shodanx/Dosimeter-Ultra-Micron/Платы/Ультра_разработка_остановлена/PCB_5.01/ProjectOutputs/Assembly2.png

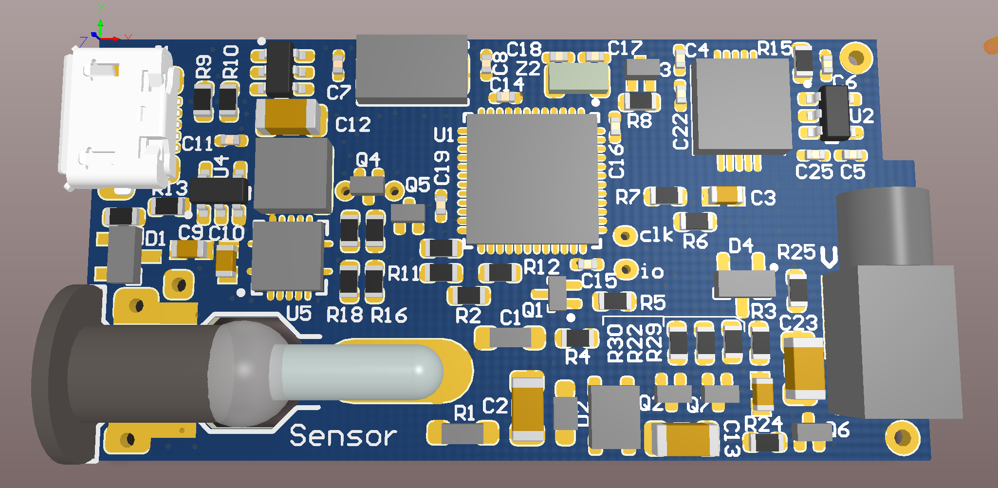
Платы/Ультра_разработка_остановлена/PCB_5.01/ProjectOutputs/Assembly2.png
