shodanx/Dosimeter-Ultra-Micron/readme.txt

ВНИМАНИЕ!!!
Новая прошивка оптимизированна под новую схемотехнику 4.06 и 5.01.
Требуется обязательная замена деталей:
C24 - GRM188R71H103KA01D
C3  - CC0603JRNPO9BN221
R6  - RC0603FR-07150KL
R7  - RC0603FR-074K53L
R29 - RC0603JR-07470RL
R30 - RC0603JR-07470RL
