shodanx/Dosimeter-Ultra-Micron/Ультра_разработка_остановлена/TPS62736)7_Design_Help_V1_2.xlsx

Sheet: 3-resistor
Note: Only valid for VIN_OK > VOUT
User Input | VBIAS | 1.21 | V
Fixed
 | Comparator thresholds for VOUT of buck
 | converter and input power good signal.
 | 1.3V < VOUT < 5.5V 2.0V < VIN_OK < 5.5V
Desired | RSUM1 | 13 | Mohm
Desired | VOUT | 3 | V
Desired | VIN_OK | 3.1 | V | >VOUT
 |  |  | closest 1% resistor1
 |  | Exact | < | >
Computed | R1 | 5.074 | 4.990 | 5.110 | Mohm
Computed | R2 | 0.169 | 0.169 | 0.174 | Mohm
Computed | R3 | 7.757 | 7.680 | 7.870 | Mohm
Computed | VOUT |  | 3.011 | 3.012 | V
Computed | VIN_OK |  | 3.113 | 3.115 | V
Selected | R1 | 5.1 | Mohm
Selected | R2 | 0.062 | Mohm
Selected | R3 | 7.5 | Mohm
Typ voltage | VOUT (typ) | 2.968 | V | -1.08 | % diff
Typ voltage | VIN_OK (typ) | 3.004 | V | -3.19 | % diff
 | 1If the available 1% resistors for the recommend resistor total (RSUM) produce too high of % difference, try using the closest 1% > and < resistor cross combo OR increasing or |  |  |  |  | 1% | 1%
 | decreasing RSUM in order to find a closer 1% resistor match OR adding 1 or more additional resistors and use two resistors in series that sum to the recommended value. |  |  |  |  | 10 | 10
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
