shodanx/Dosimeter-Ultra-Micron/Платы/Ультра_разработка_остановлена/PCB_5.00/share/readme.txt

Заказать платы можно тут: https://oshpark.com/shared_projects/7lkBk5aP
