shodanx/Dosimeter-Ultra-Micron/Платы/Ультра_разработка_остановлена/PCB_5.01/ProjectOutputs/readme.txt

Заказать платы можно тут: https://oshpark.com/shared_projects/ZgO3a8J9
