shodanx/Dosimeter-Ultra-Micron/Ультра_разработка_остановлена/Расчет токовой кривой, в проэкции на общее время работы дозика.pdf

9.2.2014 | Форум РадиоКот • Центр пользователя • Просмотр сообщений

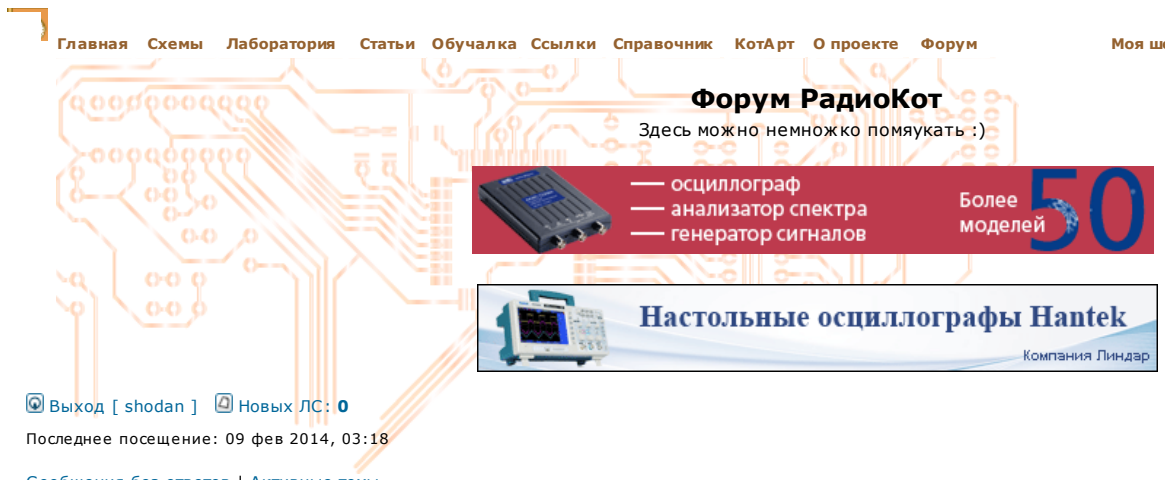
[picture p4: figure]
Форум РадиоКот; Здесь можно немножко помяукать :)
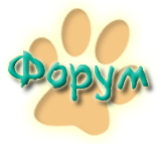
[picture p5: figure]

http://radiokot.ru/forum/ucp.php?i=pm&mode=view&f=-1&p=536878 | 1/4
Список форумов (http://radiokot.ru/forum/index.php) | Часовой пояс: UTC + 3 часа
Сообщения без ответов (http://radiokot.ru/forum/search.php?search_id=unanswered) | Активные темы (http://radiokot.ru/forum/search.php?search_id=active_topics) | Непрочитанные сообщения (http://radiokot.ru/forum/search.php?search_id=unreadposts) | Новые сообщения (http://radiokot.ru/forum/search.php?search_id=newposts) | Ваши сообщения (http://radiokot.ru/forum/search.php?search_id=egosearch)
Выход [ shodan ] (http://radiokot.ru/forum/ucp.php?mode=logout&sid=c923735fc91bc05e12e299eb70344504) | Новых ЛС: 0 (http://radiokot.ru/forum/ucp.php?i=pm&folder=inbox) | Правила (http://radiokot.ru/forum/viewtopic.php?f=19&t=6538) | FAQ (http://radiokot.ru/forum/faq.php) | Поиск (http://radiokot.ru/forum/search.php) | Пользователи (http://radiokot.ru/forum/memberlist.php) | Центр пользователя (http://radiokot.ru/forum/ucp.php)
Последнее посещение: 09 фев 2014, 03:18 | Текущее время: 09 фев 2014, 06:06

Настройки

Обзор (http://radiokot.ru/forum/ucp.php?i=171)
Профиль (http://radiokot.ru/forum/ucp.php?i=172)
Настройки форума (http://radiokot.ru/forum/ucp.php?i=173)
Личные сообщения
» Входящие (http://radiokot.ru/forum/ucp.php?i=pm&folder=inbox)
» Исходящие (1) (http://radiokot.ru/forum/ucp.php?i=pm&folder=outbox)
» Отправленные (http://radiokot.ru/forum/ucp.php?i=pm&folder=sentbox)
» Новое сообщение (http://radiokot.ru/forum/ucp.php?i=pm&mode=compose)
» Управление
черновиками (http://radiokot.ru/forum/ucp.php?i=pm&mode=drafts)
» Правила, папки и
настройки (http://radiokot.ru/forum/ucp.php?i=pm&mode=options)

Группы (http://radiokot.ru/forum/ucp.php?i=175)
Друзья и недоброжелатели (http://radiokot.ru/forum/ucp.php?i=176)

Друзья

В сети
Нет друзей в сети
Предыдущее ЛС в архиве (http://radiokot.ru/forum/ucp.php?i=pm&p=536927) | Следующее ЛС в архиве (http://radiokot.ru/forum/ucp.php?i=pm&p=536595) | Предыдущее ЛС (http://radiokot.ru/forum/ucp.php?i=pm&f=-1&p=536878&view=previous) | Следующее ЛС (http://radiokot.ru/forum/ucp.php?i=pm&f=-1&p=536878&view=next)
Тема сообщения: | Re: нанит
От: | shodan (http://radiokot.ru/forum/memberlist.php?mode=viewprofile&u=73030)
Отправлено: | 09 фев 2014, 00:49
Кому: | MadOrc (http://radiokot.ru/forum/memberlist.php?mode=viewprofile&u=83083)

Сообщение

Поимел накачку в разных позах, решил что коррекция относительно напряжения АКБ бессмысленна при питании 3.3В(нижний порог моего дозика) = 375 вольт
при питании 4.2В = 392 вольта
получается на весь диапазон дифирент всего-то = 17 вольт, фигня короче!

Проверил идею самоподстройки интервала времени, отладил саму накачку вроде все гуд. при обычной работе на одном и том-же напряжении питания, по моему гига-омм-замерялке шум(просадки между накачками) укладывается в 7-8 вольтов. что тоже весьма зачетно!

Главная (http://radiokot.ru/) Схемы (http://radiokot.ru/circuit) | Лаборатория (http://radiokot.ru/lab) | Статьи (http://radiokot.ru/articles) Обучалка (http://radiokot.ru/start) Ссылки (http://radiokot.ru/links) Справочник (http://radiokot.ru/inquiry) | КотАрт (http://radiokot.ru/art) О проекте (http://radiokot.ru/about) | Форум (http://radiokot.ru/forum) | Моя шерсть (http://radiokot.ru/profile/)

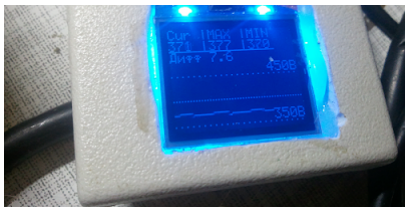
[picture p6: figure]
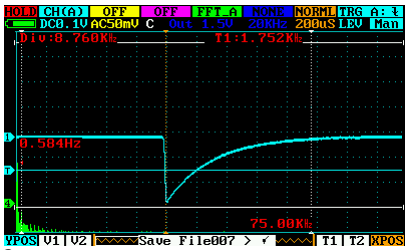
[picture p7: figure]

http://radiokot.ru/forum/ucp.php?i=pm&mode=view&f=-1&p=536878 | 2/4

Нет друзей в сети
Не в сети Wirehead Дмитрий2012 (http://radiokot.ru/forum/memberlist.php?mode=viewprofile&u=73240)

А ГЛАВНОЕ!!! калибровать напряжение очень удобно, при подключении тестера сразу видно реальное фактическое напряжение, при отключении идет небольшой выброс, потом за секунду все нормализуется, и через 10 сек, мы возвращаемся к интервалу 1 импульс накачки в 2-4 секунды.
Я на этот случай сделал исключение, если импульсов накачки очень много, то интервал между накачками резко сокращается.

Это снято с резистора накачки в момент качания, а терь я расскажу методу подсчета энергии на накачку.
Берем клеточку, смотрим где там среднее значение по вольтажу, считаем ток по клеточкам, с учетом того что граффик снят с резистора 33R. 7мА+3мА+2.1мА+1.5мА+1мА+0.5мА=15.6мА за период 1.2 мс
Такая накачка вызывается 1 раз в 2 секунды, значит скваженность равна
2/0.0012 = 1/1667
15.6мА/1667=9.35мкА среднее постоянное потребление накачки

за месяц это сожрет акб на 9.35мкА*24*30=6.73мА/ч, це ж есть эффиктивность мать ее! Правда одной конкретно взятой накачки, без учета проца и прочего обвеса.

С учетом ошибки измерения/вычесления, можно округлить до отедания емкости 7.5мА/ч за месяц работы на ЕРФ.
Значит, чтобы на моем АКБ 60 мАч устройство во сне работало 3 месяца, надо все остальные потери уложить в отедание не более 12.5 мА/ч за месяц. В принципе эта задача представляется мне вполне решаемой.

т.е. мы по сути посчитали токовую площадь кривой, и учли насколько часто этот расход появляется.

http://radiokot.ru/forum/ucp.php?i=pm&mode=view&f=-1&p=536878 | 3/4
Тема сообщения: Re: нанит | Папка: Исходящи (http://radiokot.ru/forum/ucp.php?i=pm&folder=-2)
Тема сообщения: Re: нанит | Папка: Отправленны (http://radiokot.ru/forum/ucp.php?i=pm&folder=-1)
Список форумов (http://radiokot.ru/forum/index.php) | Часовой пояс: UTC + 3 часа

т.е. мы по сути посчитали токовую площадь кривой, и учли насколько часто этот расход появляется.
и не надо никаких там тебе мультиметров, нужен хорошо калиброванный по вольтажу осцыл, пусть даже простой цифровой как у мя.

ТОЧНО ТАКЖЕ считается потребление всего дозика в целом, но с учетом еще постоянного тока сна.

Вложения:
IMAG007.png (http://radiokot.ru/forum/download/file.php?id=174561) [7.42 KiB]

Скачиваний: 16
2014-02-09 00.47.45.png (http://radiokot.ru/forum/download/file.php?id=174550) [244.55 KiB] Скачиваний: 27

_________________
Все наработки по проектам находятся у меня на сайте, и FTP. (см. профиль) С уважением R3PAV, всем 73!

Последний раз редактировалось shodan 09 фев 2014, 05:46, всего редактировалось 9 раз(а).

Для печати (http://radiokot.ru/forum/ucp.php?i=pm&f=-1&p=536878&view=print) | Входящие | Переместить в папку

История сообщений - Re: нанит

Автор | Сообщение
shodan (http://radiokot.ru/forum/memberlist.php?mode=viewprofile&u=73030)
недописал

Ранее на трансе в Альфа-Микроне я даже близко не подходил к таким показателям из за зазора, который требовал большие токи раскачки, хоть и кратковременные. Получалась пачка из 10-15 сверхтоковых всплесков. циферки принципиально иные.
А тут достаточно 1-го импульса который жрет не так уж и много.
про микрон-2 я уже говорил там в основном кушает DC-DC причем очень много! да и умножайка течет тремя кондерами а тут кондер 1 !

короче вот те пища для размышления
Отправлено: 09 фев 2014, 05:5

Посмотреть сообщение (http://radiokot.ru/forum/ucp.php?i=pm&f=-2&p=536927)
shodan (http://radiokot.ru/forum/memberlist.php?mode=viewprofile&u=73030)

Powered by phpBB (http://www.phpbb.com/) © 2000, 2002, 2005, 2007 phpBB Group Русская поддержка phpBB (http://bb3x.ru/)
Extended by Karma MOD (http://m157y.name/) © 2007—2012 m157y Extended by Topic Tags MOD (http://m157y.name/) © 2012 m157y

http://radiokot.ru/forum/ucp.php?i=pm&mode=view&f=-1&p=536878 | 4/4

Работоспособность сайта проверена в браузерах:
IE8.0, Opera 9.0, Netscape Navigator 7.0, Mozilla Firefox 5.0
Адаптирован для работы приразрешениях экрана от 1280х1024 и выше. Применьших разрешениях возможно появление горизонтальной прокрутки. По всем вопросам обращайтесь к Коту: kot@radiokot.ru ©2005-2014
