shodanx/Dosimeter-Ultra-Micron/foto/buiy6tfg2.jpg

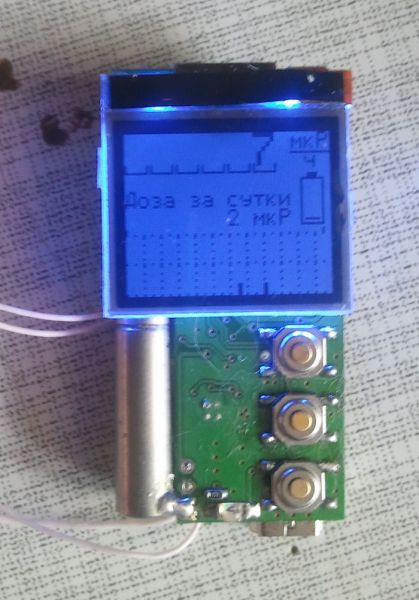
foto/buiy6tfg2.jpg
