shodanx/Dosimeter-Ultra-Micron/foto/c1zz0v28i.jpg

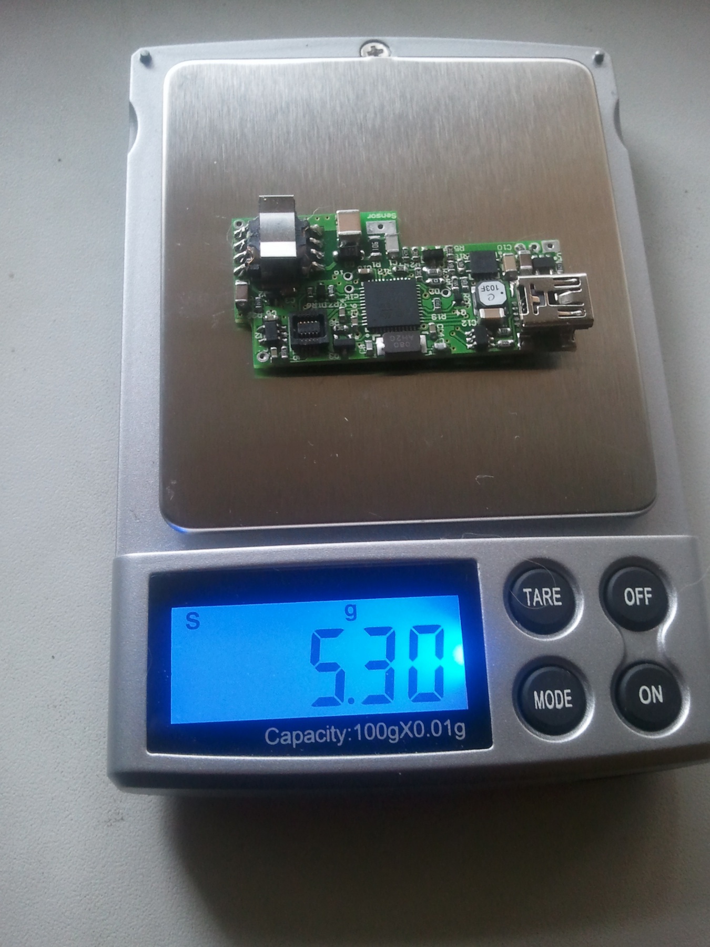
foto/c1zz0v28i.jpg
