shodanx/Dosimeter-Ultra-Micron/foto/c75gukmy7.jpg

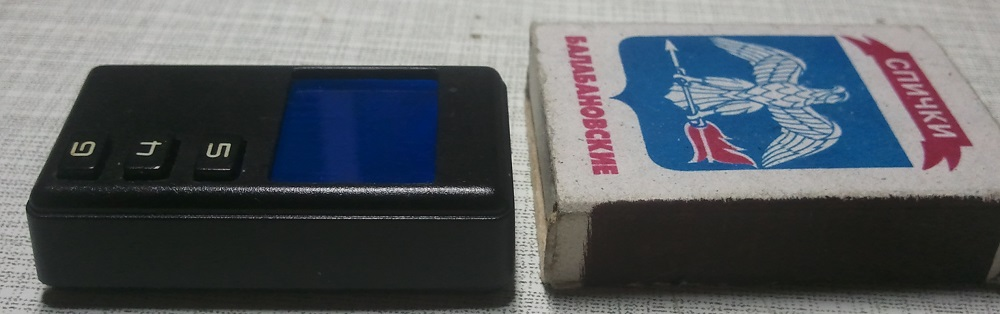
foto/c75gukmy7.jpg
