shodanx/Dosimeter-Ultra-Micron/foto/c75guoe4d.jpg

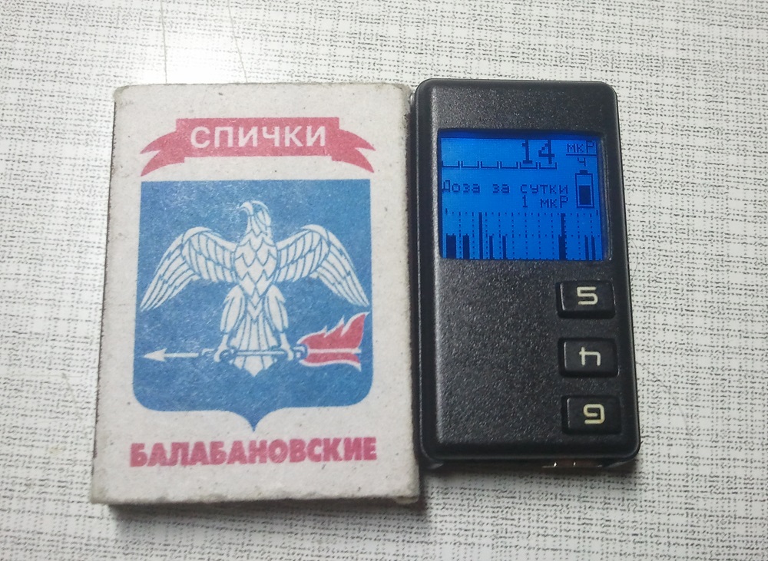
foto/c75guoe4d.jpg
