shodanx/Dosimeter-Ultra-Micron/foto/c75guspa1.jpg

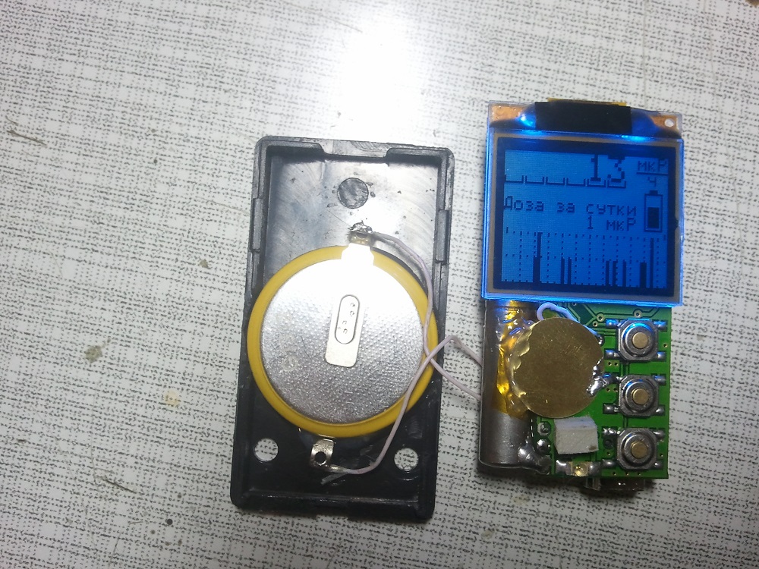
foto/c75guspa1.jpg
