shodanx/Dosimeter-Ultra-Micron/foto/cbergvxuc.JPG

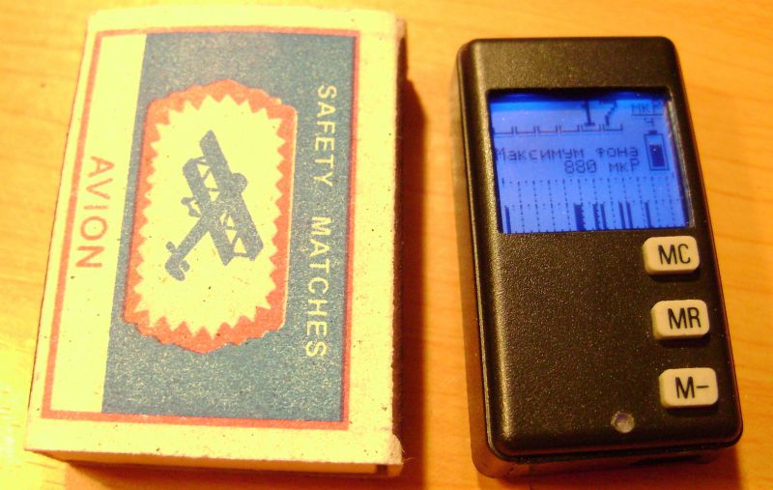
foto/cbergvxuc.JPG
