shodanx/Dosimeter-Ultra-Micron/foto/daniel13/IMG_2258.JPG

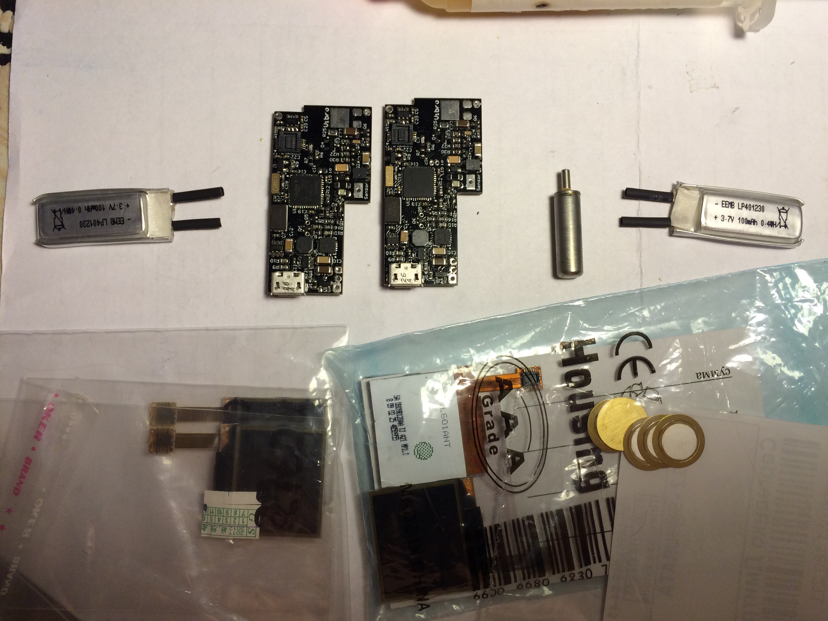
foto/daniel13/IMG_2258.JPG
