shodanx/Dosimeter-Ultra-Micron/foto/daniel13/IMG_2261.JPG

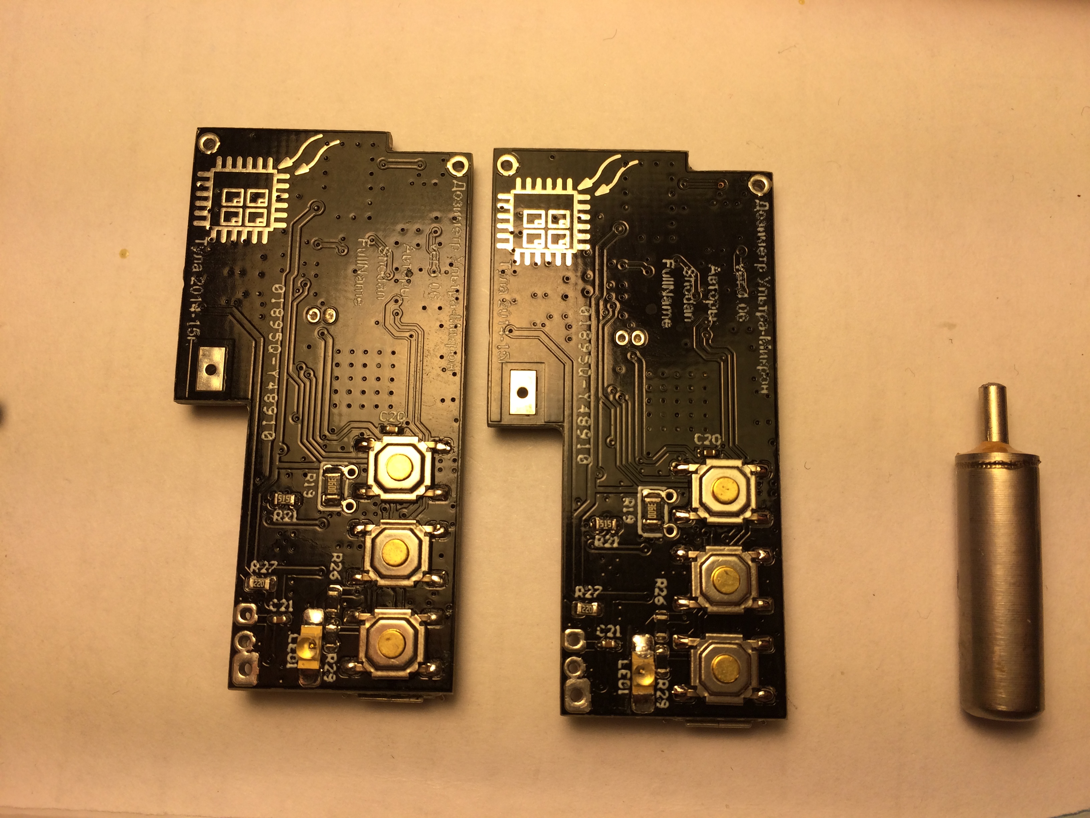
foto/daniel13/IMG_2261.JPG
