shodanx/Dosimeter-Ultra-Micron/foto/FullName/0_c64a0_bf9c8d35_XL.jpg

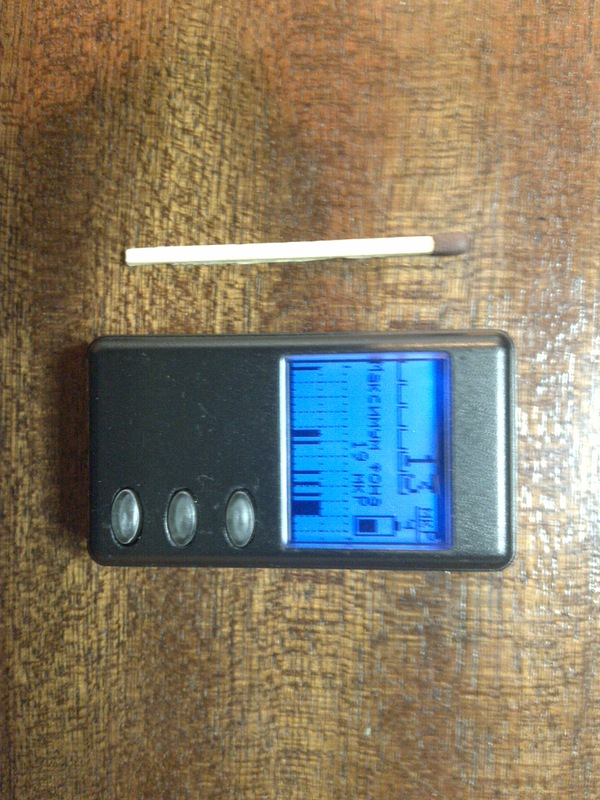
foto/FullName/0_c64a0_bf9c8d35_XL.jpg
