shodanx/Dosimeter-Ultra-Micron/foto/FullName/0_c553f_7884af77_XL.jpg

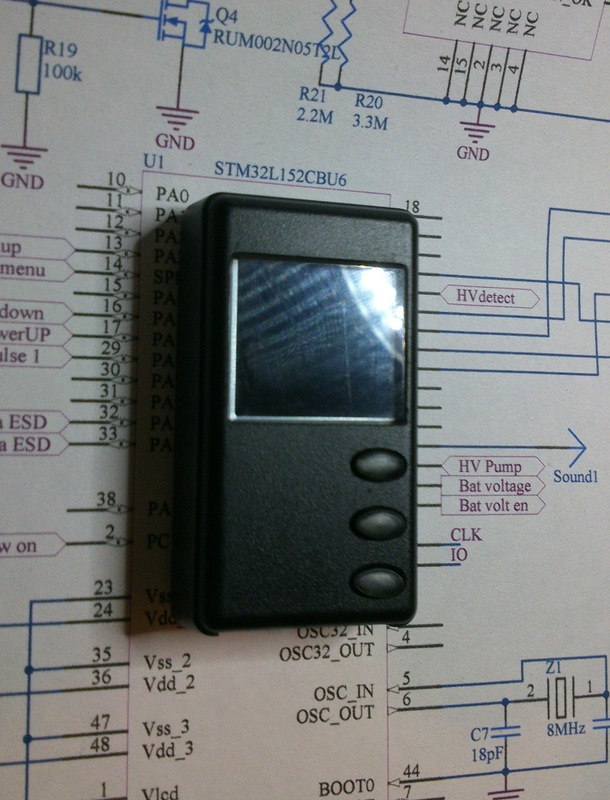
foto/FullName/0_c553f_7884af77_XL.jpg
