shodanx/Dosimeter-Ultra-Micron/foto/FullName/0_c649a_e8f3dfc0_XL.jpg

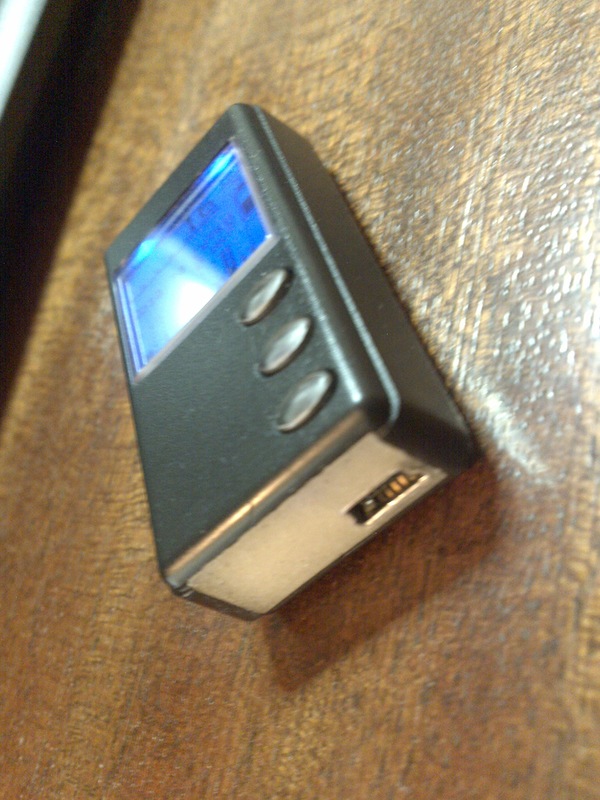
foto/FullName/0_c649a_e8f3dfc0_XL.jpg
