shodanx/Dosimeter-Ultra-Micron/foto/FullName/0_c649b_704d4964_XL.jpg

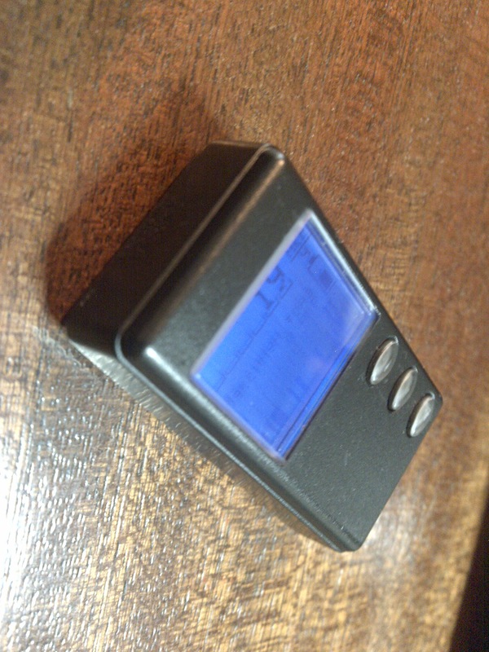
foto/FullName/0_c649b_704d4964_XL.jpg
