shodanx/Dosimeter-Ultra-Micron/foto/FullName/0_c649c_5c795b95_XL.jpg

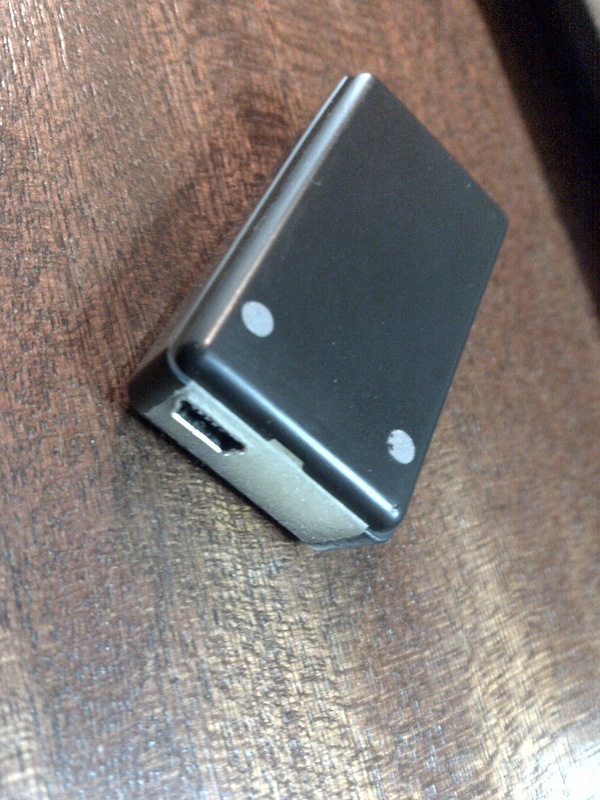
foto/FullName/0_c649c_5c795b95_XL.jpg
