shodanx/Dosimeter-Ultra-Micron/foto/FullName/0_c649e_258df4d4_XL.jpg

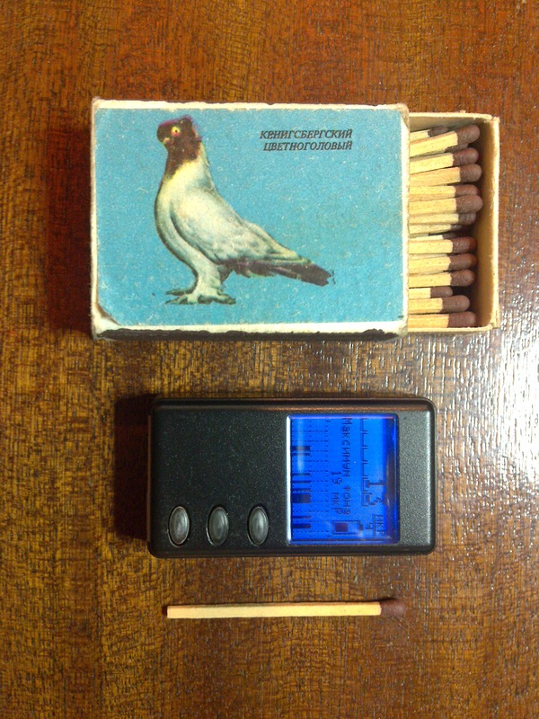
foto/FullName/0_c649e_258df4d4_XL.jpg
