shodanx/Dosimeter-Ultra-Micron/foto/FullName/0_c6496_6fbf92ec_XL.jpg

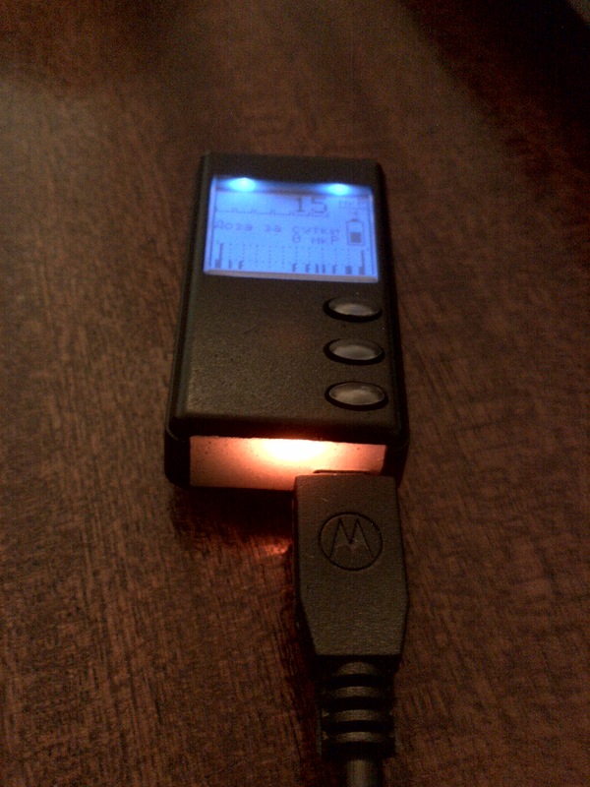
foto/FullName/0_c6496_6fbf92ec_XL.jpg
