shodanx/Dosimeter-Ultra-Micron/foto/FullName/0_c6497_fcf5d7cc_XL.jpg

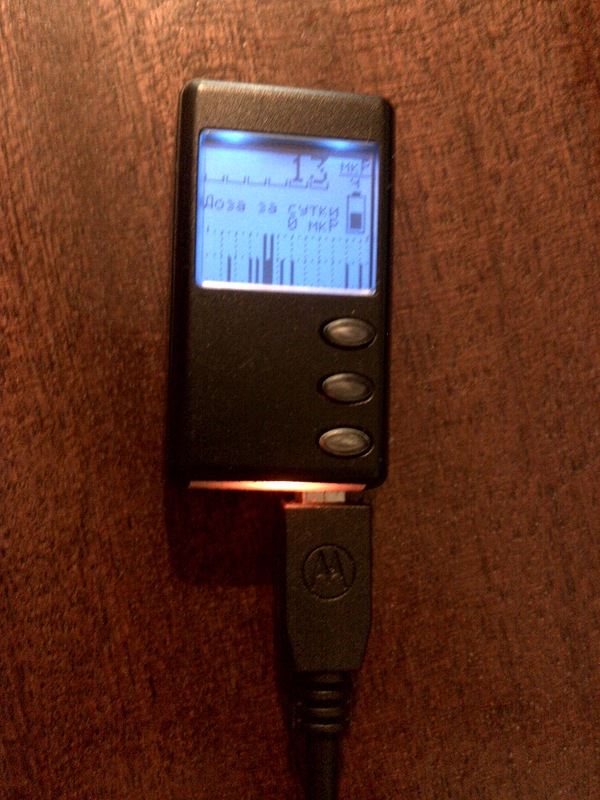
foto/FullName/0_c6497_fcf5d7cc_XL.jpg
