shodanx/Dosimeter-Ultra-Micron/foto/Hausser/2014/DSC07499.JPG

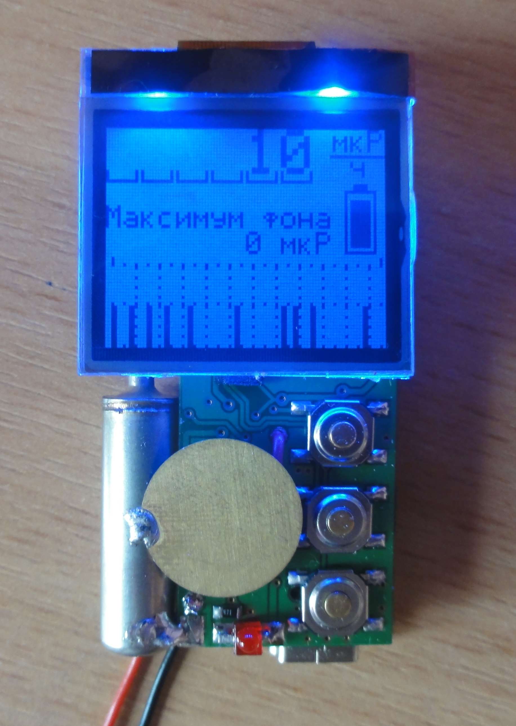
foto/Hausser/2014/DSC07499.JPG
