shodanx/Dosimeter-Ultra-Micron/foto/Hausser/2014/DSC07503.JPG

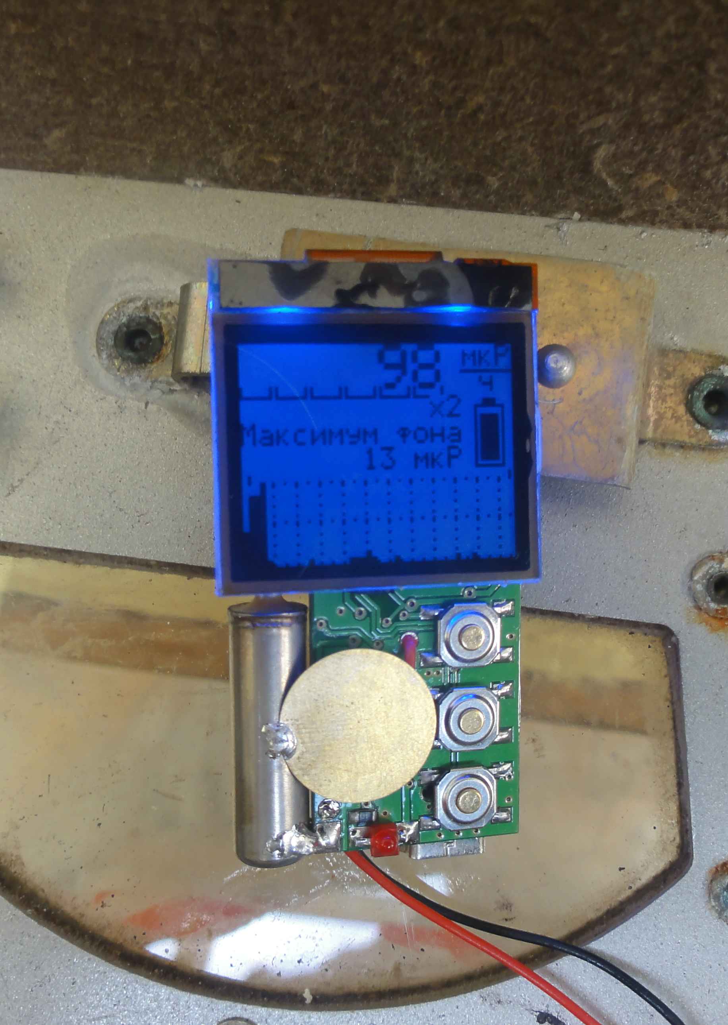
foto/Hausser/2014/DSC07503.JPG
