shodanx/Dosimeter-Ultra-Micron/foto/Hausser/2014/DSC07506.JPG

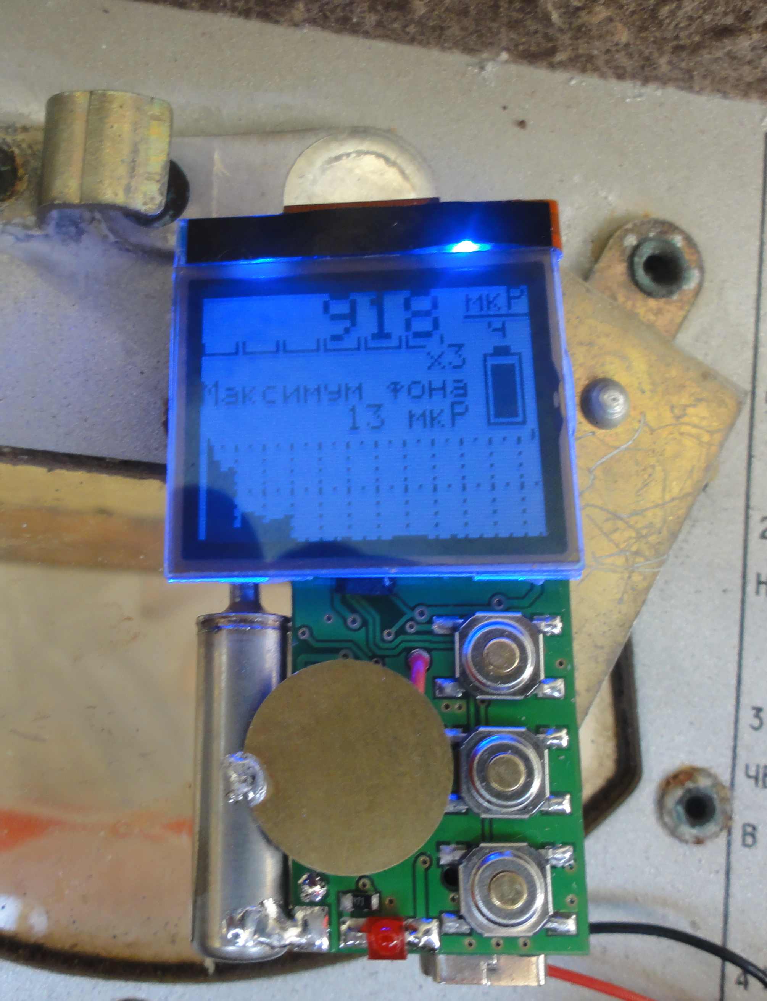
foto/Hausser/2014/DSC07506.JPG
