shodanx/Dosimeter-Ultra-Micron/foto/Hausser/2014/DSC07509.JPG

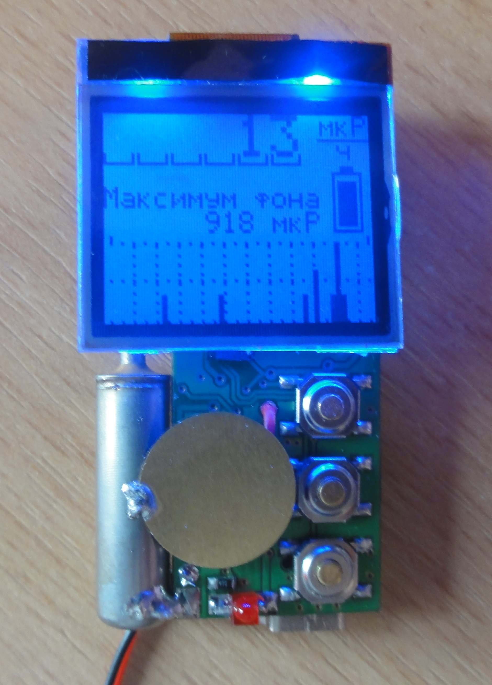
foto/Hausser/2014/DSC07509.JPG
