shodanx/Dosimeter-Ultra-Micron/foto/Hausser/2014/DSC07518.JPG

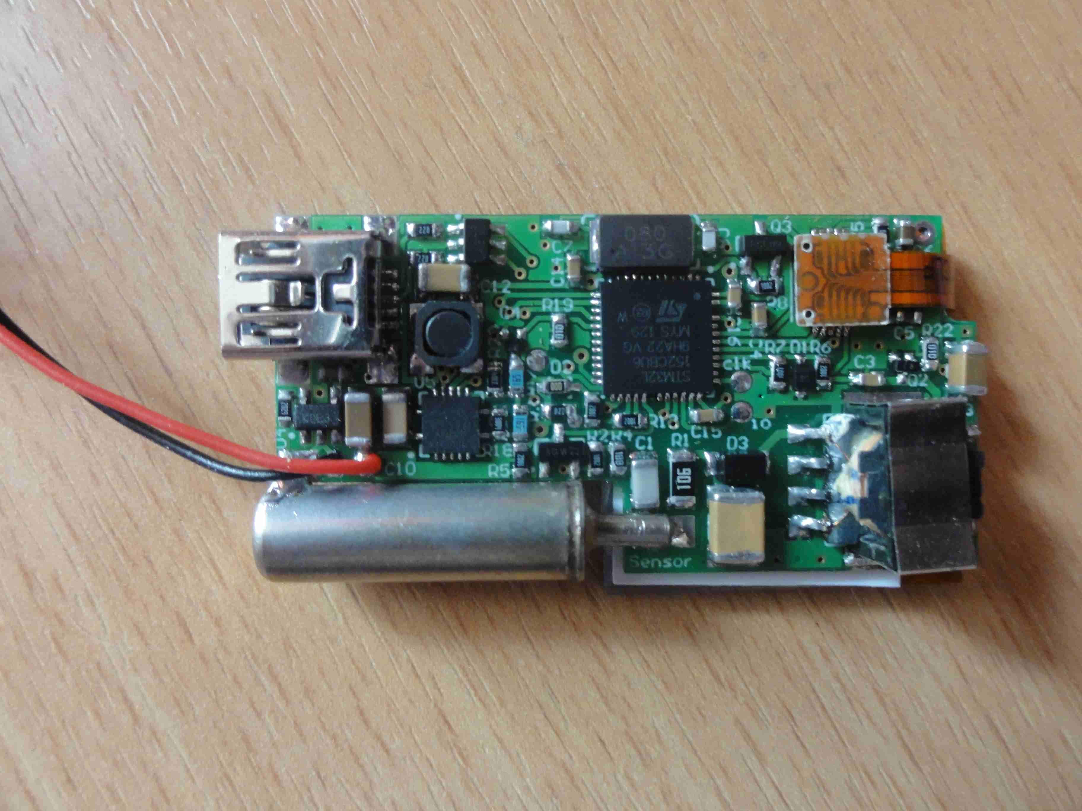
foto/Hausser/2014/DSC07518.JPG
