shodanx/Dosimeter-Ultra-Micron/foto/Hausser/2014/DSC07527.JPG

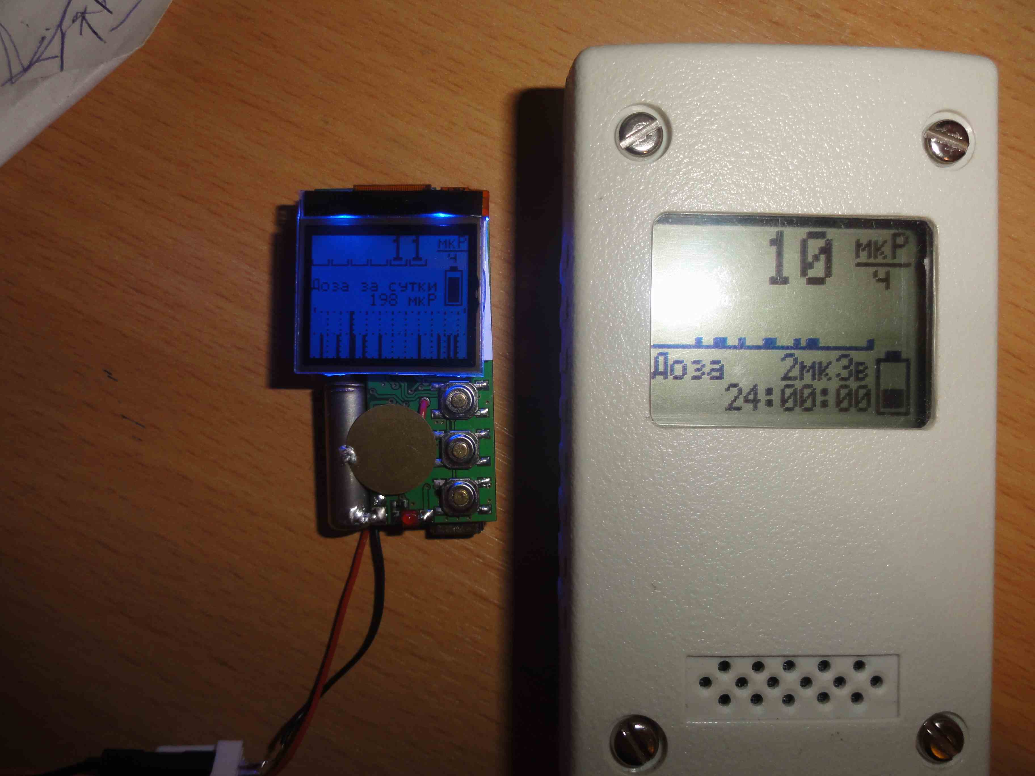
foto/Hausser/2014/DSC07527.JPG
