shodanx/Dosimeter-Ultra-Micron/foto/Hausser/2016/DSC08218.JPG

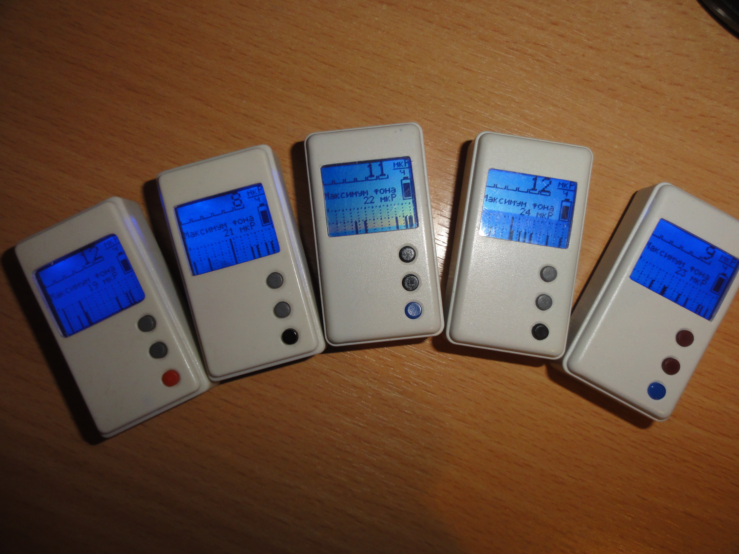
foto/Hausser/2016/DSC08218.JPG
