shodanx/Dosimeter-Ultra-Micron/foto/Hausser/2016/DSC08233.JPG

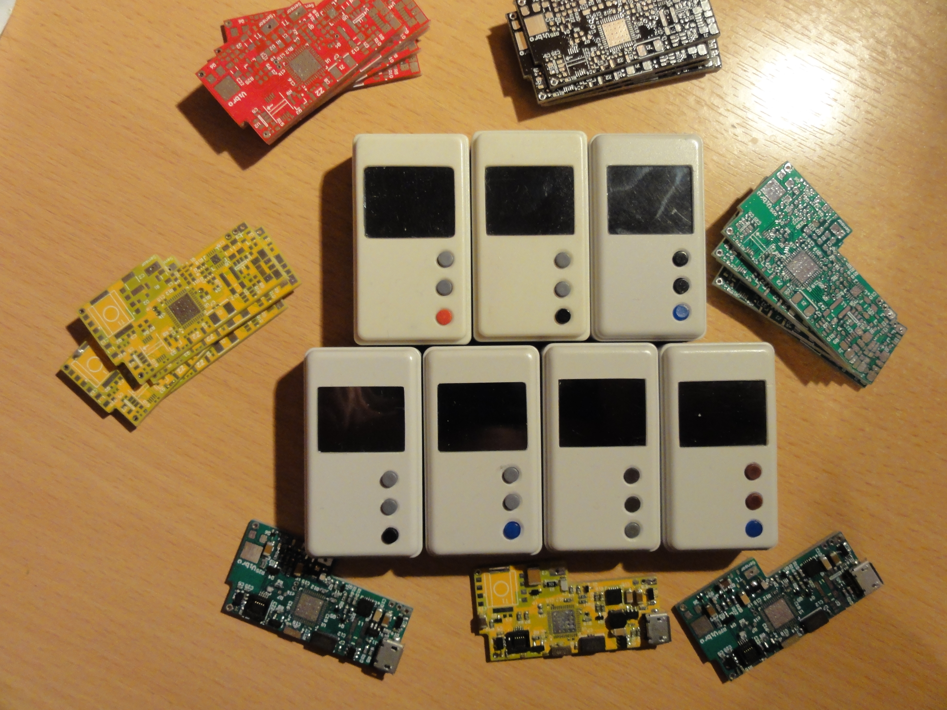
foto/Hausser/2016/DSC08233.JPG
