shodanx/Dosimeter-Ultra-Micron/foto/Hausser/2016/DSC08236.JPG

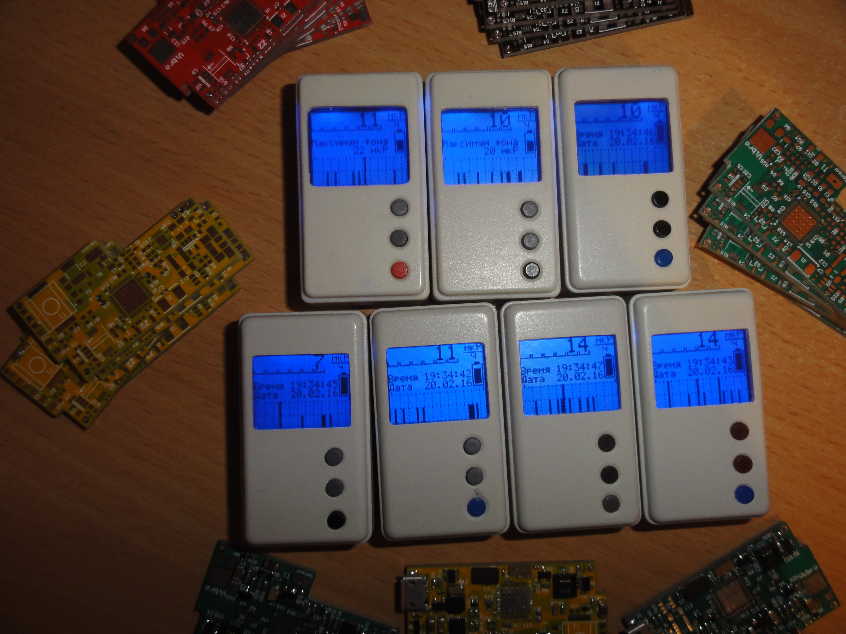
foto/Hausser/2016/DSC08236.JPG
