shodanx/Dosimeter-Ultra-Micron/foto/Hausser/2016/DSC08241.JPG

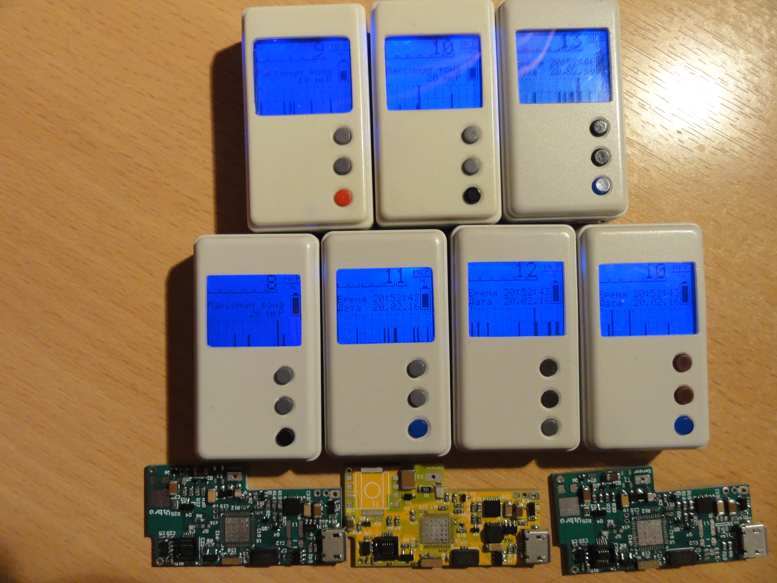
foto/Hausser/2016/DSC08241.JPG
