shodanx/Dosimeter-Ultra-Micron/foto/Hausser/2016/DSC08242.JPG

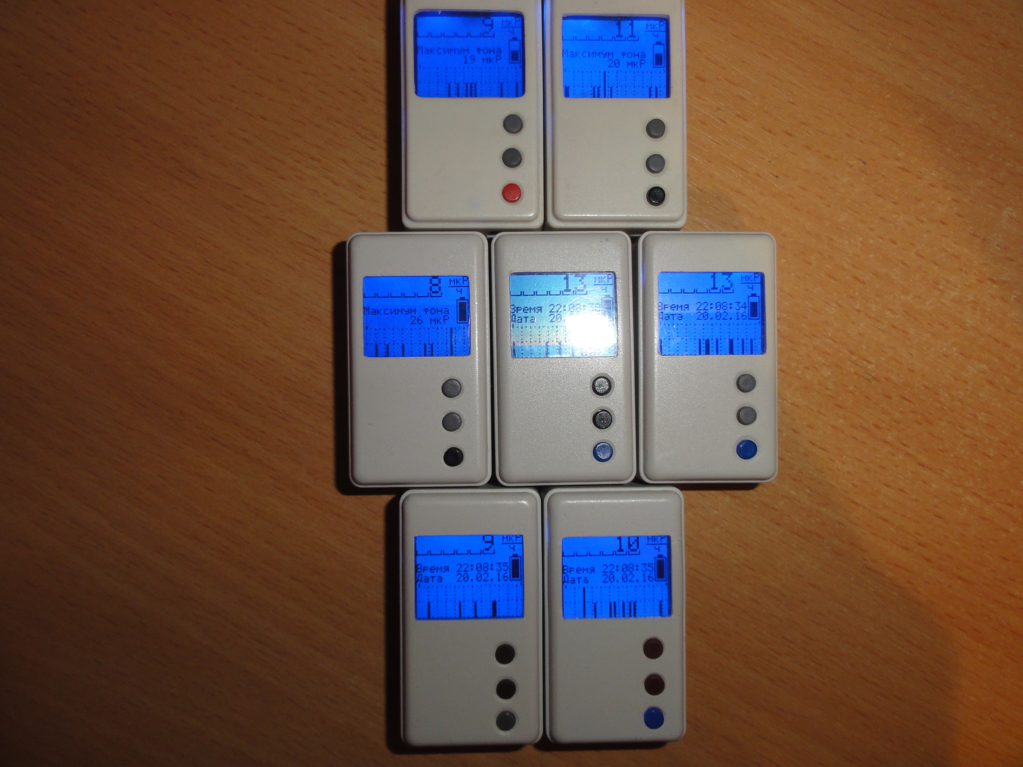
foto/Hausser/2016/DSC08242.JPG
