shodanx/Dosimeter-Ultra-Micron/foto/Nusik1975/2014-07-01 10.42.14.jpg

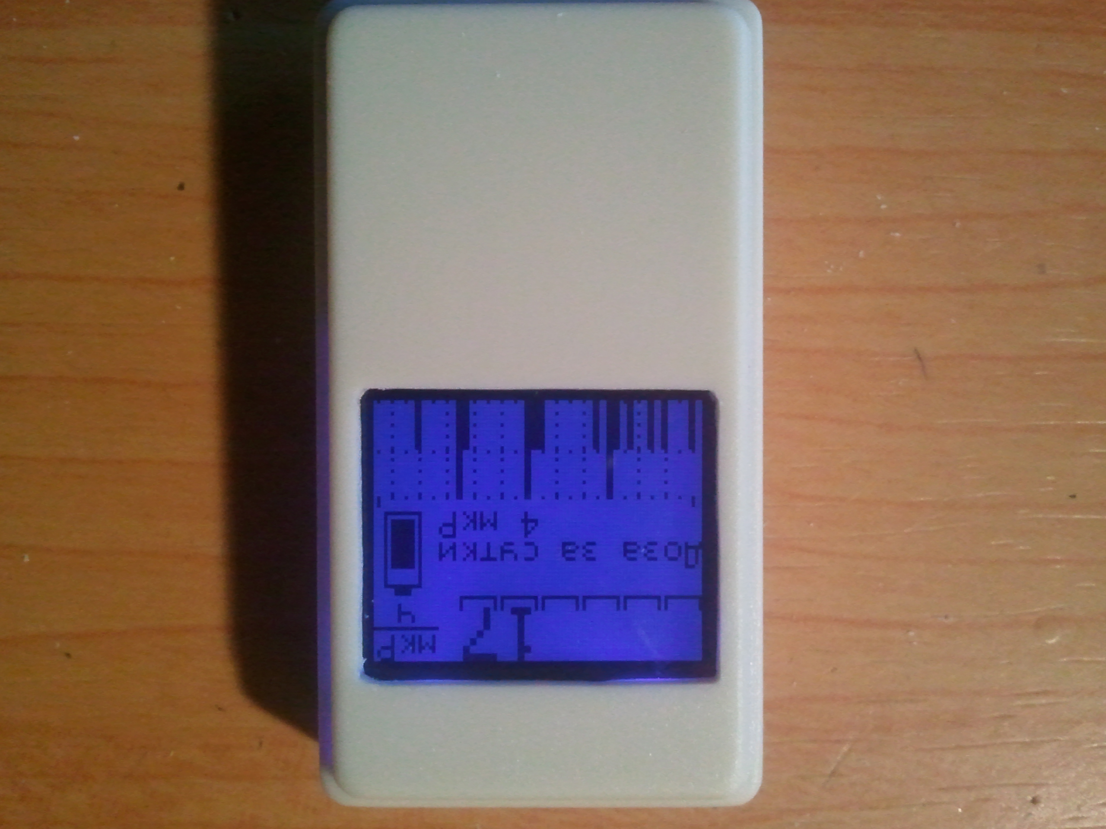
foto/Nusik1975/2014-07-01 10.42.14.jpg
