shodanx/Dosimeter-Ultra-Micron/foto/Nusik1975/2014-07-01 22.47.53.jpg

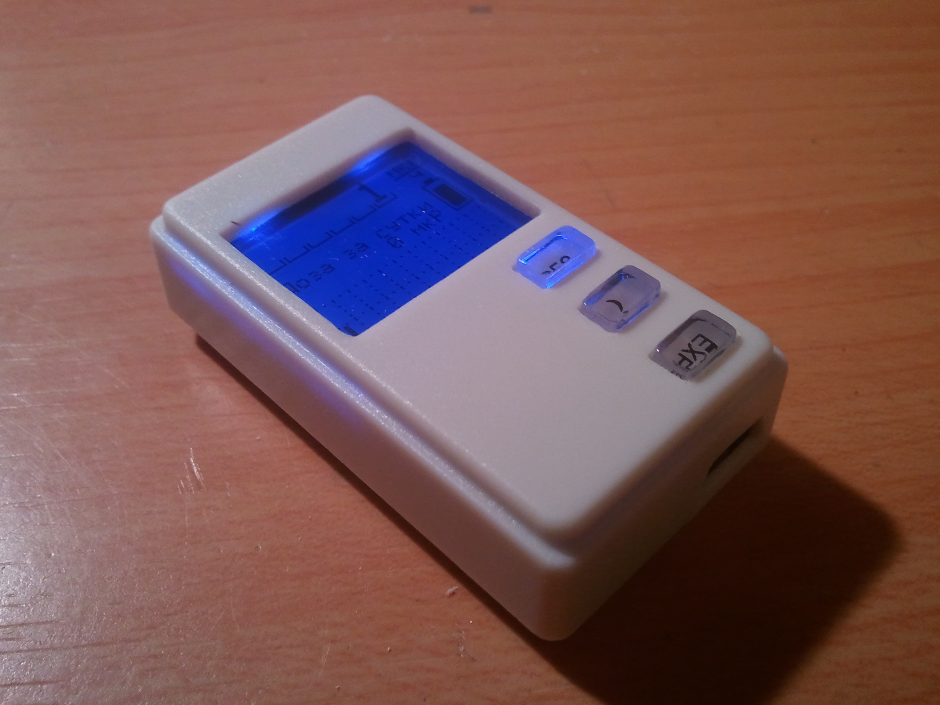
foto/Nusik1975/2014-07-01 22.47.53.jpg
