shodanx/Dosimeter-Ultra-Micron/foto/Nusik1975/DSC00402.JPG

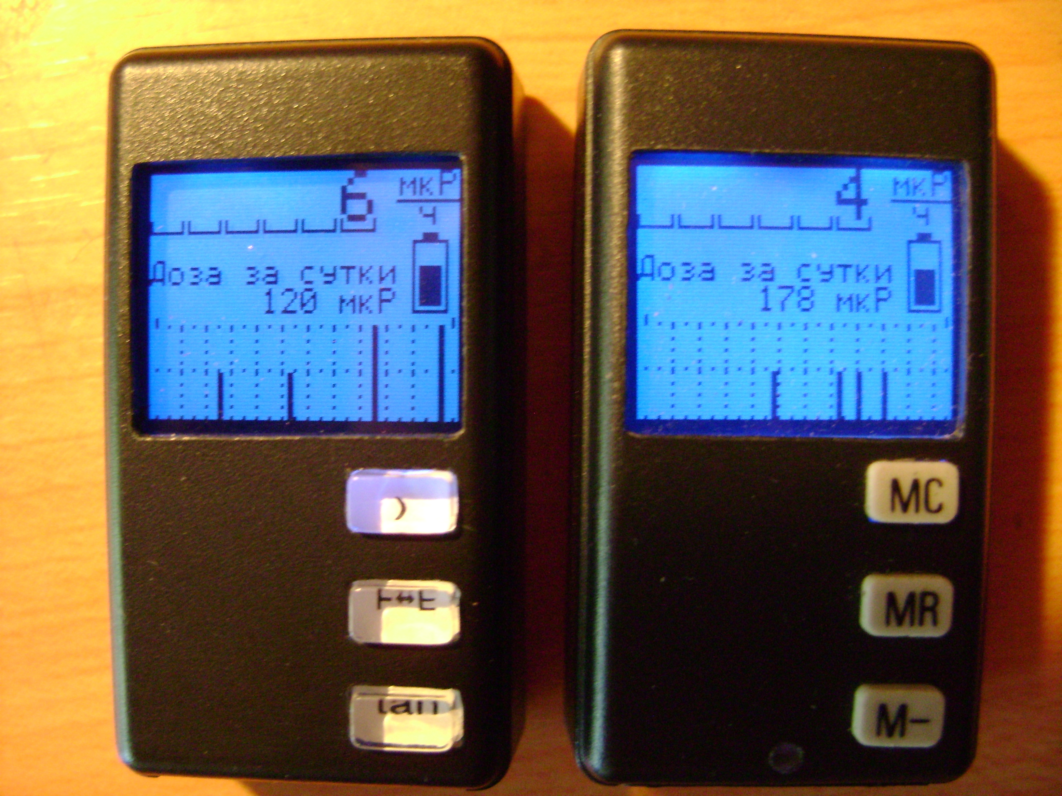
foto/Nusik1975/DSC00402.JPG
