shodanx/Dosimeter-Ultra-Micron/foto/Nusik1975/DSC00403.JPG

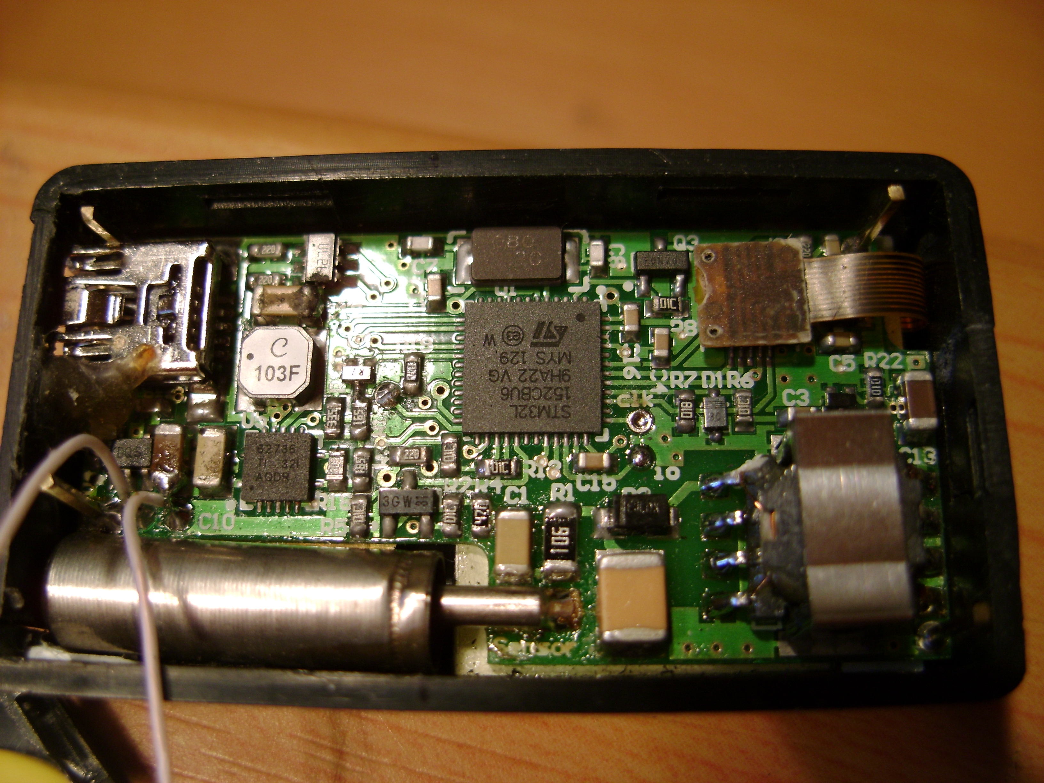
foto/Nusik1975/DSC00403.JPG
