shodanx/Dosimeter-Ultra-Micron/foto/X-RAY 5.01/Gamma-__+_.jpg

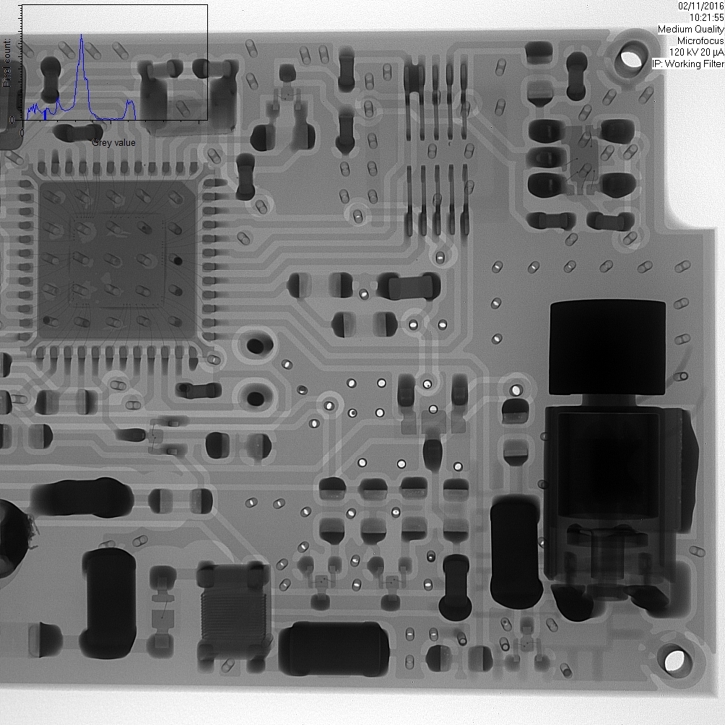
foto/X-RAY 5.01/Gamma-__+_.jpg
