shodanx/Dosimeter-Ultra-Micron/foto/X-RAY 5.01/Gamma-__.jpg

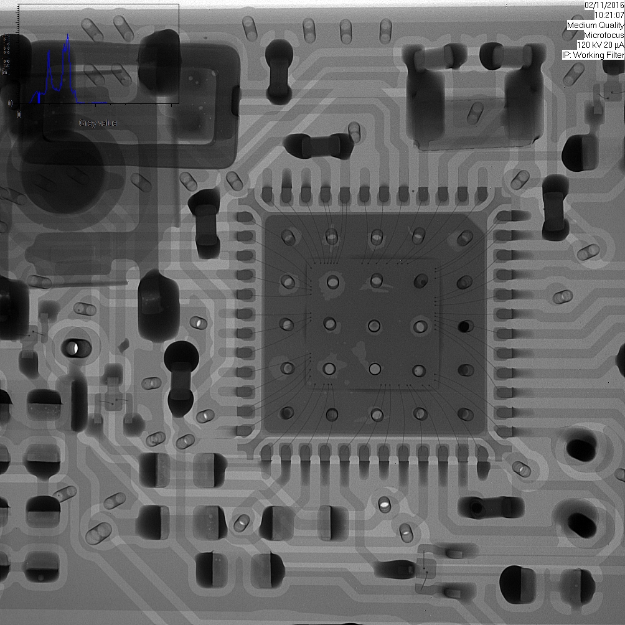
foto/X-RAY 5.01/Gamma-__.jpg
