shodanx/Dosimeter-Ultra-Micron/foto/X-RAY 5.01/Gamma-___+_.jpg

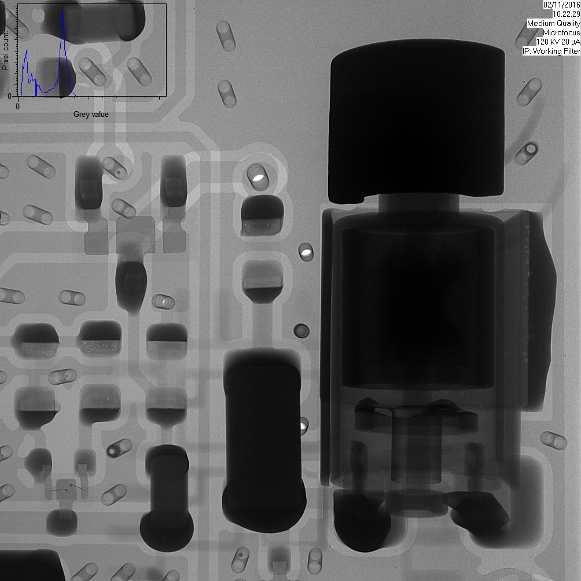
foto/X-RAY 5.01/Gamma-___+_.jpg
