shodanx/Dosimeter-Ultra-Micron/foto/X-RAY 5.01/Gamma.jpg

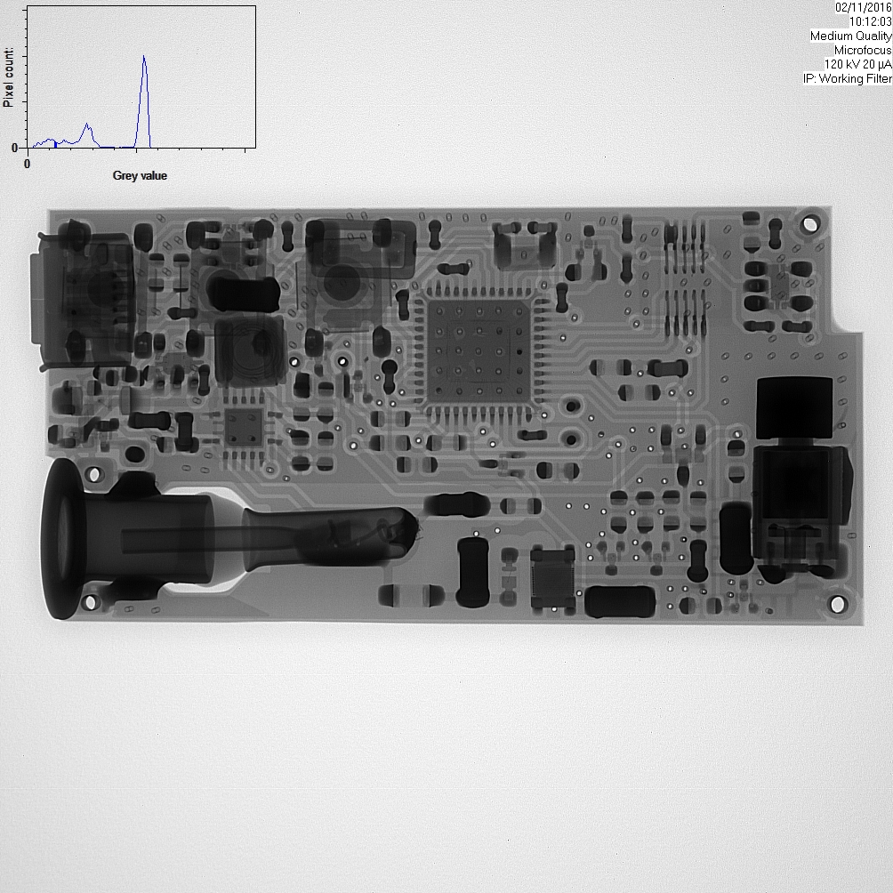
foto/X-RAY 5.01/Gamma.jpg
