shodanx/Dosimeter-Ultra-Micron/foto/X-RAY 5.01/Gamma__.jpg

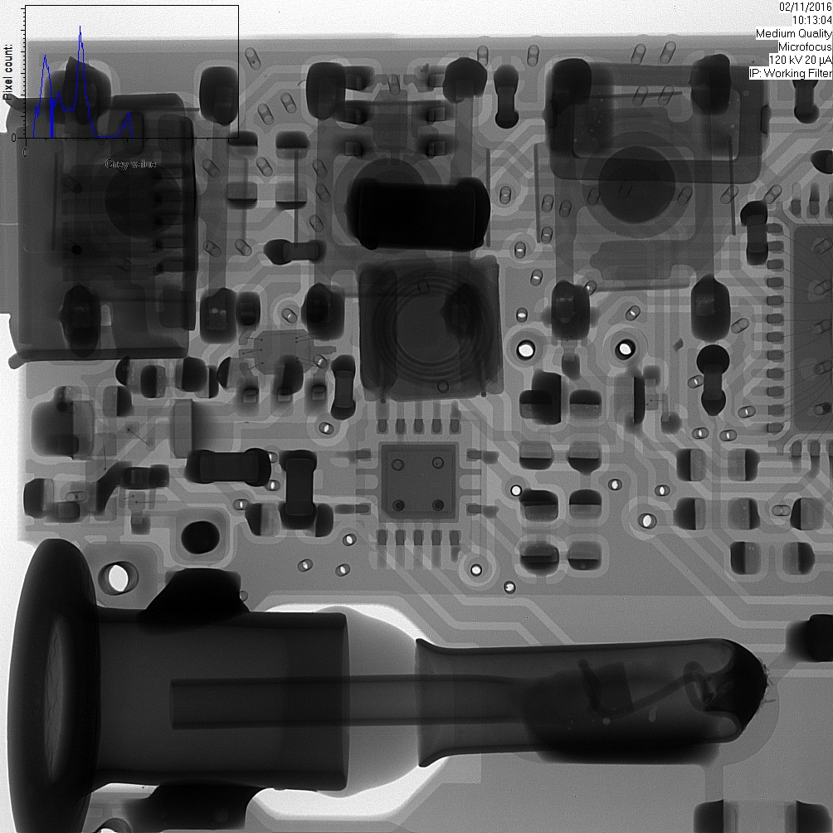
foto/X-RAY 5.01/Gamma__.jpg
