shodanx/Dosimeter-Ultra-Micron/Платы/PCB/scope_0.png

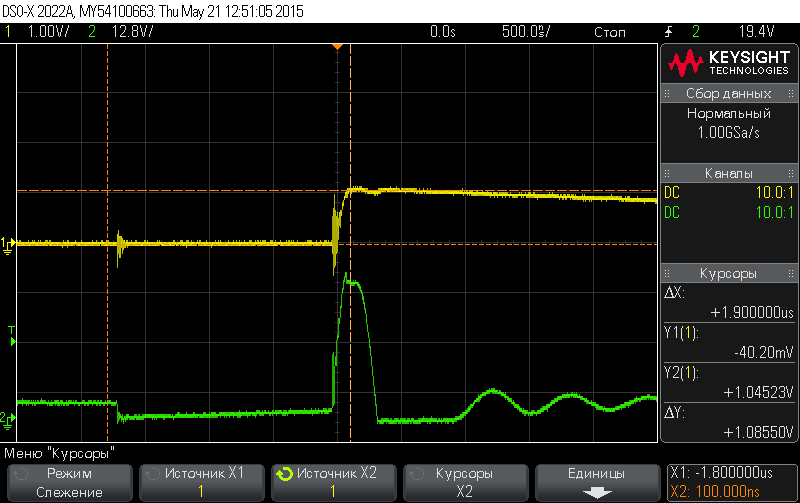
Платы/PCB/scope_0.png
