shodanx/Dosimeter-Ultra-Micron/Платы/PCB/scope_1.png

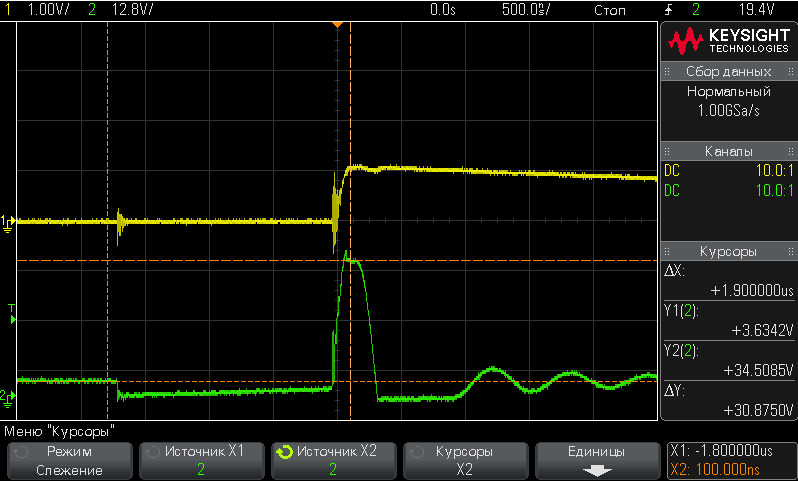
Платы/PCB/scope_1.png
