shodanx/Dosimeter-Ultra-Micron/Ультра_разработка_остановлена/2.png

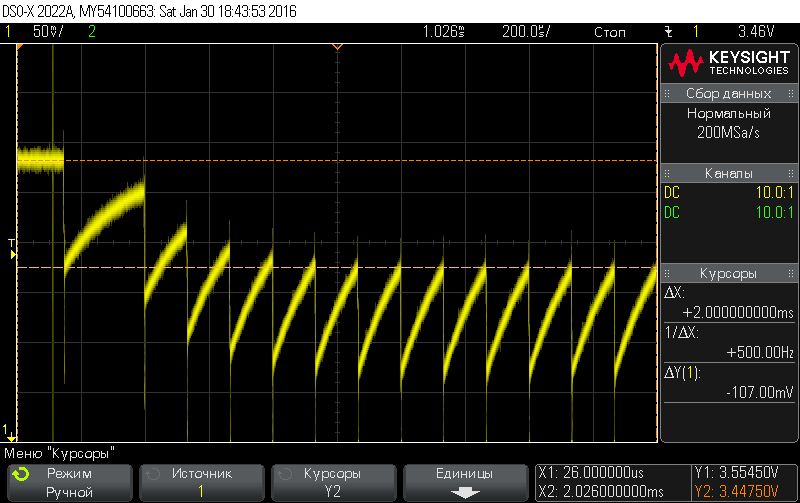
Ультра_разработка_остановлена/2.png
