shodanx/Dosimeter-Ultra-Micron/Ультра_разработка_остановлена/scope_1.png

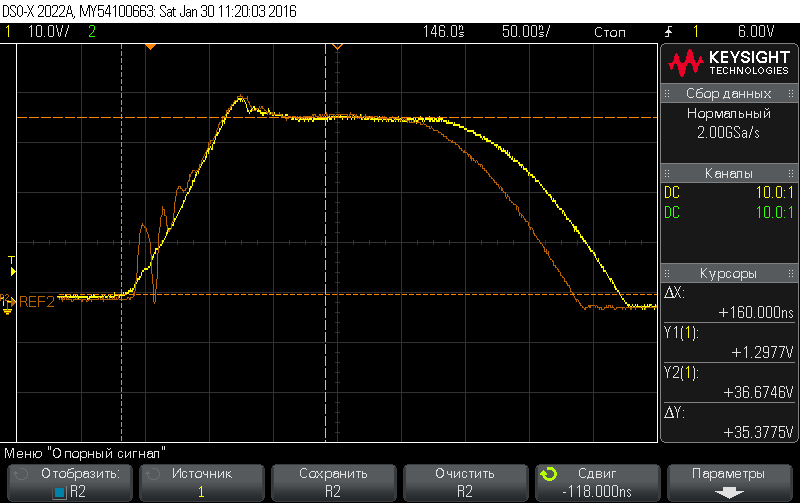
Ультра_разработка_остановлена/scope_1.png
