shodanx/Dosimeter-Ultra-Micron/Ультра_разработка_остановлена/scope_2.png

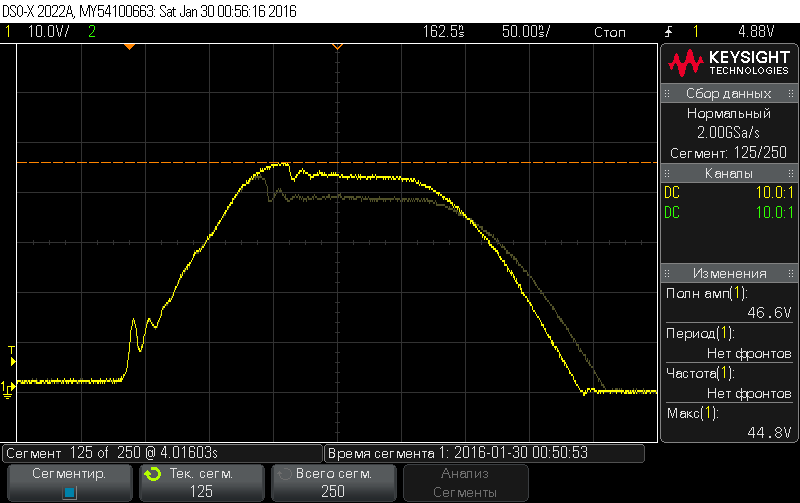
Ультра_разработка_остановлена/scope_2.png
