shodanx/Dosimeter-Ultra-Micron/Ультра_разработка_остановлена/scope_4.png

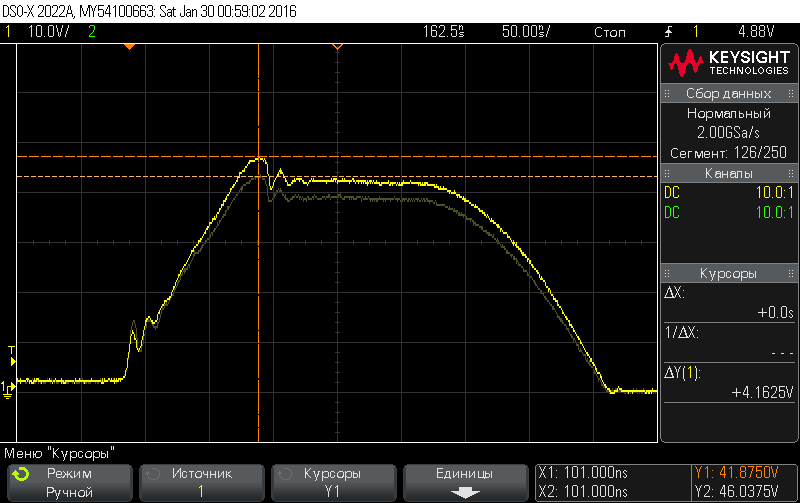
Ультра_разработка_остановлена/scope_4.png
