shodanx/Dosimeter-Ultra-Micron/Ультра_разработка_остановлена/scope_5.png

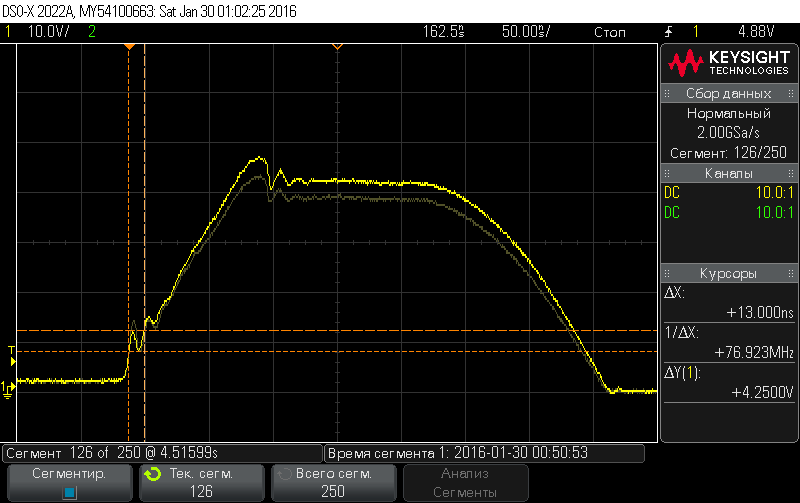
Ультра_разработка_остановлена/scope_5.png
