shodanx/Dosimeter-Ultra-Micron/Ультра_разработка_остановлена/scope_6.png

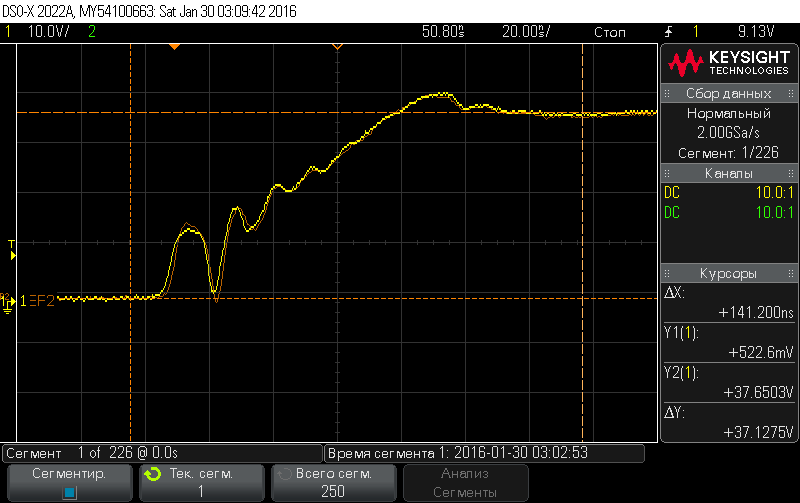
Ультра_разработка_остановлена/scope_6.png
