shodanx/Dosimeter-Ultra-Micron/Ультра_разработка_остановлена/TR.png

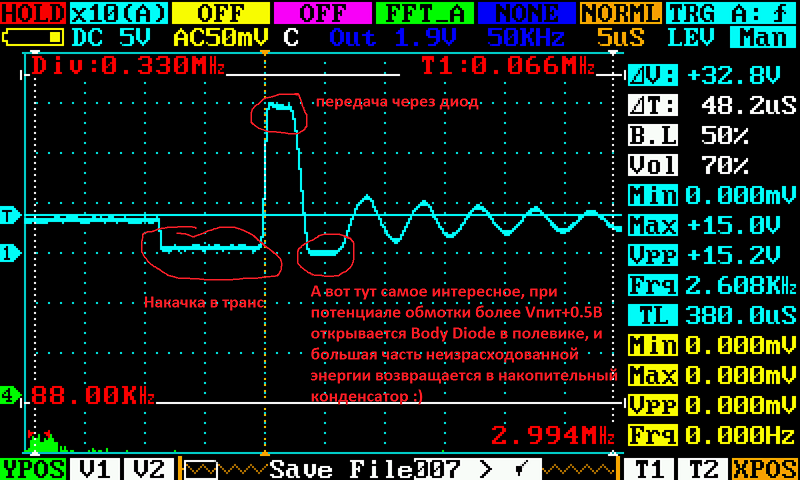
Ультра_разработка_остановлена/TR.png
