shodanx/Dosimeter-Ultra-Micron/Ультра_разработка_остановлена/Время на переключение диода.BMP

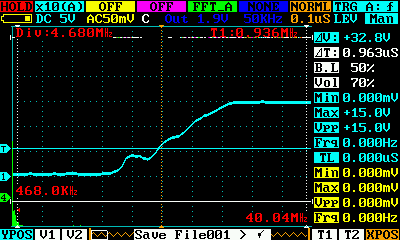
Ультра_разработка_остановлена/Время на переключение диода.BMP
