shodanx/Dosimeter-Ultra-Micron/Ультра_разработка_остановлена/СИ-19БГМ.png

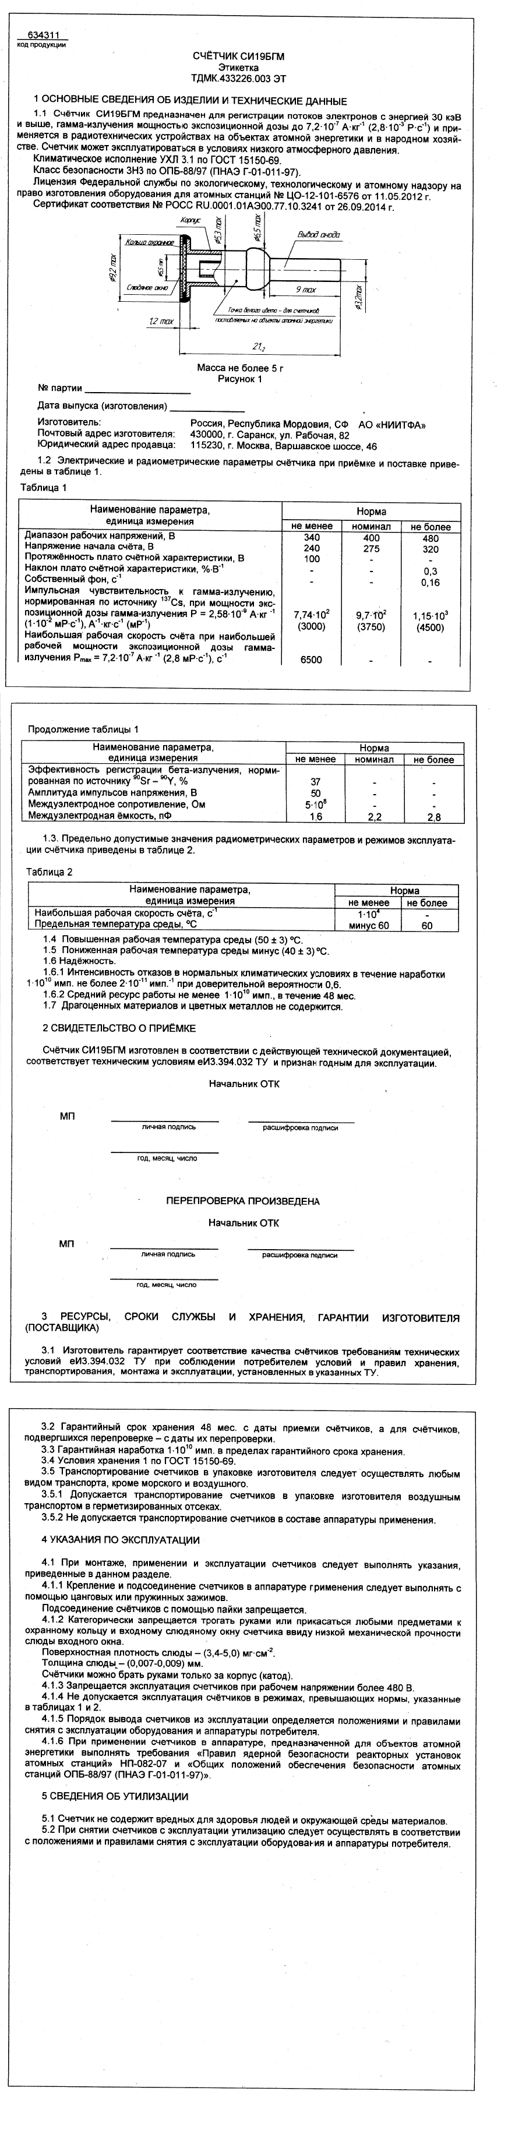
Ультра_разработка_остановлена/СИ-19БГМ.png
