shodanx/Dosimeter-Ultra-Micron/Ультра_разработка_остановлена/Ток потребления накачки.png

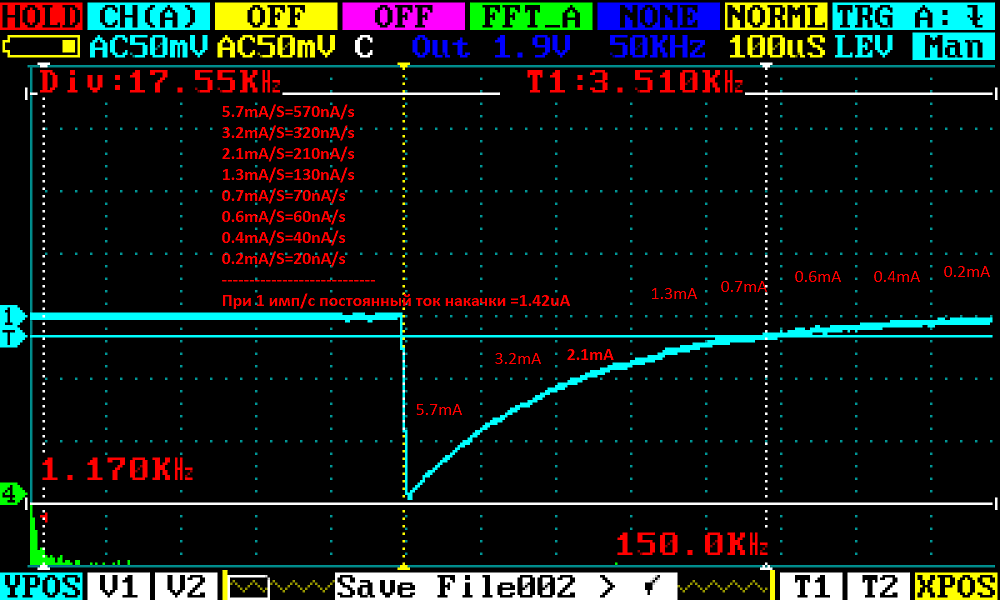
Ультра_разработка_остановлена/Ток потребления накачки.png
