shodanx/Dosimeter-Ultra-Micron/Расчет напряжения на компараторе.xlsx

Деталь | Номинал | еденица
С24 | 10000 | пФ
C3 | 220 | пФ
R6 | 195 | Ком
R7 | 5 | Ком
Падение на С13 | 0.23 | В |  |  |  |  | Vref | 1.224
D4 | 0.6 | В |  |  |  |  | Vref3/4 | 0.918
D2 | 2.5 | В |  |  |  |  | Vref1/2 | 0.612
 |  |  | Напряжение датчика | 405 | В |  | Vref1/4 | 0.306
 |  |  | Напряжение на трансе | 36.614 | В
Коэфицент | Значение |  | Напряжение на р.дел | 35.226 | В
Ктр | 11.2 |  | Напряжение на копм. | 0.881 | В | 0.037
Кконд.дел | 0.9784735812
Крез.дел | 0.025
