shodanx/Dosimeter-Ultra-Micron/Ультра_разработка_остановлена/потребление.xlsx

No | Time | DC/AC | Value | Unit | AUTO
1 | 15:27:35 |  | 0.01 | mA | AUTO
2 | 15:27:36 |  | 0.004 | mA | AUTO
3 | 15:27:37 |  | 0.004 | mA | AUTO
4 | 15:27:37 |  | 0.004 | mA | AUTO
5 | 15:27:38 |  | 0.004 | mA | AUTO
6 | 15:27:39 |  | 0.014 | mA | AUTO
7 | 15:27:39 |  | 0.024 | mA | AUTO
8 | 15:27:40 |  | 0.004 | mA | AUTO
9 | 15:27:41 |  | 0.004 | mA | AUTO
10 | 15:27:41 |  | 0.005 | mA | AUTO
11 | 15:27:42 |  | 0.006 | mA | AUTO
12 | 15:27:43 |  | 0.004 | mA | AUTO
13 | 15:27:43 |  | 0.004 | mA | AUTO
14 | 15:27:44 |  | 0.004 | mA | AUTO
15 | 15:27:45 |  | 0.012 | mA | AUTO
16 | 15:27:45 |  | 0.01 | mA | AUTO
17 | 15:27:46 |  | 0.004 | mA | AUTO
18 | 15:27:47 |  | 0.005 | mA | AUTO
19 | 15:27:47 |  | 0.002 | mA | AUTO
20 | 15:27:48 |  | 0.002 | mA | AUTO
21 | 15:27:49 |  | 0.004 | mA | AUTO
22 | 15:27:49 |  | 0.004 | mA | AUTO
23 | 15:27:50 |  | 0.005 | mA | AUTO
24 | 15:27:51 |  | 0.003 | mA | AUTO
25 | 15:27:51 |  | 0.002 | mA | AUTO
26 | 15:27:52 |  | 0.002 | mA | AUTO
27 | 15:27:53 |  | 0.002 | mA | AUTO
28 | 15:27:53 |  | 0.01 | mA | AUTO
29 | 15:27:54 |  | 0.004 | mA | AUTO
30 | 15:27:55 |  | 0.004 | mA | AUTO
31 | 15:27:55 |  | 0.003 | mA | AUTO
32 | 15:27:56 |  | 0.002 | mA | AUTO
33 | 15:27:57 |  | 0.006 | mA | AUTO
34 | 15:27:57 |  | 0.004 | mA | AUTO
35 | 15:27:58 |  | 0.004 | mA | AUTO
36 | 15:27:59 |  | 0.004 | mA | AUTO
37 | 15:27:59 |  | 0.004 | mA | AUTO
38 | 15:28:00 |  | 0 | mA | AUTO
39 | 15:28:01 |  | 0.014 | mA | AUTO
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
455 | 15:32:35 |  | 0.004 | mA | AUTO
456 | 15:32:36 |  | 0.006 | mA | AUTO
457 | 15:32:36 |  | 0.004 | mA | AUTO
458 | 15:32:37 |  | 0.004 | mA | AUTO
459 | 15:32:38 |  | 0.006 | mA | AUTO
460 | 15:32:38 |  | 0.004 | mA | AUTO
461 | 15:32:39 |  | 0.006 | mA | AUTO
 |  |  | 0.014202
