shodanx/Dosimeter-Ultra-Micron/Ультра_разработка_остановлена/Расчет цены дозика 03.11.2014.xlsx

Designator | Order | Quantity | Цена шт. | Перефасовка | Цена на дозик
Batt+1 | EEMB LP401230 | 1 | 70.00 | 250.00 ₽ | 70.00 ₽ | (с учетом доставки)
Доставка Элитана |  | 1 |  | 295.00 ₽ | 0.00 ₽
C1 | CC1206JRNPOBBN100 | 1 | 3.13 | 10.00 ₽ | 3.13 ₽
C2 | 1812AC103KAT1A | 1 | 10.00 | 10.00 ₽ | 10.00 ₽
C3 | GRM188R71E104KA01D | 1 | 1.55 | 10.00 ₽ | 1.55 ₽
C4, C14, C15, C16, C19, C22 | 0402ZD104KAT2A | 6 | 2.74 | 10.00 ₽ | 16.44 ₽
C5, C6, C11, C20, C21 | CC0402KRX5R5BB105 | 5 | 2.12 | 10.00 ₽ | 10.60 ₽
C7, C8 | GRM1555C1H180JZ01D | 2 | 2.19 | 10.00 ₽ | 4.38 ₽
C9 | CC1206KKX7R8BB475 | 1 | 3.49 | 10.00 ₽ | 3.49 ₽
C10 | CC1206KKX7R0BB104 | 1 | 1.75 | 10.00 ₽ | 1.75 ₽
C12 | GRM31CR61E226KE15L | 1 | 7.72 | 10.00 ₽ | 7.72 ₽
C13 | GRM31CR61A106KA01L | 1 | 3.73 | 10.00 ₽ | 3.73 ₽
C17, C18 | GRM1555C1H100JA01D | 2 | 2.02 | 10.00 ₽ | 4.04 ₽
D1 | PMEG4005CT | 1 | 29.00 | 100.00 ₽ | 29.00 ₽
D2 | DA2JF8100L | 1 | 24.30 | 100.00 ₽ | 24.30 ₽
Display1 | Nokia 2760 ext + Socket Hirose DF23C-10DS-0.5V | 1 | 43.00 |  | 43.00 ₽
J1 | Molex 47346-0001 | 1 | 30.60 | 10.00 ₽ | 30.60 ₽
KEY1, KEY2, KEY3 | IT-1187-160GM-G | 3 | 19.20 | 10.00 ₽ | 57.60 ₽
L1 | IFSC1515AHER100M01 | 1 | 22.20 | 10.00 ₽ | 22.20 ₽
L2 | LB2518T681K | 1 | 19.80 | 100.00 ₽ | 19.80 ₽
LED1 | KPTD-3216SECK | 1 | 15.70 | 100.00 ₽ | 15.70 ₽
Q1 | BC857CT | 1 | 1.13 | 10.00 ₽ | 1.13 ₽
Q2, Q4 | PMR400UN | 2 |  |  | 0.00 ₽
Q3 | IRLML6401 | 1 | 5.25 | 10.00 ₽ | 5.25 ₽
Q5 | BC847CT | 1 | 2.45 | 10.00 ₽ | 2.45 ₽
R1 | RV1206JR-0710ML | 1 | 33.20 | 100.00 ₽ | 33.20 ₽
R2, R5, R6, R8, R11, R12 | RC0603FR-1010KL | 6 |  |  | 0.00 ₽
R3, R9, R10, R15 | CR0603-JW-220GLF | 4 | 6.09 | 100.00 ₽ | 24.36 ₽
R4 | RC0603FR-071K5L | 1 | 1.46 | 10.00 ₽ | 1.46 ₽
R7, R23 | RC0603FR-101KL | 2 |  |  | 0.00 ₽
R13 | RC0603JR-0762KL | 1 | 1.48 | 10.00 ₽ | 1.48 ₽
R14 | RC0603JR-07470RL | 1 | 1.46 | 10.00 ₽ | 1.46 ₽
R16, R17 | RC0603FR-071M6L | 2 | 1.47 | 10.00 ₽ | 2.94 ₽
R18 | RC0603FR-073ML | 1 | 1.48 | 10.00 ₽ | 1.48 ₽
R20 | RC0603FR-073M3L | 1 | 1.46 | 10.00 ₽ | 1.46 ₽
R21 | RC0603FR-072M2L | 1 | 1.46 | 10.00 ₽ | 1.46 ₽
R22 | RC0603FR-10100KL | 1 |  |  | 0.00 ₽
Sensor | SBM-10 | 1 | 500.00 | 250.00 ₽ | 500.00 ₽ | (с учетом доставки)
Sound1, Sound2 | 7BB-12-9 | 1 | 7.86 | 10.00 ₽ | 7.86 ₽
T1 | B65523J0000R087 + B65527B1008T001 + B65527A2000X000 | 1 | 180.00 | 50.00 ₽ | 180.00 ₽ | (только партиями 100шт)
U1 | STM32L152CBU6 | 1 | 160.00 | 10.00 ₽ | 160.00 ₽
U2 | TPS60400DBV | 1 | 18.60 | 10.00 ₽ | 18.60 ₽
U3 | USBLC6-2 | 1 | 5.22 | 10.00 ₽ | 5.22 ₽
U4 | MCP73831T-2ACI/OT | 1 | 33.00 | 10.00 ₽ | 33.00 ₽
U5 | TPS62736RGYT | 1 | 154.00 | 100.00 ₽ | 154.00 ₽
Z1 | ABM7-8.000MHZ-D2Y-T | 1 | 59.50 | 10.00 ₽ | 59.50 ₽
Z2 | ABS10-32.768KHZ-7-T | 1 | 79.90 | 100.00 ₽ | 79.90 ₽
 | Корпус | 1 | 50.00 | 50.00 ₽ | 50.00 ₽ | (с учетом доставки)
 |  |  |  | 1995.00 ₽ | 1705.24 ₽ |  | 3700.24
Затрачено часов | 320.00 ₽ | Материалы (припой, флюс, отмывочные жидкости, электроэнергия, плата)
5 | 1300.00 ₽ | Стоимость пайки
1 | 260.00 ₽ | Стоимость отмывки
4 | 1040.00 ₽ | Стоимость распила корпуса
1.5 | 390.00 ₽ | Стоимость прошивки и тестирования
 | 150.00 ₽ | Доставка
 |  |  |  | Курс доллара |  |  | 45
Итого, с учетом расфасовки*1 и работы |  | 7160.24 ₽ |  | Установленная цена за устройство |  |  | 6500.00 ₽ | $144.44
С учетом расфасовки/10, работы и доставки |  | 5364.74 ₽ |  | Часовая ставка | 260.00 ₽
Цена 10-ти дозиков |  | 53647.40 ₽
