shodanx/Dosimeter-Ultra-Micron/Ультра_разработка_остановлена/Расчет цены дозика 08.04.2016.xlsx

Компанент | кол-во | цена за шт | итого
LP401230 | 1 | 162.00 ₽ | 162.00 ₽ | Стоимость корпусов
VJ0805A100JXGAT5Z | 1 | 162.00 ₽ | 162.00 ₽ | Работа | цена | штук | итог
1206CC103KAT1A | 1 | 97.50 ₽ | 97.50 ₽ | Фрезировка | 200 ₽ | 42 | 8400 ₽
CC0603JRNPO9BN221 | 1 | 3.47 ₽ | 3.47 ₽ | Подготовка к фрезировке партии | 1000 ₽ | 1 | 1000 ₽
0402ZD104KAT2A | 7 | 51.10 ₽ | 357.70 ₽ | Доставка корпусов тула-питер | 1200 ₽ | 3 | 3600 ₽
CC0402KRX5R5BB105 | 5 | 3.90 ₽ | 19.50 ₽ | Цена корпуса | 82.5 ₽ | 42 | 3465 ₽
GRM1555C1H180JZ01D | 2 | 4.10 ₽ | 8.20 ₽ | Резка акрила | 30 ₽ | 100 | 3000 ₽
GRM188R60J106ME47D | 1 | 4.47 ₽ | 4.47 ₽ | Доставка акрила | 260 ₽ | 2 | 520 ₽
GRM188R71E104KA01D | 1 | 3.42 ₽ | 3.42 ₽ | Калькуляторы | 100 ₽ | 7 | 700 ₽
GRM31CR61E226KE15L | 1 | 10.10 ₽ | 10.10 ₽ | Лист акрила | 400 ₽ | 1 | 400 ₽
GRM31CR61A106KA01L | 1 | 14.50 ₽ | 14.50 ₽ | Промежуточный итог |  |  | 21085.0 ₽
GRM1555C1H100JA01D | 2 | 3.88 ₽ | 7.76 ₽ | Хороших корпусов |  |  | 29
CC1206KKX7R8BB475 | 1 | 6.95 ₽ | 6.95 ₽ | Себестоимость 1 корпуса |  |  | 727.1 ₽
GRM188R71H103KA01D | 1 | 3.40 ₽ | 3.40 ₽ | Бракованных корпусов |  |  | 13
BAR43C | 1 | 5.08 ₽ | 5.08 ₽ | Цена за брак |  |  | 290.8 ₽
DA2JF8100L | 1 | 9.37 ₽ | 9.37 ₽
BAV99 | 1 | 13.80 ₽ | 13.80 ₽
DF23C-10DS-0.5V | 1 | 92.00 ₽ | 92.00 ₽
47346-0001 | 1 | 54.40 ₽ | 54.40 ₽
IT-1187-160GM-G | 3 | 21.80 ₽ | 65.40 ₽
IFSC1515AHER100M01 | 1 | 32.20 ₽ | 32.20 ₽
KPTD-3216SECK | 1 | 10.10 ₽ | 10.10 ₽
BC857CT | 1 | 5.15 ₽ | 5.15 ₽
RUM002N05T2L | 5 | 8.31 ₽ | 41.55 ₽
RZM002P02T2L | 2 | 123.00 ₽ | 246.00 ₽
RCV080510M0FKEA | 1 | 12.40 ₽ | 12.40 ₽
RC0603FR-071K5L | 2 | 3.24 ₽ | 6.48 ₽
RC0603FR-1010KL | 8 | 10.20 ₽ | 81.60 ₽
RC0603FR-07150KL | 1 | 3.24 ₽ | 3.24 ₽
RC0603FR-074K53L | 1 | 3.24 ₽ | 3.24 ₽
CR0603-JW-220GLF | 3 | 3.26 ₽ | 9.78 ₽
RC0603JR-0762KL | 1 | 3.30 ₽ | 3.30 ₽
RC0603JR-07470RL | 3 | 3.24 ₽ | 9.72 ₽
RC0603FR-071RL | 1 | 3.30 ₽ | 3.30 ₽
RC0603FR-073M3L | 2 | 3.24 ₽ | 6.48 ₽
RC0603FR-077M5L | 1 | 3.33 ₽ | 3.33 ₽
RC0805FR-07360RL | 1 | 10.10 ₽ | 10.10 ₽
CRCW06036M04FKEA | 1 | 54.40 ₽ | 54.40 ₽
RC0603FR-075M1L | 1 | 3.33 ₽ | 3.33 ₽
RC0603FR-101KL | 3 | 10.40 ₽ | 31.20 ₽
RC0805FR-0715RL | 1 | 3.28 ₽ | 3.28 ₽
7BB-12-9 | 1 | 11.60 ₽ | 11.60 ₽
ATB322515-0110 | 1 | 265.00 ₽ | 265.00 ₽
STM32L152CBU6 | 1 | 450.00 ₽ | 450.00 ₽
TPS60400DBV | 1 | 29.70 ₽ | 29.70 ₽
USBLC6-2SC6 | 1 | 8.34 ₽ | 8.34 ₽
MCP73831T-2ACI/OT | 1 | 31.50 ₽ | 31.50 ₽
TPS62736RGYT | 1 | 234.00 ₽ | 234.00 ₽
ABM7-8.000MHZ-D2Y-T | 1 | 95.00 ₽ | 95.00 ₽
ABS07-120-32.768kHz-T | 1 | 53.70 ₽ | 53.70 ₽
ПЛАТА | 1 | 250.00 ₽ | 250.00 ₽
ВИБРИК | 1 | 39.00 ₽ | 39.00 ₽
ОППРАВКА И СТРАХОВКА | 1 | 550.00 ₽ | 550.00 ₽
УПАКОВКА | 1 | 60.00 ₽ | 60.00 ₽
 |  | Себестоимость | 3759.04 ₽
 |  | Налог УСН | 225.54 ₽
Затрачено часов на сборку |  | 4 | 2000.00 ₽
Затрачено часов на тестирование |  | 1 | 500.00 ₽
доставка из Элитана | 187.95 ₽ | 395.00 ₽ | 582.95 ₽
Итого затрат |  |  | 7067.53 ₽
Установленный ценник |  |  | 7983.00 ₽
Чистая прибыль |  |  | 915.47 ₽
