shodanx/Dosimeter-Ultra-Micron/Платы/Ультра_разработка_остановлена/PCB_5.00/share/assembly3.png

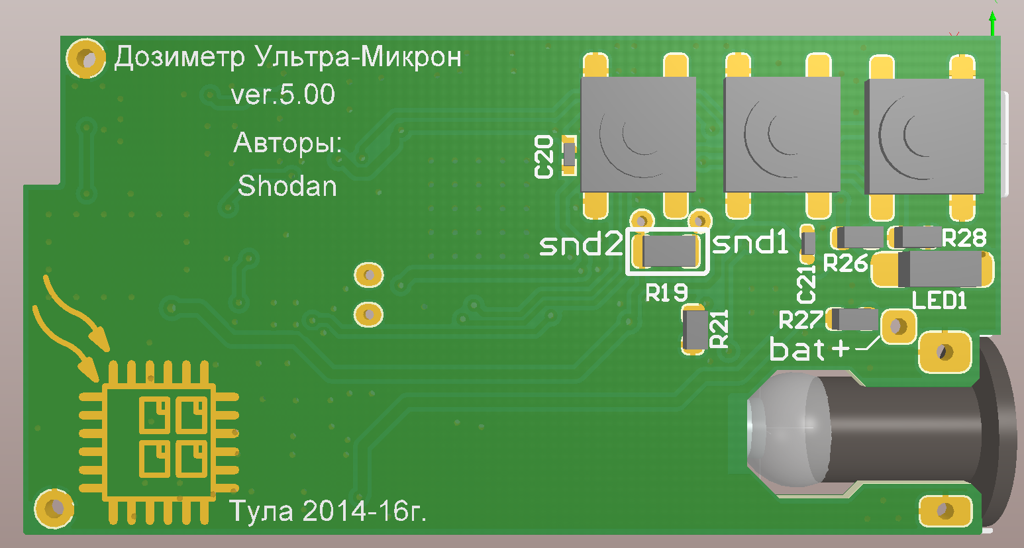
Платы/Ультра_разработка_остановлена/PCB_5.00/share/assembly3.png
