shodanx/Dosimeter-Ultra-Micron/Платы/Ультра_разработка_остановлена/PCB_5.00/share/assembly.png

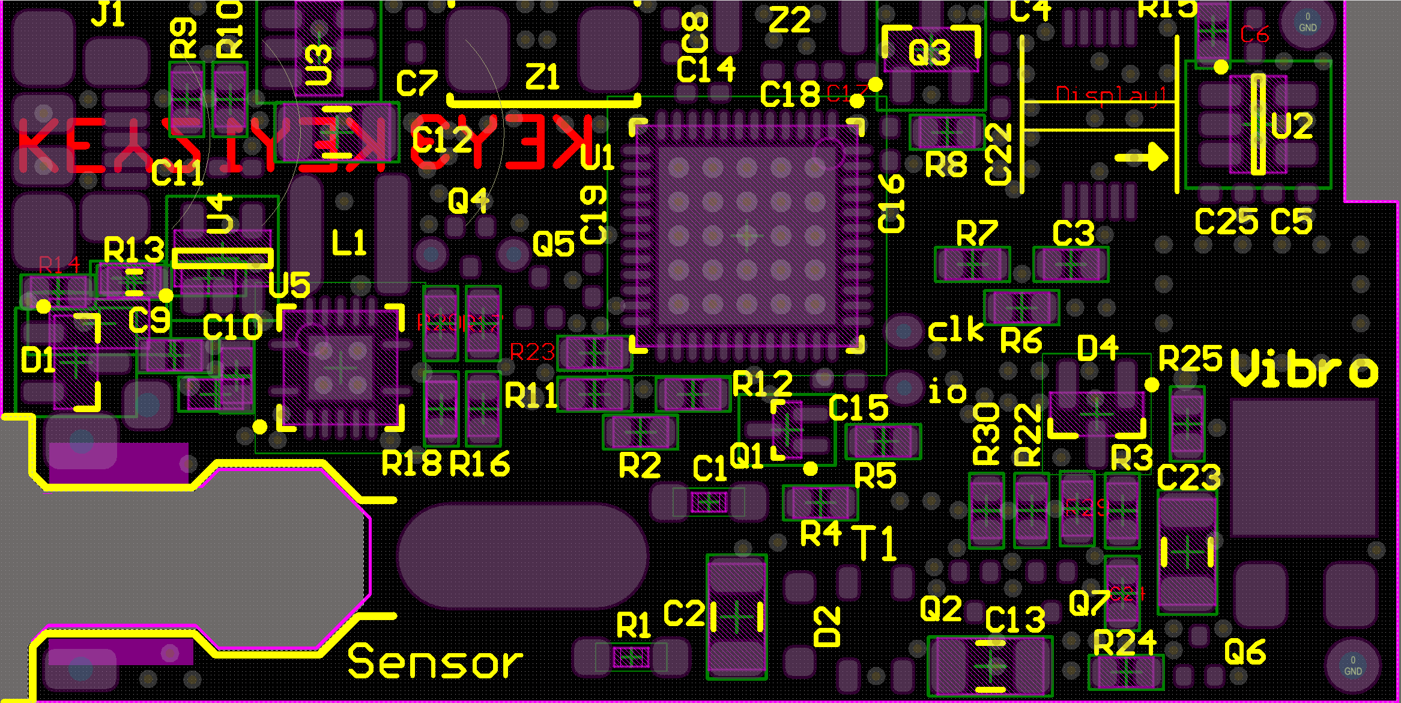
Платы/Ультра_разработка_остановлена/PCB_5.00/share/assembly.png
