shodanx/Dosimeter-Ultra-Micron/Платы/Ультра_разработка_остановлена/PCB_5.01/ProjectOutputs/Assembly1.png

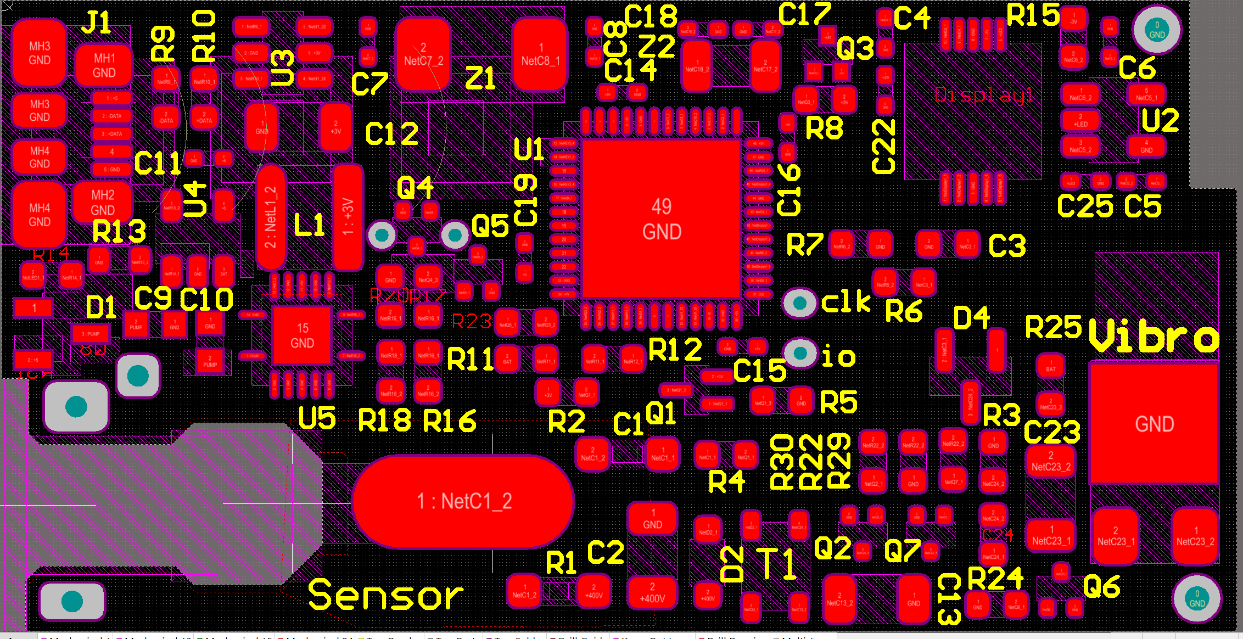
Платы/Ультра_разработка_остановлена/PCB_5.01/ProjectOutputs/Assembly1.png
