shodanx/Dosimeter-Ultra-Micron/changelog.txt

15.06.2014 - Испровлена ошибка с уходом в сон, если после возникновения тревоги, ее выключить в меню.
16.06.2014 - Испровлена ошибка с сбросом дозы.
17.06.2014 - !!! Просыпание сделано по зажатию верхней и нижней кнопки !!!
07.07.2014 - Добавлено ускорение счета >10 000мкРч = *9
				        >5 000мкРч = *5
				        >1 000мкРч = *3
				          >500мкРч = *2
	     Добавлена грубая настройка часового RC генератора(Частота LSI:  37000Гц). Как показывает практика, от одного МК к 
	     другому она сильно варируется. Настраивать можно так:
	     Наблюдаем за граффиком, и на секундомере засекаем за сколько он сделает 10 шагов вправо.
             Изменяя настройку добеваемся того чтобы время 10-ти шагов примерно соответствовало 40 сек.
             Не забывая после каждого изменения настройки делать перезагрузку.

07.07.2014 - Исправлен небольшой глюк при понижении скорости счета.
17.07.2014 - Убран пункт меню "Выключение".
07.08.2014 - Добавлен расчет дозы за час и за 10 минут.
	     Оптимизировано потребление ресурсов при выводе звука.
             При активации режима перезагрузки теперь выводится соответствующее сообщение.
14.08.2014 - Добавлен модуль передачи данных в ПО совместимое с дозиметром Гамма 3 (см. FTP)
             Драйвер USB virtual COM port лежит в папке ультра-микрона
             В активном USB режиме, дозиметр не уходит в сон, это архитектурное ограничение.
15.08.2014 - При изменении настроек, перезагрузка теперь не требуется.
16.08.2014 - Добавлена поддержка модифицированной версии ПО USB Gaiger от одноименного проекта MadOrc'а
18.08.2014 - Счет дозы расширен до 7-ми дней.
             Добавлена функция выгрузки массивов данных в программу USB Gaiger
19.08.2014 - Улучшен алгоритм передачи данных
             Исправлен косяк расчета времени в устройстве. 
             После прошивки ОБЯЗАТЕЛЬНО надо скорректировать LSI и поставить время счета 250 сек !!!
21.08.2014 - Добавлено авто-определение наличия кварца, если он есть(плата начиная с версии 3.10), то МК автоматически с
             LSI переключается на него.
             Частота МК в режиме с включенным дисплеем увеличина в 2 раза до 4 МГц
24.08.2014 - Улучшен алгоритм накачки, что позволило понизить требуемую индукцию до 250мТл.
	     Добавлен выбор режимов работы USB (MarOrc и Гамма3)
             В режиме MadOrc при неактивности более 4-х минут, USB режим автоматически отключается
28.08.2014 - Улучшено потребление
29.08.2014 - Улучшено потребление (среднее потребление на версии "без часового кварца" 3.83 мкА)
30.08.2014 - Исправлна ошибка накачки которая вылезла в последних версиях прошивки
31.08.2014 - Улучшено потребление (среднее потребление на версии "без часового кварца" 3.7 мкА)
02.09.2014 - Для версии платы 3.** с кварцем 32768 установлено ограничение максимальной продолжительности импульса накачки
             чтобы при подключении к USB не вызывать пренасыщение сердечника. Ограничение работает вне зависимости от 
             установленной в меню индукции, фактически делая бесполезным привышение значения индукции более 330мТл при 3.7 вольта.
             Частично убрана задержка прорисовки дисплея после пробуждения, которая появилась на последних версиях прошивки.             
04.09.2014 - Испрвлена ошибка расчета импульсов накачки, это значение занижалось.
             Период между импульсами накачки сокращен с 250 мкс до 140 мкс, что в теории может прибавить 100-200 нА экономии 
             среднего тока в долгосрочной переспективе
05.09.2014 - Кординально переработан алгоритм расчета времени накачки.
             Исправлена проблема перекачки ВВ части при высоком уровне фона.
06.09.2014 - Убрана задержка включения дисплея, при выходе из режима сна.
11.09.2014 - Добавленны пороверки в алгоритм накачки, чтобы минимизировать возможные ошибки в алгоритме.
14.09.2014 - Потребление уменьшено примерно до 2.59 мкА (тестировалось на плате 3.00)
             Возможны глюки, использовать с особым вниманием !
             Исправленна проблема "рассыпающейся картинки" в режиме USB на некоторых дисплеях.
22.11.2014 - Исправлена ошибка потребления, возникающая в момент когда время отключение подсветки больше времени ухода в сон.
             Исправлена ошибка вывода напряжения ЦАП.
             Напряжение датчика и индукция, теперь задана в прошивке жестко и не настраивается (нет необходимости в этих настройках)
             Чистка старого мусора.
             USB режим Gamma3 убран в связи с крайней глючностью.
             Настройка резонанса пьезика убрана в связи с ненадобностью.
             Исправленна ошибка с нерабочим USB.
             !!!Стабильной версией все еще считается 53.dfu!!!
29.11.2014 - Прошивки разделены на стандартную(для повседневного использования) и сервисную(для первоначальной настройки)
03.12.2014 - Переписан весь блок генерации звука, что позволило серьезно снизать нагрузку на МК.
             Исправлена ошибка выхода из сна по тревоге.
             Исправлен расчет фона в режиме ускорения.
             Прошивки разделены по версиям плат.
05.03.2015 - Исправлена ошибка записи в EEPROM настроек по умолчанию
15.04.2015 - Добавлен счетчик наработки дней
             В прошивке возвращена настройка напряжения (если дозиметр обновляется со старой прошивки, напряжение в сервисной, надо настроить обязательно)
08.06.2015 - Добавлена поддержка аппаратного обеспечения для дозиметра Ультра-Микрон версии 4.02 и выше.
             Оптимизированна накачка.
             Добавлено авто определение подключеня USB. (4.02+)
             Добавлена поддержка вибромотора. (4.02+)
             Добавленна английская версия прошивки.
10.06.2015 - Добавлена функция выключения (выключается кнопкой вниз, через меню перезагрузка. А включается удержанием кнопки 
             вверх и кратковременным нажатием меню)
             Кусочек кода накачки переписан
13.06.2015 - Изменен алгоритм ускорения и замедления накачки, что сделало ее немного оптимальнее
             Накачка для версии 4 теперь настраивается в меню. (ВНИМАНИЕ надо проверить в сервисном меню значение параметра 
             "накачка", оно должно быть равно 11тик)
             Сервисная прошивка теперь слита с стандартной. Для открытия сервисных пунктов меню, надо при перезагрузке удерживать 
             кнопку "+" до момента появления изображения на дисплее.
17.06.2015 - Усовершенствование накачки для версии 4+ (для плат 4.05 накачка 9 тактов МК)
30.06.2015 - Переработан алогритм передачи данных по USB. Его работа значительно ускорена. (вместе с загрузкой логов на сайт, процесс занимает 10 секунд)
09.08.2015 - Интервал логирования увеличен до 55 дней засчет ресурсов флешки. (требуется заменить программу USB_Gaiger.exe)
             Добавлено отображение дозы за 1 месяц
11.08.2015 - Интервал логирования увеличен до 60 дней. (требуется заменить программу USB_Gaiger.exe)
29.08.2015 - Интервал накачки по умолчанию изменен. Для уже прошитых дозиков, его надо установить равным 8тик. (Платы с 2-мя полевиками)
11.09.2015 - Ускорена загрузка данных по USB.
             Исправлена потенциальная проблема с загрузкой некорректных архивных данных
14.09.2015 - Изменен расчет максимального фона до 1 недели.
             Оптимизирован алгоритм передачи данных
15.09.2015 - Загрузка данных более 1 недели запрещена.
-----------------------------------------------------------------
С 15.09.2015 Все доработки и исправления распространяются только для лицензионных устройств !
-----------------------------------------------------------------
15.09.2015 - Разрешена загрузка данных старше 1 недели. (до 60 дней)
             Добавлен расчет дозы за 2 месяца.
             Повышена точность расчета времени при выгрузке на ПК, с +-10 минут до +-4 секунды.
18.09.2015 - Добавлено переключение едениц измерения мкР - мкЗв.
20.09.2015 - Упрощение установки лицензий
20.09.2015 - Добавлены часы с синхронизацией с ПК
23.09.2015 - Алгоритм обмена полностью переписан, теперь поддерживается только новой программой USB_Geiger2.exe
24.09.2015 - Алгоритм обмена данными оптимизирован
             Добавлена передача в программу данных о версии прошивки.
25.09.2015 - Исправлен баг (повисание дозиметра при выключении с подключенным USB)
             Добавлен доп. режим звука
             Улучшен алгоритм синхронизации времени
             Исправлена ошибка обмена данными по USB
26.09.2015 - Поддержка версий 2.04 и 3.** приостановлена.
16.01.2016 - Правка приоритета прерываний, обработка исключительных ситуаций стала лучше.
             Использован более стабильный компилятор
25.01.2016 - Приоритет прерываний себя не оправдал, код выкинул.
             Исходный код приведен улучшен по требованием PC-Lint
             Предотвращение выхода за границы массивов.
             Исправлена ошибка загрузки напряжения в DAC
             Исправленна проблема с не включающимся USB в 4.**
             Увеличение потолка счета до 1450 секунд.
             Попытка исправления повисания ALARM_A
             Диапазон бодорствования прибора увеличен до 170 минут
             Начато добавление функционала по расчету потока частиц.
13.02.2016 - Увеличино ускорение счета
14.02.2016 - Добавлен счет частиц
13.02.2016 - Добавлен расчет больших значений в мкЗв
23.02.2016 - Устранена проблема повисания при выключении с подключенным USB
29.02.2016 - Повышена точность измерения напряжения АКБ
             Добавлена настройка напряжения ИОН. (установка производится по напряжению МК)
-----------------------------------------------------------------
Лицензирование отключено
-----------------------------------------------------------------
03.03.2016 - Лицензирование отключено
             При счете более 600 секунд, за среднее значение фона берется среднее по двум ячейкам 10 минут. 
             (Иначе среднее считается с ошибками)
04.03.2016 - Исправление ошибок лицензирования.
             Увеличение максимального интервала между подкачками до 8 секунд и установка подкачки каждые 10 пробоев датчика 
             (для предотвращения перекачки)
05.03.2016 - Код "отгламурен по полной!" через GNU Ident
             Добавлено сохранение времени при перезагрузке устройства
08.03.2016 - Добавлена поддержка реверса для дисплеев с маркировкой MP1.0 (Спасибо: ___L___)
09.03.2016 - Добавлена настройка агресивности накачки. (в агресивном режиме возможна небольшая перекачка напряжения сверх устрановленного в меню,
             но при этом импульсов накачки требуется меньше. В обычном режиме стабилизация напряжения лучше, но чуть менее экономично)
10.03.2016 - В загрузчик dfu.bin добавлена индикация при входе режим бутлоадера.
12.03.2016 - Исправлено повисание меню в английской версии
14.03.2016 - Прошивка оптимизированна для работы на высоких фонах до 7 Р/ч
