shodanx/Dosimeter-Ultra-Micron/Платы/Модуль-AБ/changelog.txt

Ver: 1.2.1
-------------------------------------------------------
* Исправлена подпись контактов "M" и "FK" (заменены местами надписи, т.к. не соответствовали фактическому расмоложению контактов)
* Исправлена ошибка трассировки TPS78330DDCR (контакт EN должен быть скомутирован к контакту IN)
