shodanx/Dosimeter-Ultra-Micron/Платы/Модуль-А3/Монтажка Вычислительная.pdf

## C13 C⁹

# View from Top side (Scale 4) J1

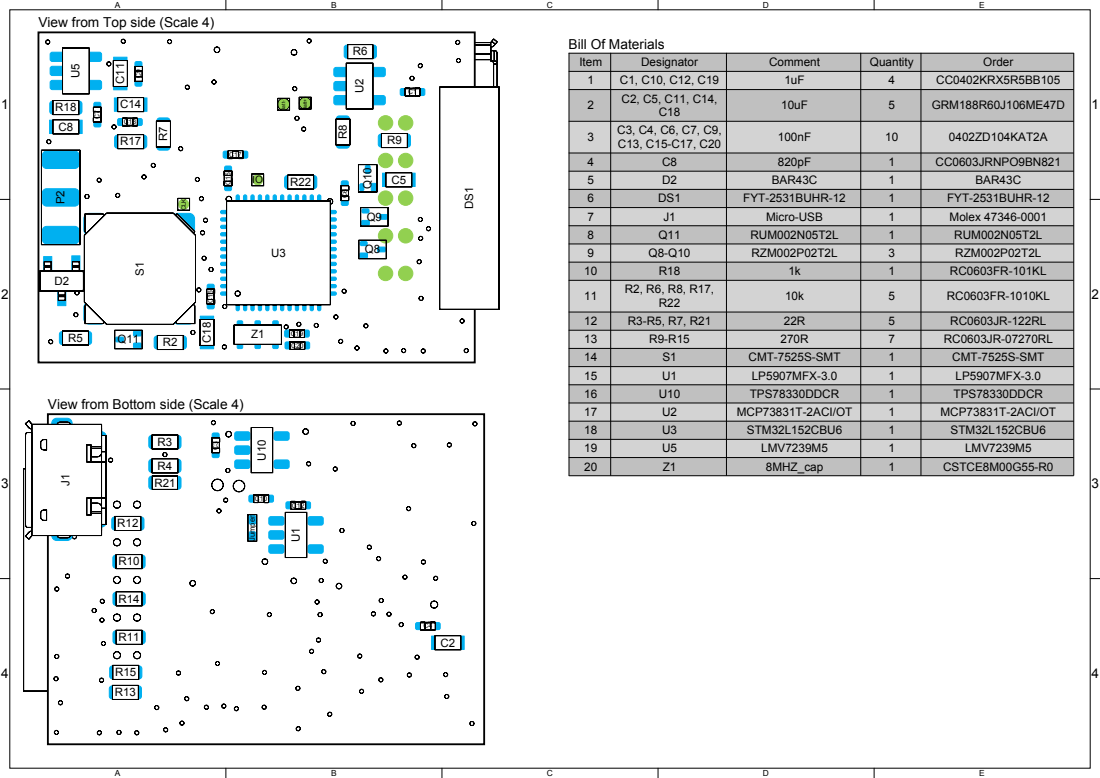
[picture p63: page 1]

Item | Designator | Comment | Quantity | Order
1 | C1, C10, C12, C19 | 1uF | 4 | CC0402KRX5R5BB105

8 | Q11 | RUM002N05T2L | 1 | RUM002N05T2L
9 | Q8-Q10 | RZM002P02T2L | 3 | RZM002P02T2L
10 | R18 | 1k | 1 | RC0603FR-101KL
11 | R2, R6, R8, R17, R22 | 10k | 5 | RC0603FR-1010KL

14 | S1 | CMT-7525S-SMT | 1 | CMT-7525S-SMT
15 | U1 | LP5907MFX-3.0 | 1 | LP5907MFX-3.0
16 | U10 | TPS78330DDCR | 1 | TPS78330DDCR
17 | U2 | MCP73831T-2ACI/OT | 1 | MCP73831T-2ACI/OT
18 | U3 | STM32L152CBU6 | 1 | STM32L152CBU6
19 | U5 | LMV7239M5 | 1 | LMV7239M5
20 | Z1 | 8MHZ_cap | 1 | CSTCE8M00G55-R0

View from Bottom side (Scale 4)
