shodanx/Dosimeter-Ultra-Micron/Платы/Модуль-А/PUB_Output/Документация.PDF

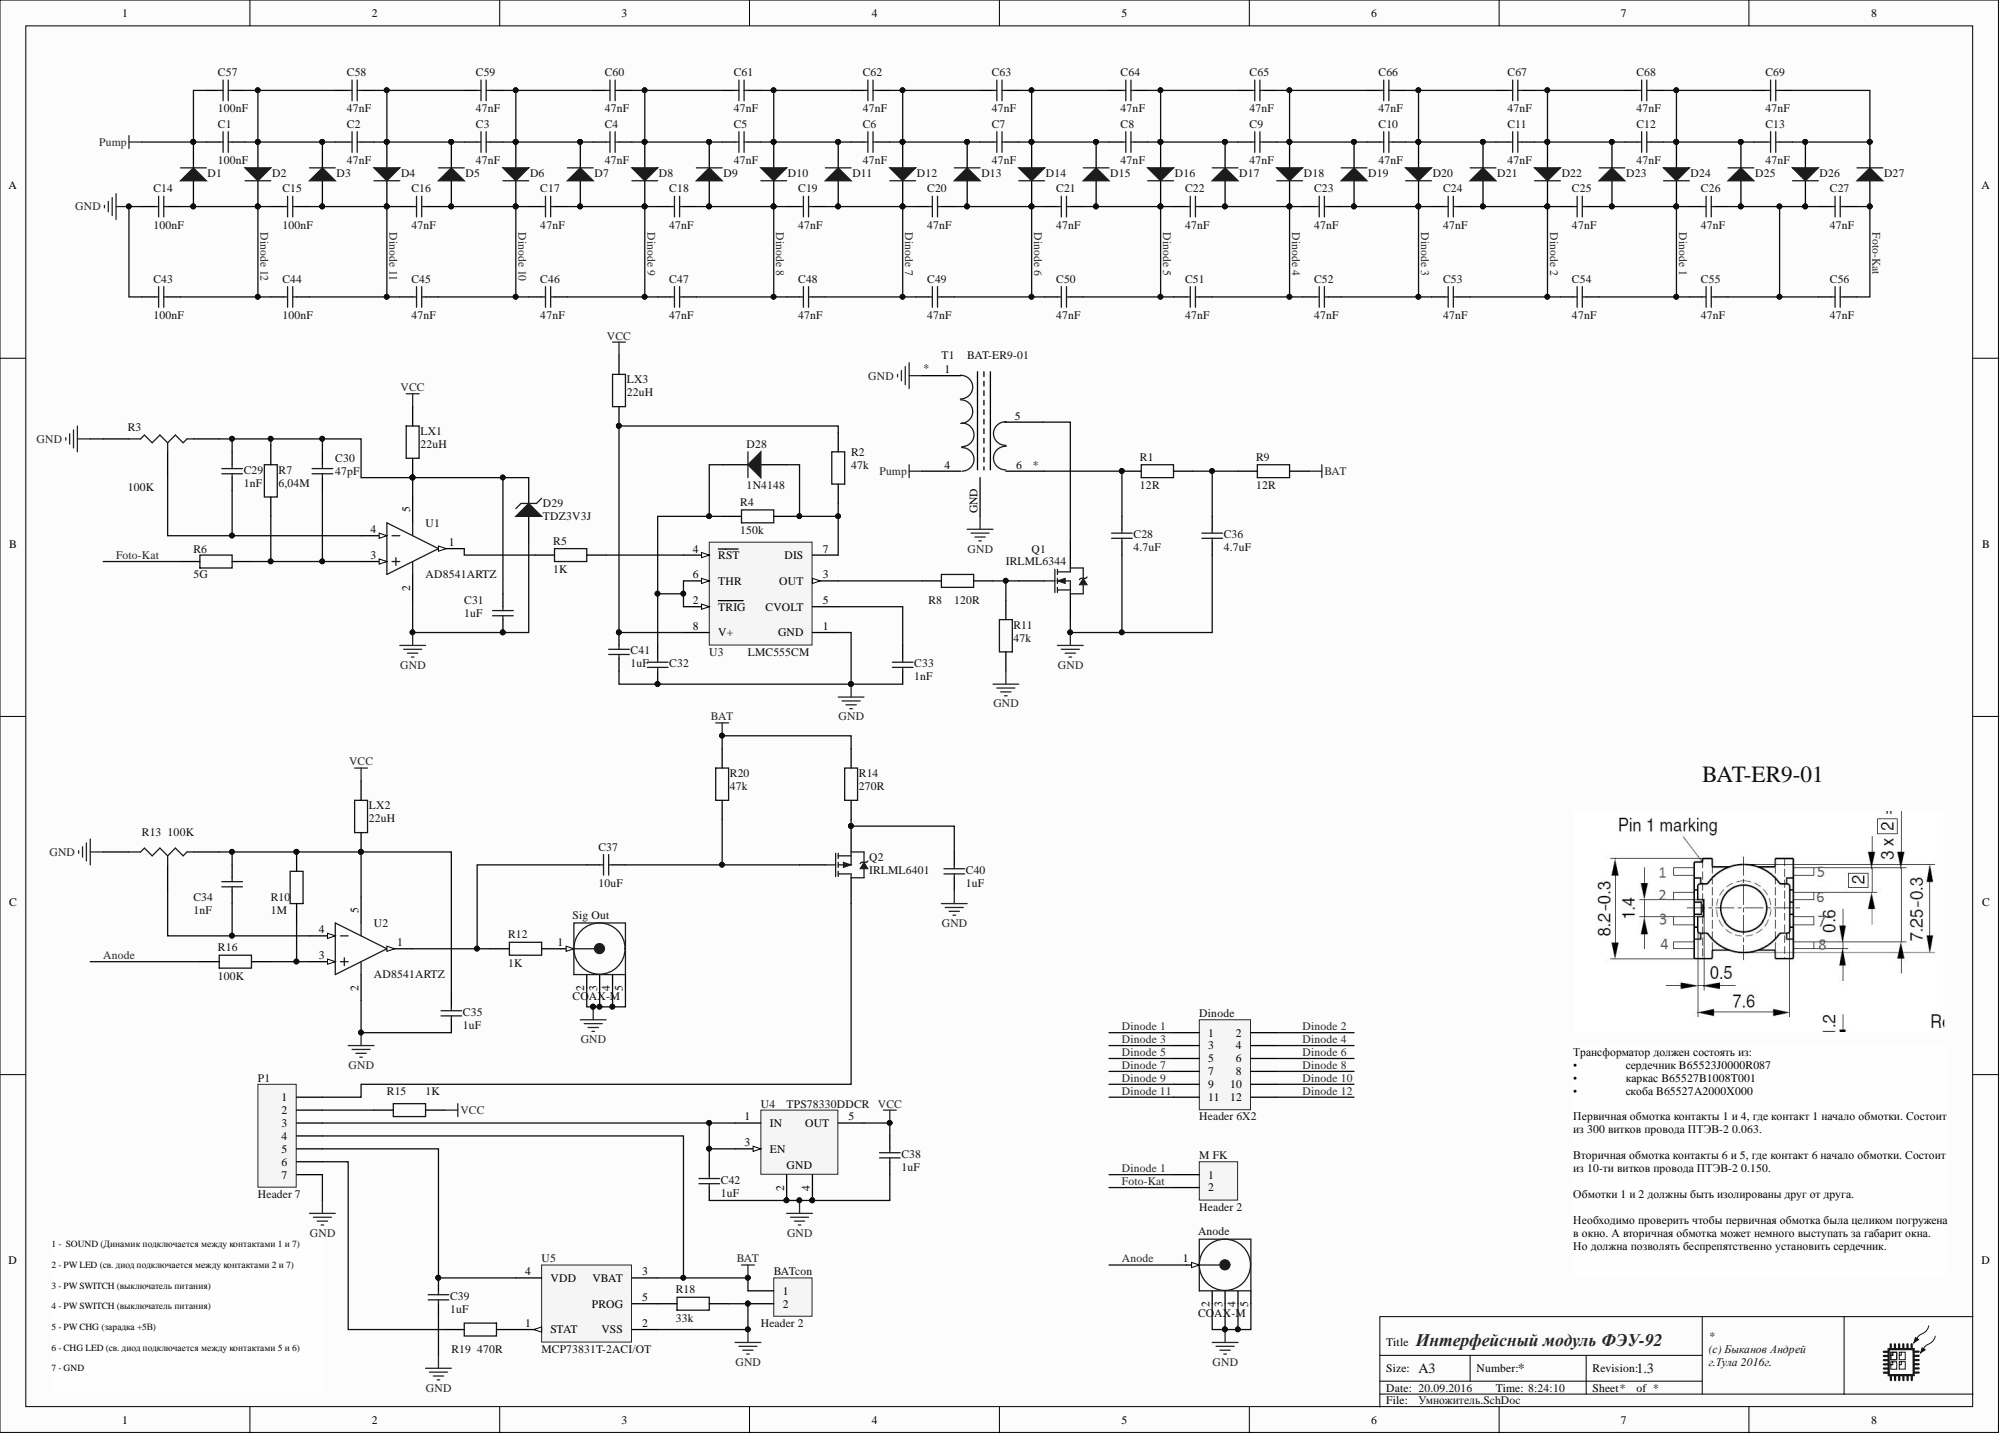
[picture p64: page 1]

Первичная обмотка контакты 1 и 4, где контакт 1 начало обмотки. Состоит
из 300 витков провода ПТЭВ-2 0.063.

Вторичная обмотка контакты 6 и 5, где контакт 6 начало обмотки. Состоит
из 10-ти витков провода ПТЭВ-2 0.150.

Обмотки 1 и 2 должны быть изолированы друг от друга.

Необходимо проверить чтобы первичная обмотка была целиком погружена
в окно. А вторичная обмотка может немного выступать за габарит окна.
Но должна позволять беспрепятственно установить сердечник.

GND 1 - SOUND (Динамик подключается между контактами 1 и 7)

2 - PW LED (св. диод подключается между контактами 2 и 7)

3 - PW SWITCH (выключатель питания)

C39 1uF | STAT 1 | 1 2

4 - PW SWITCH (выключатель питания)

Интерфейсный модуль ФЭУ-92 Title | * (с) Быканов Андрей г.Тула 2016г.

6 - CHG LED (св. диод подключается между контактами 5 и 6)

Size: A3 | Number: * | Revision: 1.3
Date: 20.09.2016 Time: 8:24:10 | | Sheet * of *

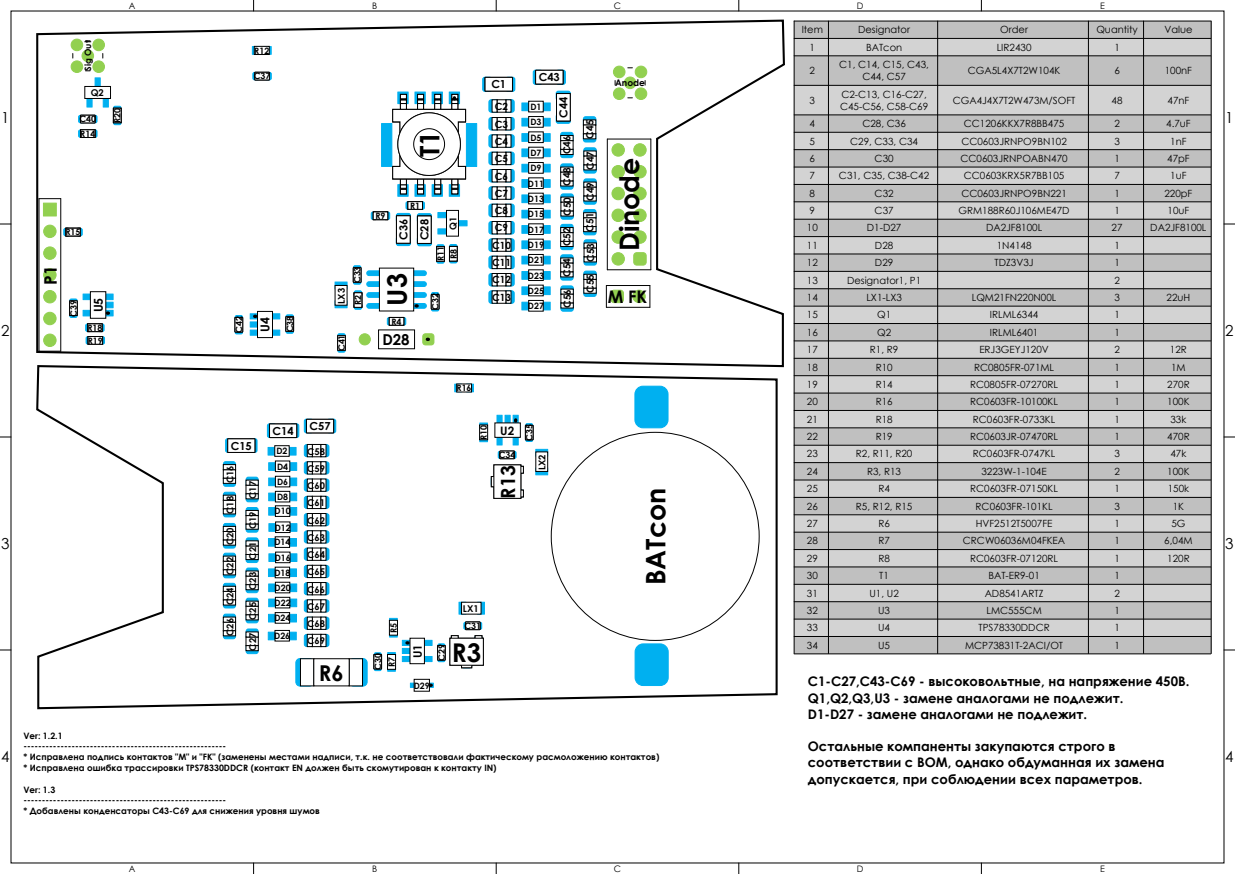
[picture p65: page 2]

Item | Designator | Order | Quantity | Value
1 | BATcon | LIR2430 | 1
2 | C1, C14, C15, C43, C44, C57 | CGA5L4X7T2W104K | 6 | 100nF

17 | R1, R9 | ERJ3GEYJ120V | 2 | 12R
18 | R10 | RC0805FR-071ML | 1 | 1M
19 | R14 | RC0805FR-07270RL | 1 | 270R
20 | R16 | RC0603FR-10100KL | 1 | 100K
21 | R18 | RC0603FR-0733KL | 1 | 33k

C1-C27,C43-C69 - высоковольтные, на напряжение 450В.
Q1,Q2,Q3,U3 - замене аналогами не подлежит.
D1-D27 - замене аналогами не подлежит.

Ver: 1.2.1
* Исправлена подпись контактов "M" и "FK" (заменены местами надписи, т.к. не соответствовали фактическому расмоложению контактов)
* Исправлена ошибка трассировки TPS78330DDCR (контакт EN должен быть скомутирован к контакту IN)

Остальные компаненты закупаются строго в
соответствии с BOM, однако обдуманная их замена
допускается, при соблюдении всех параметров.

Ver: 1.3
* Добавлены конденсаторы C43-C69 для снижения уровня шумов
