shodanx/Dosimeter-Ultra-Micron/Платы/Ультра_разработка_остановлена/PCB_4.06 lite/SCH.PDF

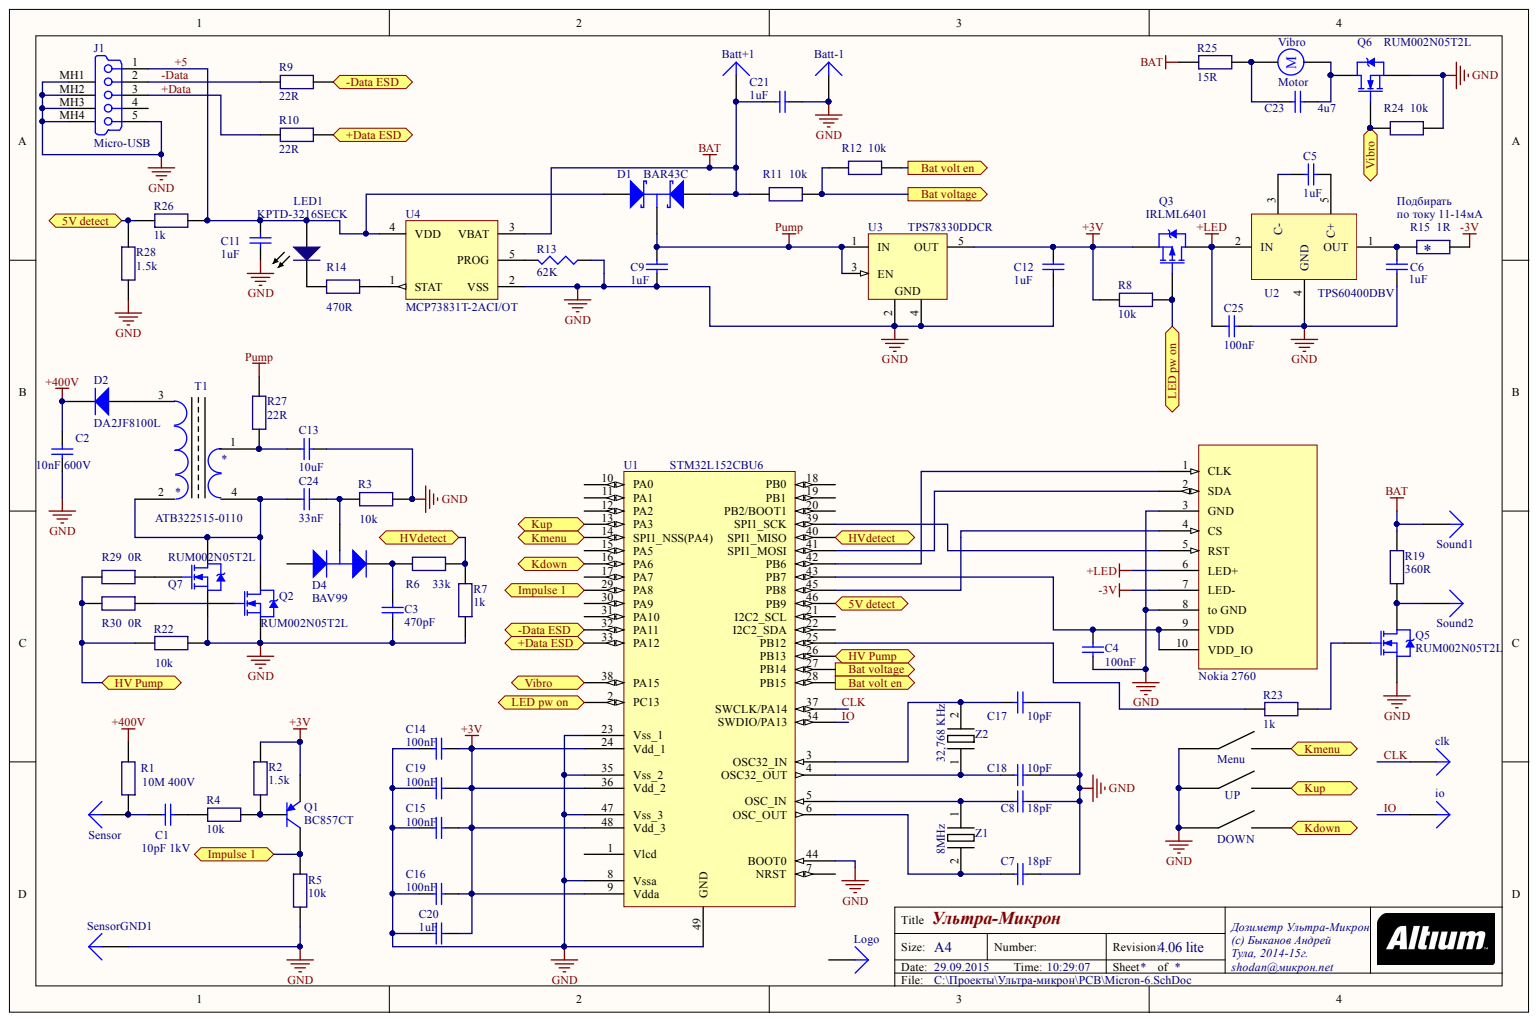
[picture p66: page 1]

MH2
MH3
MH4

GND

GND 3

RST 5

PA6 16 | LED+ 6
PA7 17 | +LED

LED- 7

Vdd_2 36

Vdd_3 48 | Z1

C16 | Vlcd 1

Vdda 9

Ультра-Микрон Title | Дозиметр Ультра-Микрон (с) Быканов Андрей Тула, 2014-15г. shodan@микрон.net

A4 Size: | Number: | 4.06 lite Revision:
Date: 29.09.2015 Time: 10:29:07 | | Sheet * of *

C:\Проекты\Ультра-микрон\PCB\Micron-6.SchDoc
