shodanx/Dosimeter-Ultra-Micron/Платы/Ультра_разработка_остановлена/PCB_5.00/SCH.pdf

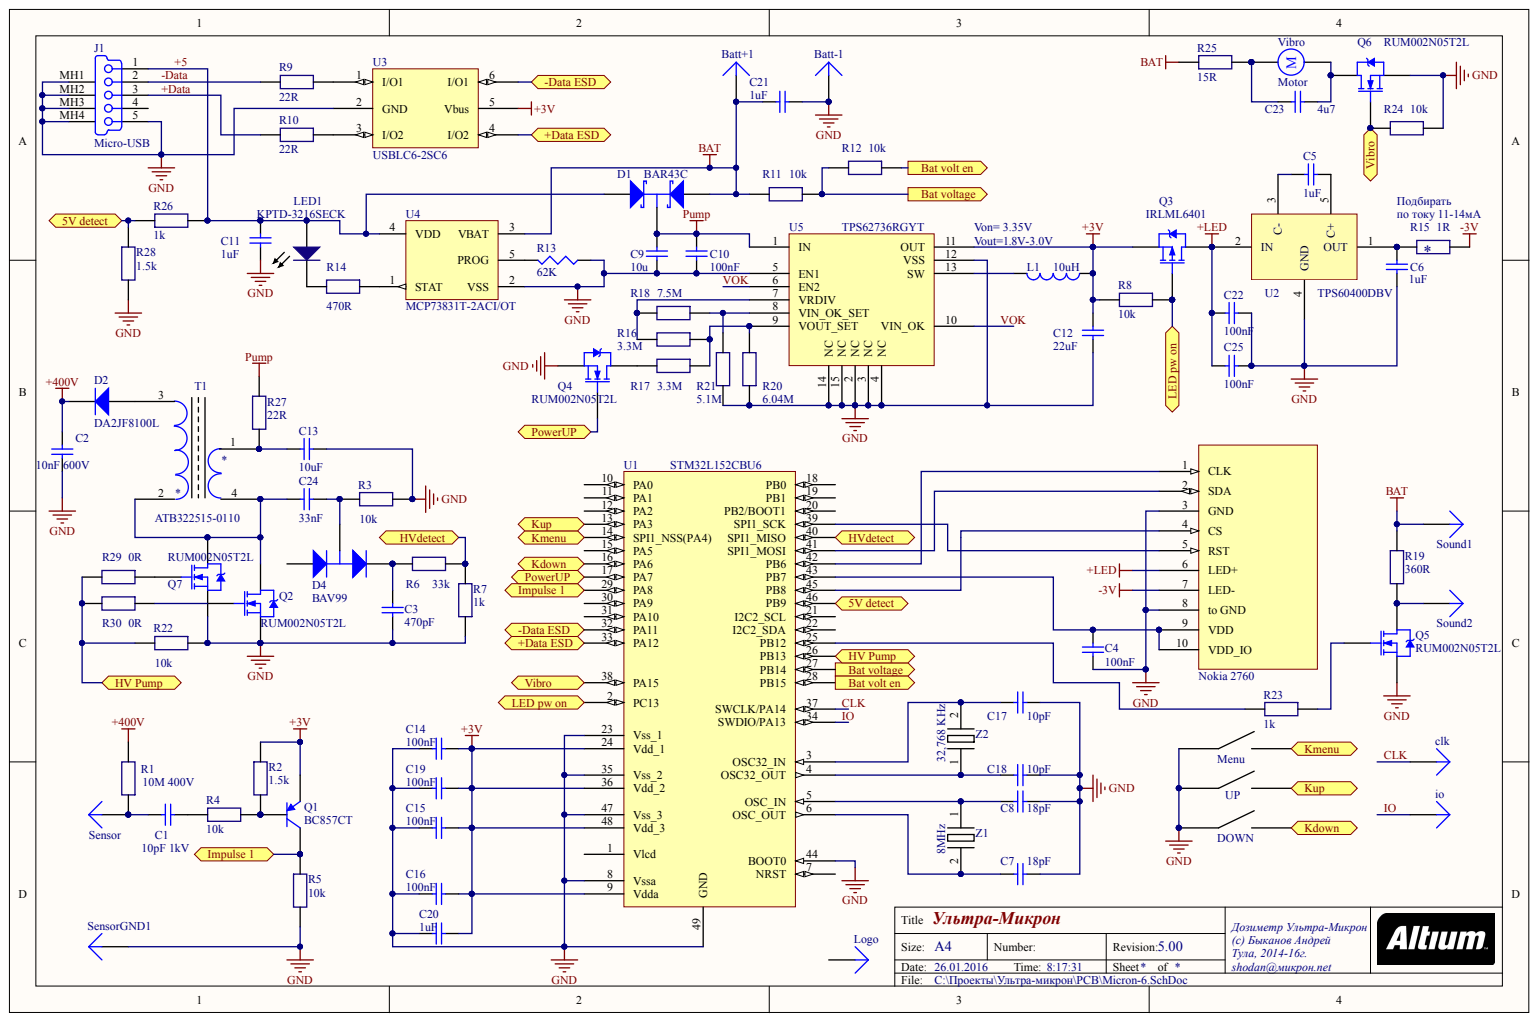
[picture p67: page 1]

PROG STAT 1 | R13 5 C9 | IN 1 VSS SW

VOK | EN2 6 | | | VOK

VIN_OK_SET 8

GND ED pw on

GND 3

RST 5

PA6 16 | LED+ 6
PA7 17 | +LED

LED- 7

Vdd_2 36

Vdd_3 48 | Z1

C16 | Vlcd 1

Vdda 9

Ультра-Микрон Title | Дозиметр Ультра-Микрон (с) Быканов Андрей Тула, 2014-16г. shodan@микрон.net

A4 Size: | Number: | 5.00 Revision:
Date: 26.01.2016 Time: 8:17:31 | | Sheet * of *

C:\Проекты\Ультра-микрон\PCB\Micron-6.SchDoc
