shodanx/Dosimeter-Ultra-Micron/Платы/Модуль-AБ/Project Outputs for PCB_Project/resonit_um_pmt_1_2_Report.pdf

## Общий отчет о проекте

# Наименование: resonit_um_pmt_1_2

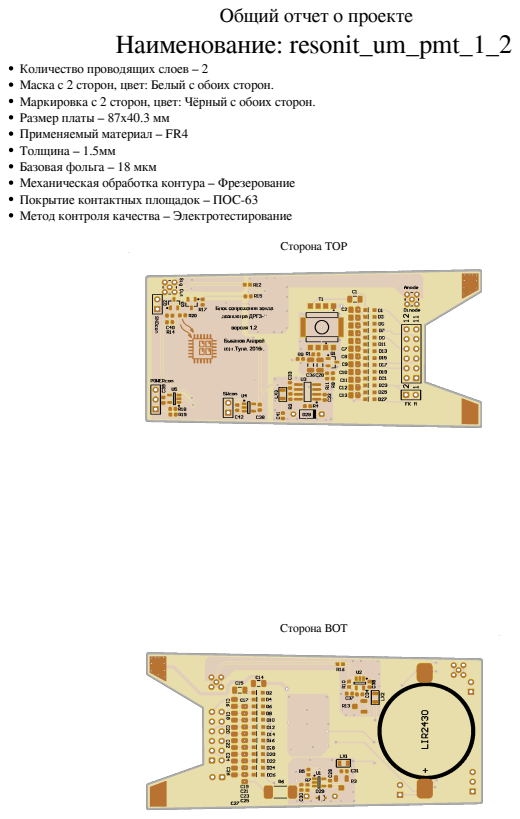
[picture p70: page 1]
Сторона TOP; Сторона BOT

Количество проводящих слоев – 2
Маска с 2 сторон, цвет: Белый с обоих сторон.
Маркировка с 2 сторон, цвет: Чёрный с обоих сторон.
Размер платы – 87х40.3 мм
Применяемый материал – FR4
Толщина – 1.5мм
Базовая фольга – 18 мкм
Механическая обработка контура – Фрезерование
Покрытие контактных площадок – ПОС-63
Метод контроля качества – Электротестирование

Powered by TCPDF (www.tcpdf.org)
