shodanx/Dosimeter-Ultra-Micron/Платы/PCB/Micron-6_00_small border.pdf

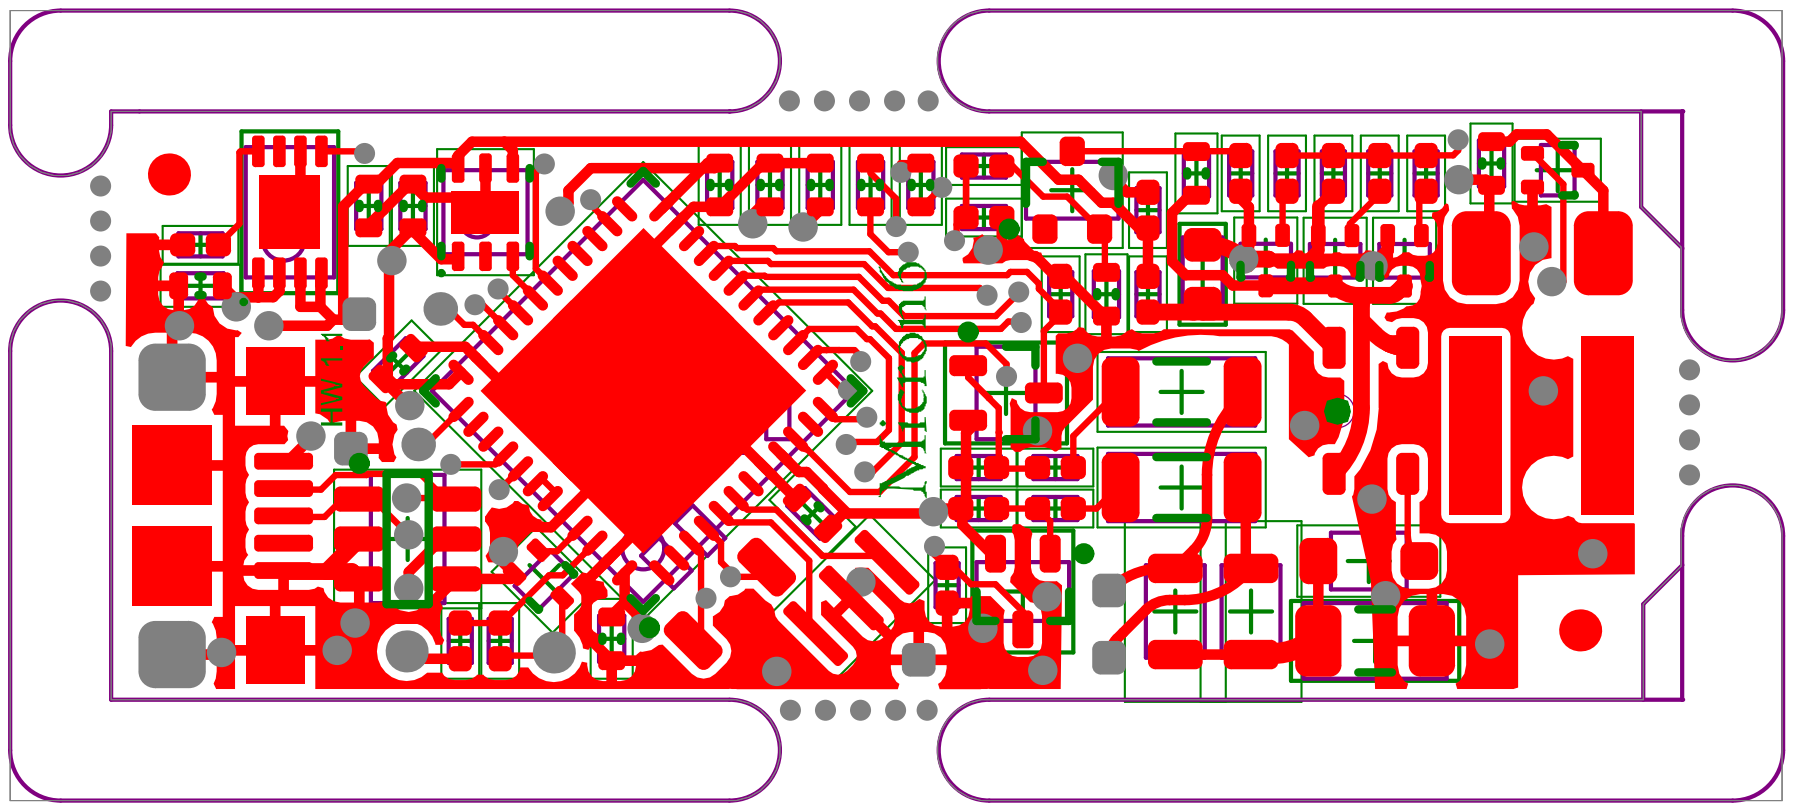
[picture p71: page 1]
