shodanx/Dosimeter-Ultra-Micron/Платы/Модуль-AБ/Умножитель.pdf

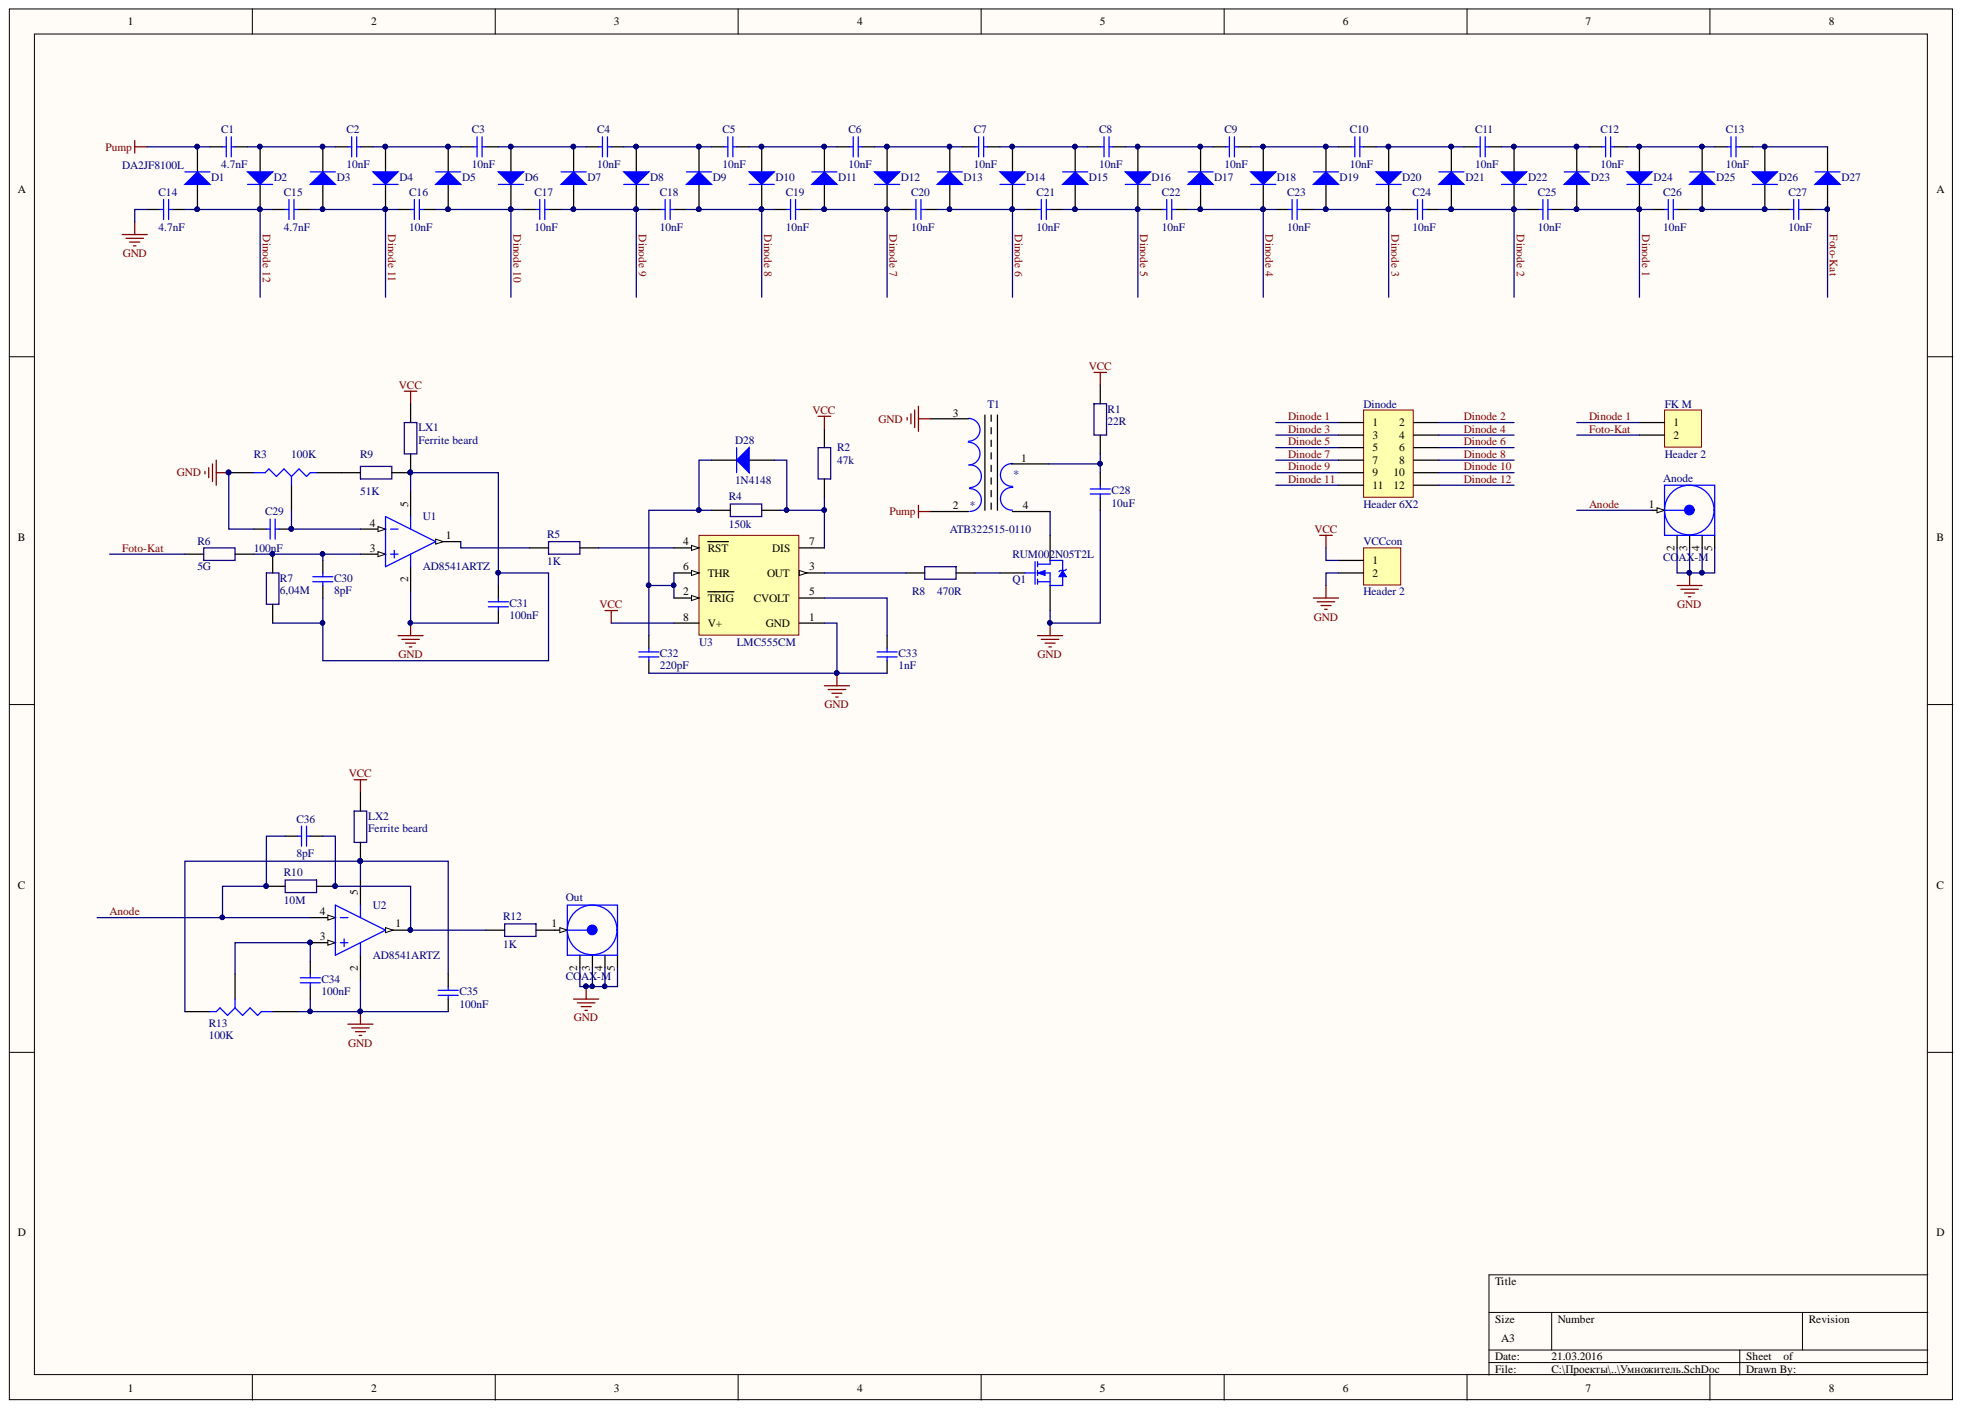
[picture p72: page 1]

U1 1 AD8541ARTZ

RST 4
