shodanx/Dosimeter-Ultra-Micron/Платы/Модуль-А/HV.pdf

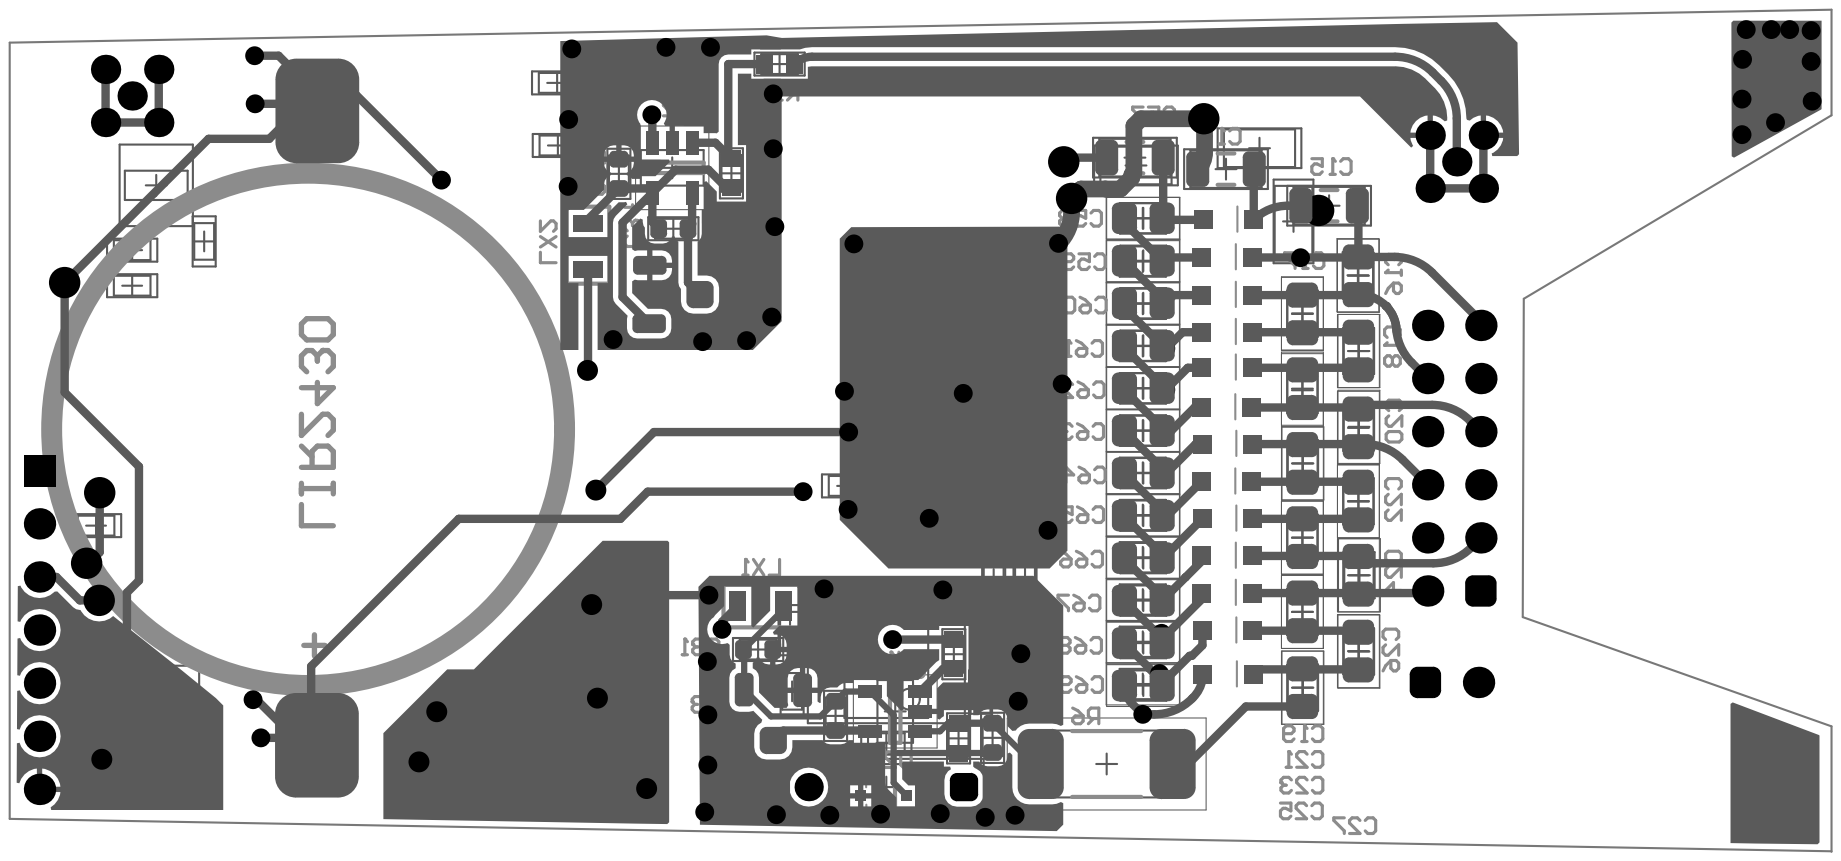
[picture p73: page 1]
