shodanx/Dosimeter-Ultra-Micron/Платы/Модуль-А3/Монтажка Конденсаторная.pdf

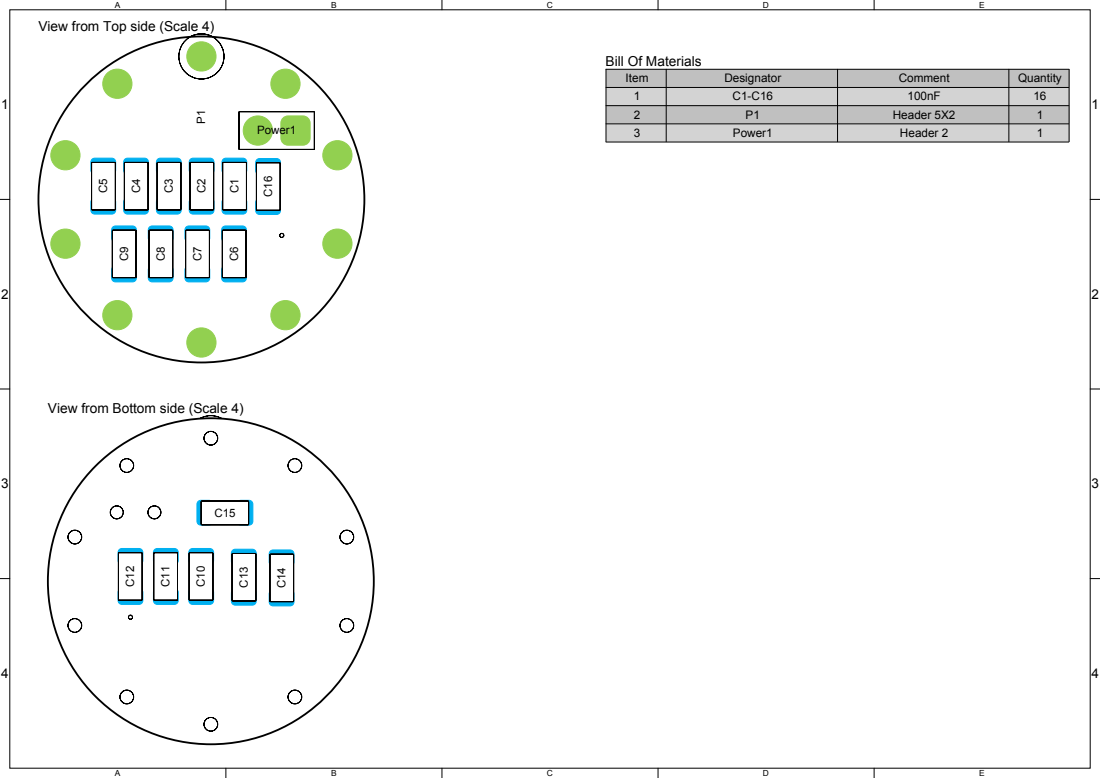
[picture p74: page 1]

View from Top side (Scale 4)

Item | Designator | Comment | Quantity
1 | C1-C16 | 100nF | 16
2 | P1 | Header 5X2 | 1

View from Bottom side (Scale 4)
