shodanx/Dosimeter-Ultra-Micron/Платы/Модуль-А3/Монтажка Умножитель.pdf

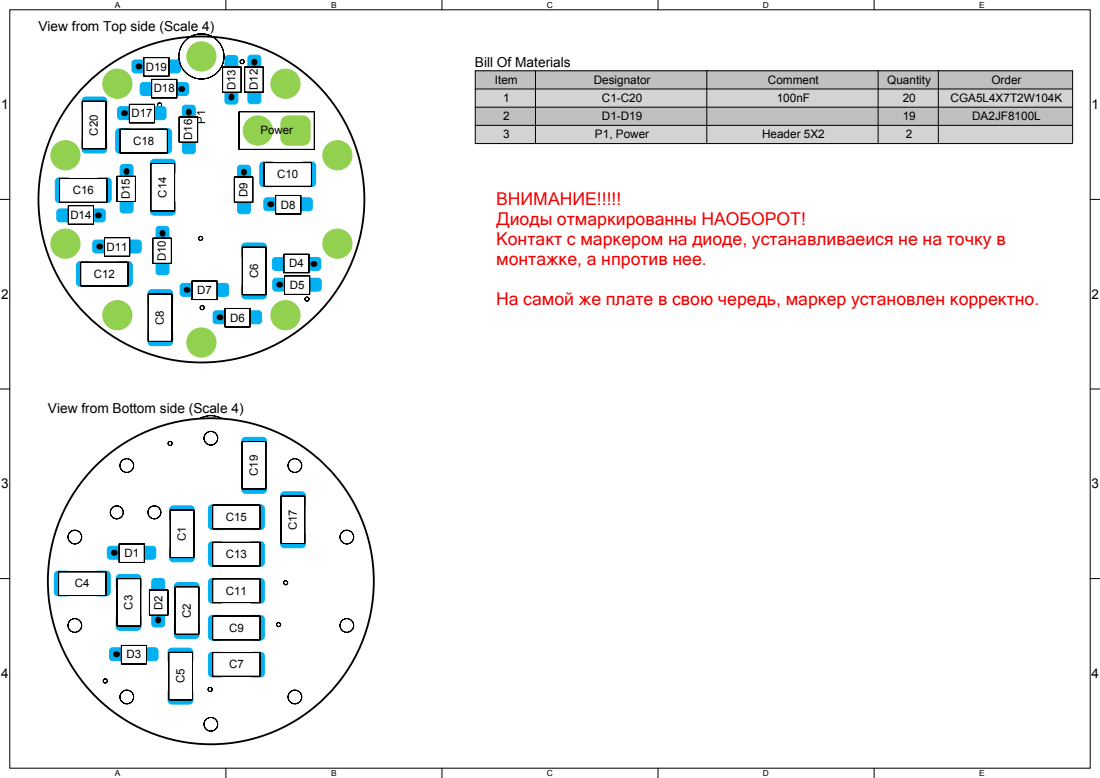
[picture p76: page 1]

View from Top side (Scale 4)

Item | Designator | Comment | Quantity | Order
1 | C1-C20 | 100nF | 20 | CGA5L4X7T2W104K

ВНИМАНИЕ!!!!!
Диоды отмаркированны НАОБОРОТ!
Контакт с маркером на диоде, устанавливаеися не на точку в
монтажке, а нпротив нее.

На самой же плате в свою чередь, маркер установлен корректно.

View from Bottom side (Scale 4)
