shodanx/Dosimeter-Ultra-Micron/Платы/PCB/ProjectOutputs/Документация.PDF

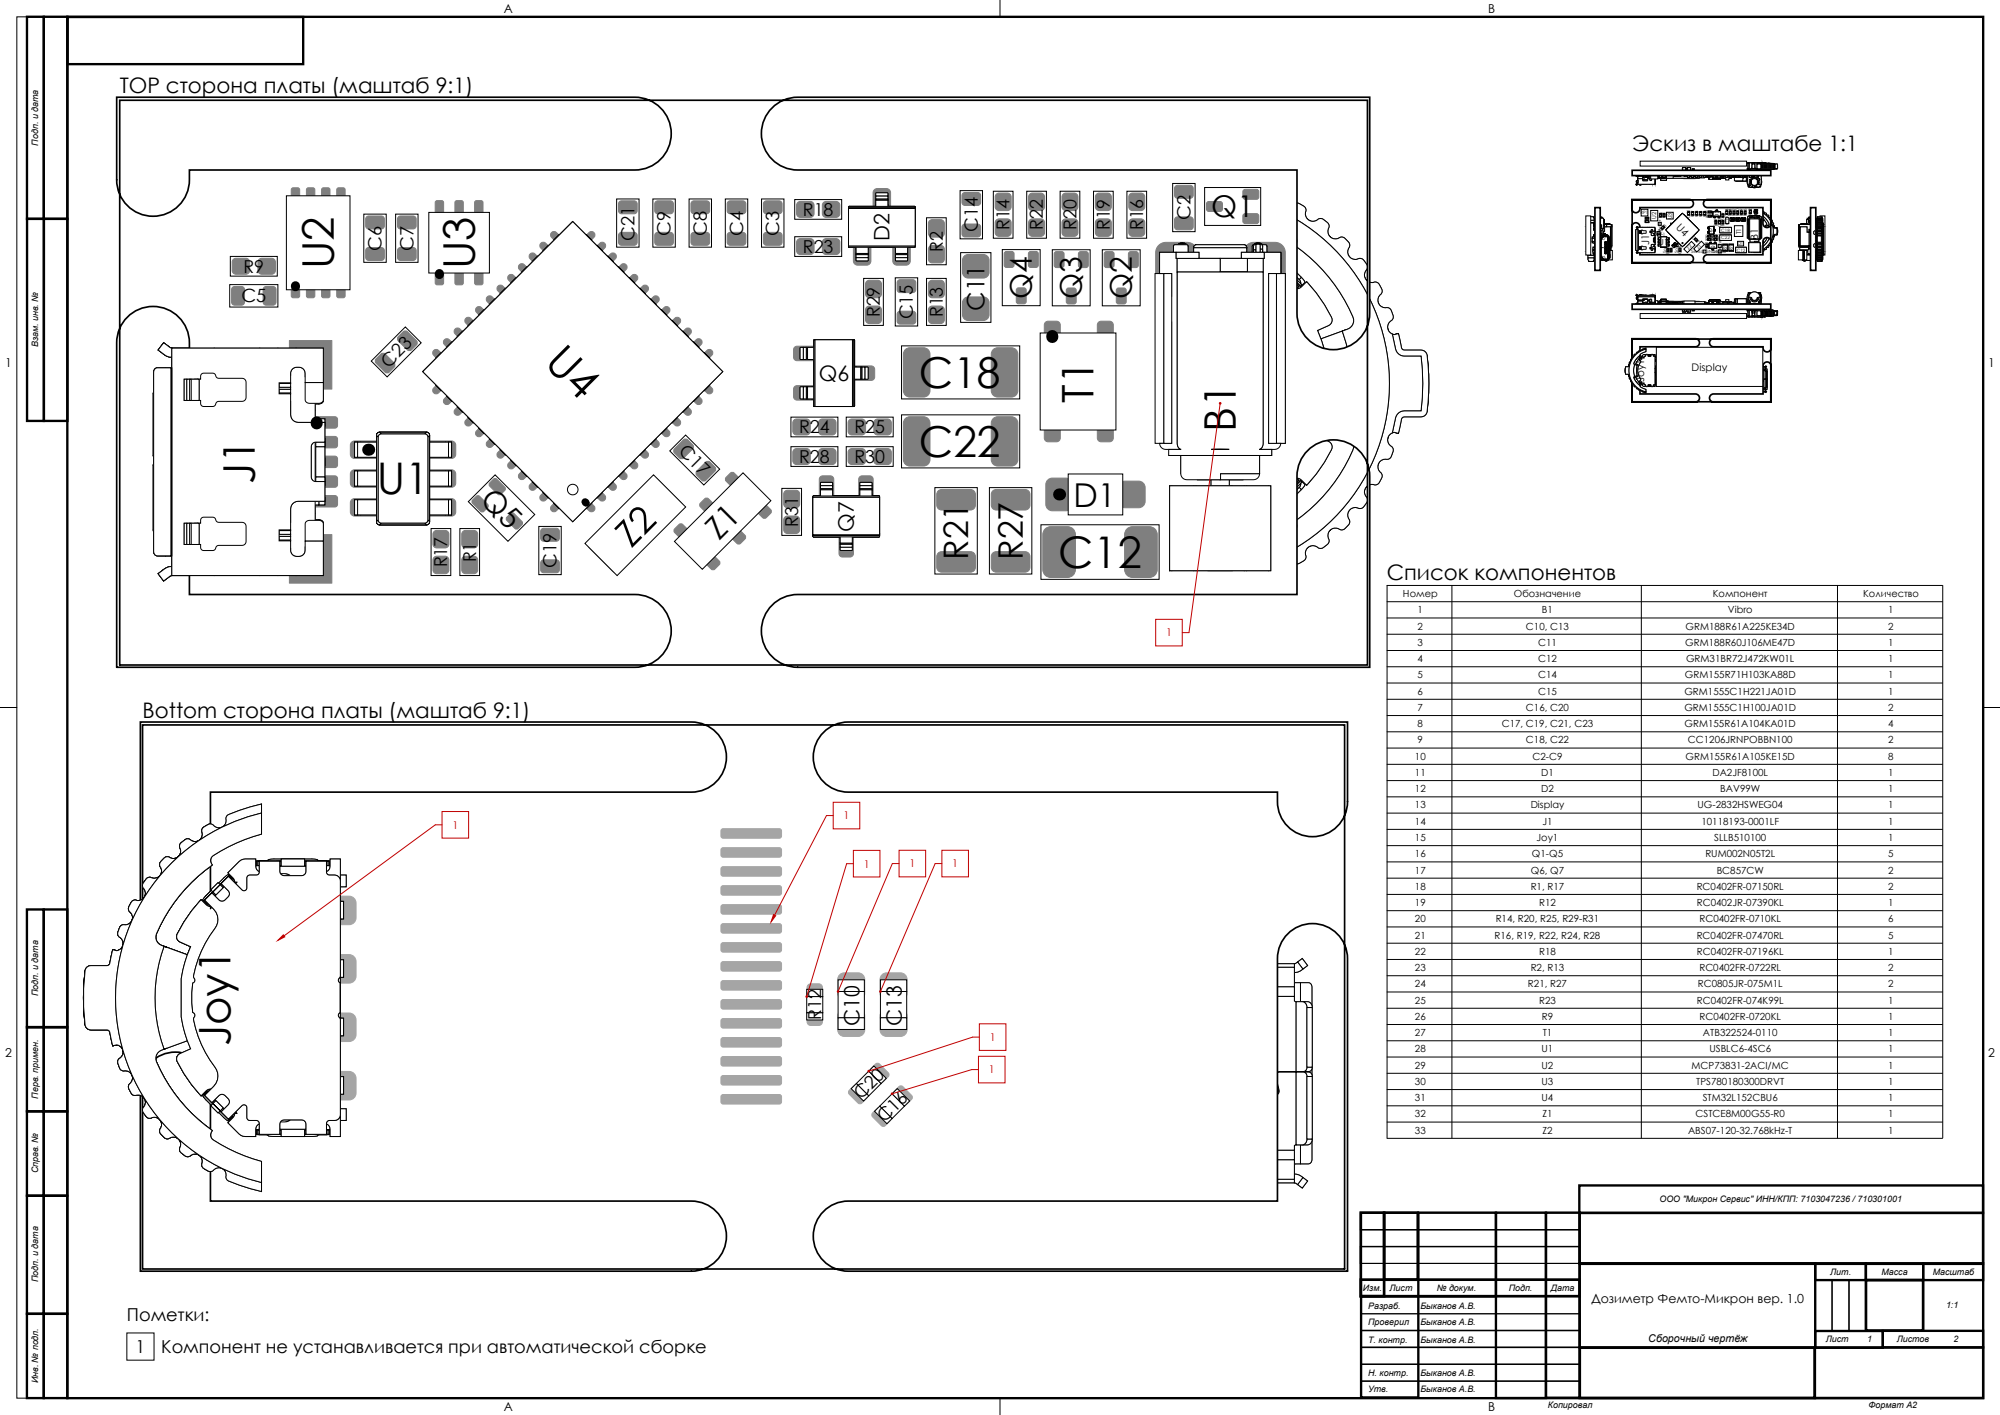
[picture p77: page 1]

TOP сторона платы (маштаб 9:1) Joy1

Инв. № подл. Подп. и дата Справ. № Перв. примен. Подп. и дата Взам. инв. № Подп. и дата

Bottom сторона платы (маштаб 9:1)

ООО "Микрон Сервис" ИНН/КПП: 7103047236 / 710301001
