shodanx/Dosimeter-Ultra-Micron/Платы/Модуль-AБ/Project Outputs for PCB_Project/Job1.PDF

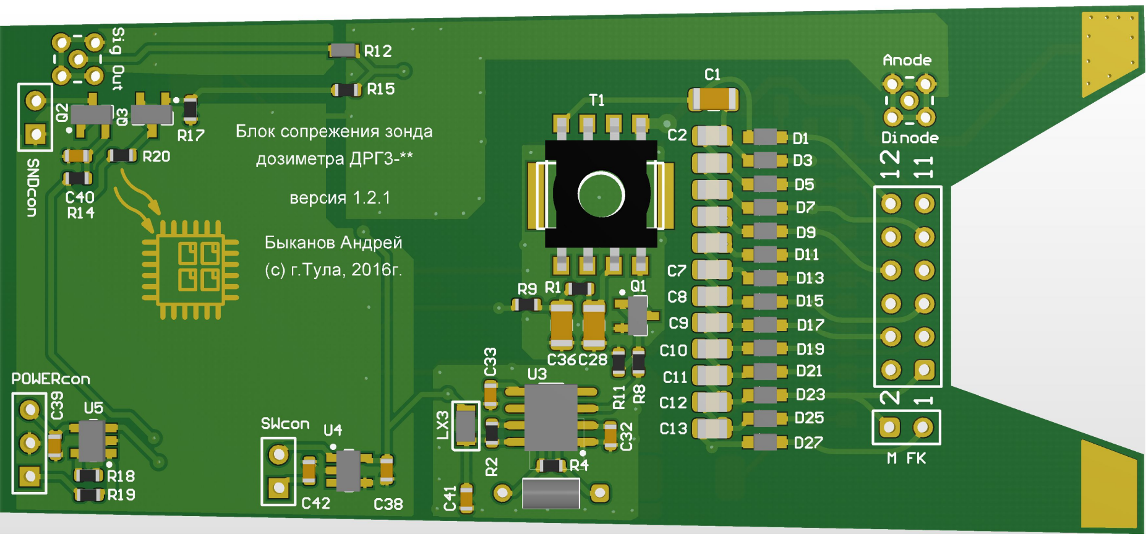
[picture p78: page 1]

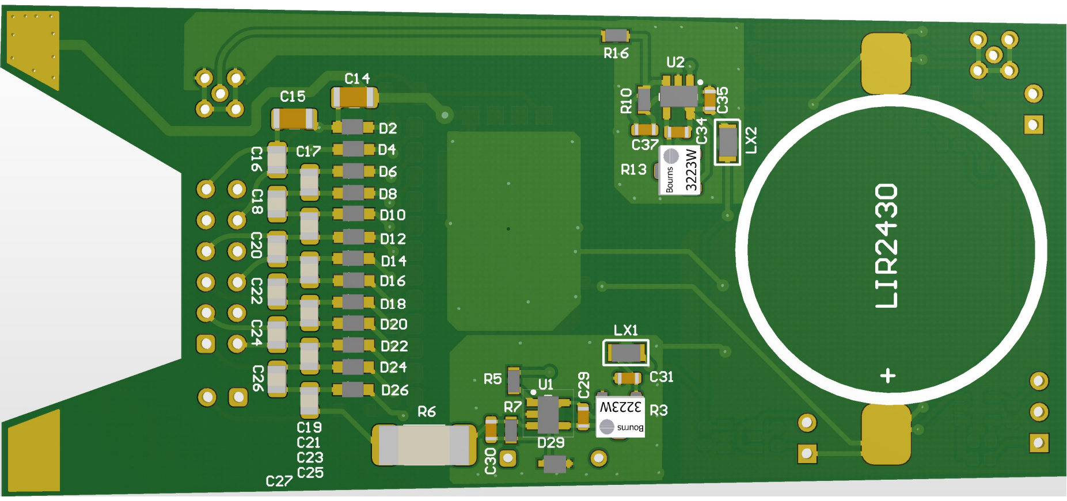
[picture p79: page 2]

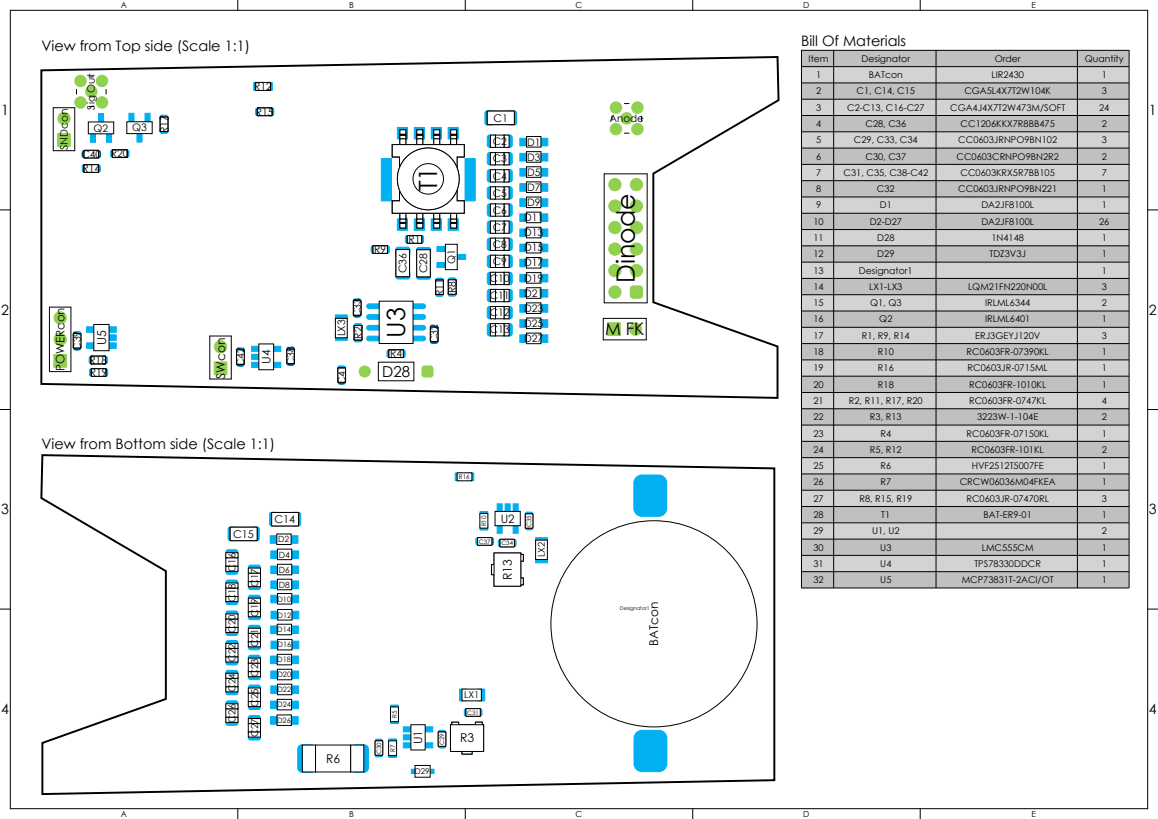
[picture p80: page 3]

View from Top side (Scale 1:1)

BATcon | LIR2430 | Quantity 13
Designator | Order
Item123456789 | C2-C13, C16-C27 | CGA4J4X7T2W473M/SOFT

C28, C36 | CC1206KKX7R8BB475

17 | R1, R9, R14 | ERJ3GEYJ120V | 261113213111421211312111

13 | Designator1
14 | LX1-LX3 | LQM21FN220N00L
15 | Q1, Q3 | IRLML6344
16 | Q2 | IRLML6401

20 | R18 | RC0603FR-1010KL
21 | R2, R11, R17, R20 | RC0603FR-0747KL
22 | R3, R13 | 3223W-1-104E
23 | R4 | RC0603FR-07150KL
24 | R5, R12 | RC0603FR-101KL
25 | R6 | HVF2512T5007FE

View from Bottom side (Scale 1:1)

27 | R8, R15, R19 | RC0603JR-07470RL
28 | T1 | BAT-ER9-01
29 | U1, U2

31 | U4 | TPS78330DDCR
32 | U5 | MCP73831T-2ACI/OT

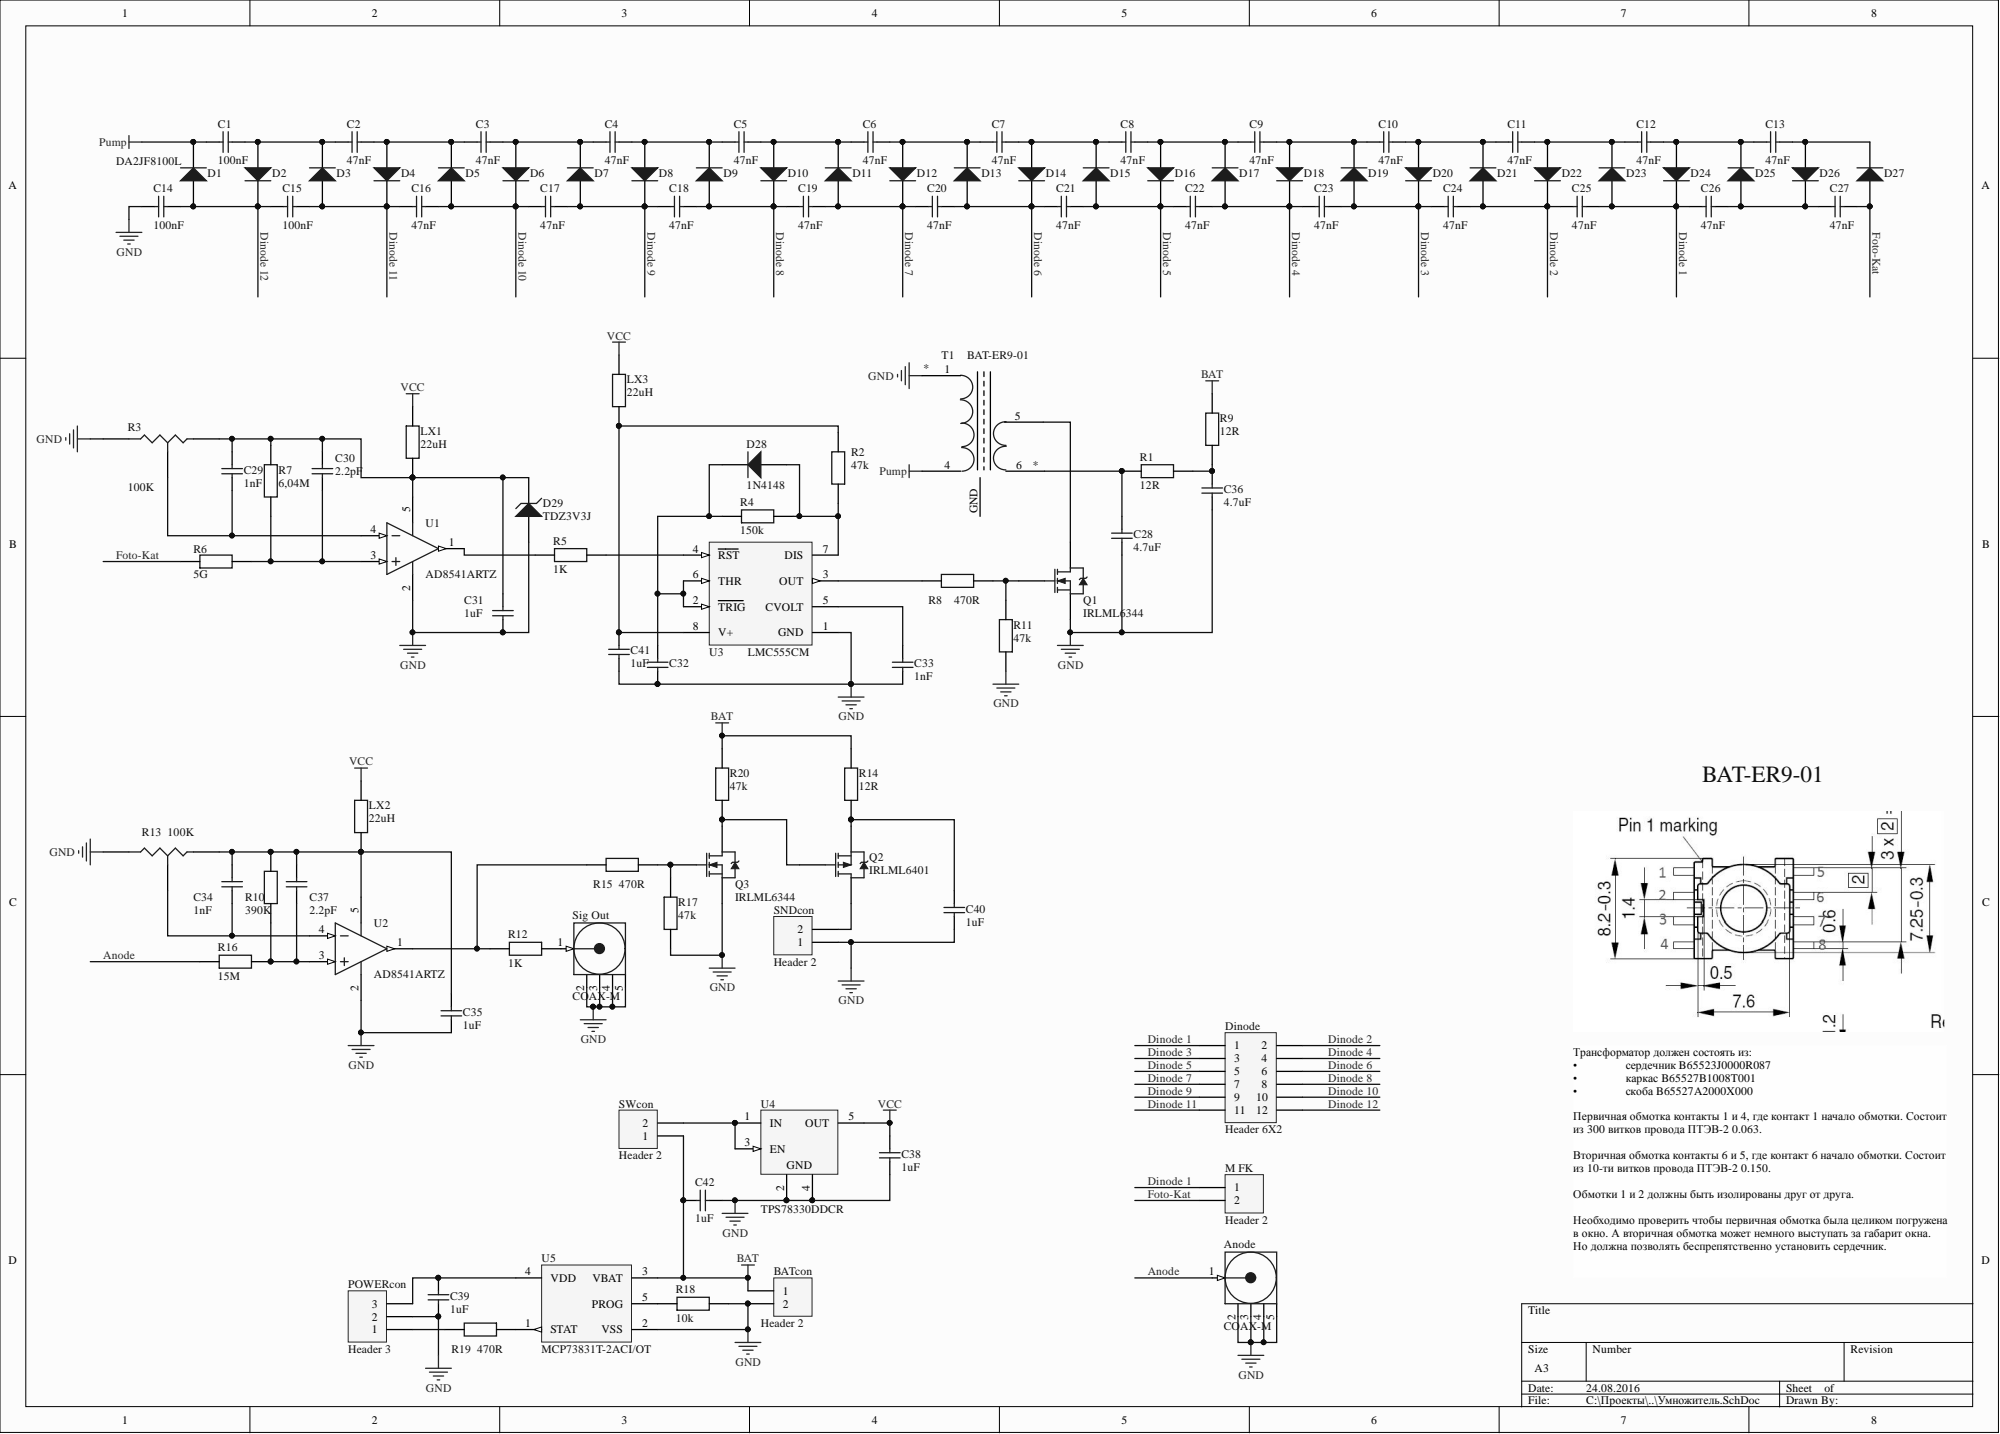
[picture p81: page 4]

Первичная обмотка контакты 1 и 4, где контакт 1 начало обмотки. Состоит
из 300 витков провода ПТЭВ-2 0.063.

Вторичная обмотка контакты 6 и 5, где контакт 6 начало обмотки. Состоит
из 10-ти витков провода ПТЭВ-2 0.150.

Обмотки 1 и 2 должны быть изолированы друг от друга.

Необходимо проверить чтобы первичная обмотка была целиком погружена
в окно. А вторичная обмотка может немного выступать за габарит окна.
Но должна позволять беспрепятственно установить сердечник.
