shodanx/Dosimeter-Ultra-Micron/Платы/Модуль-AБ/PUB_Output/Документация.PDF

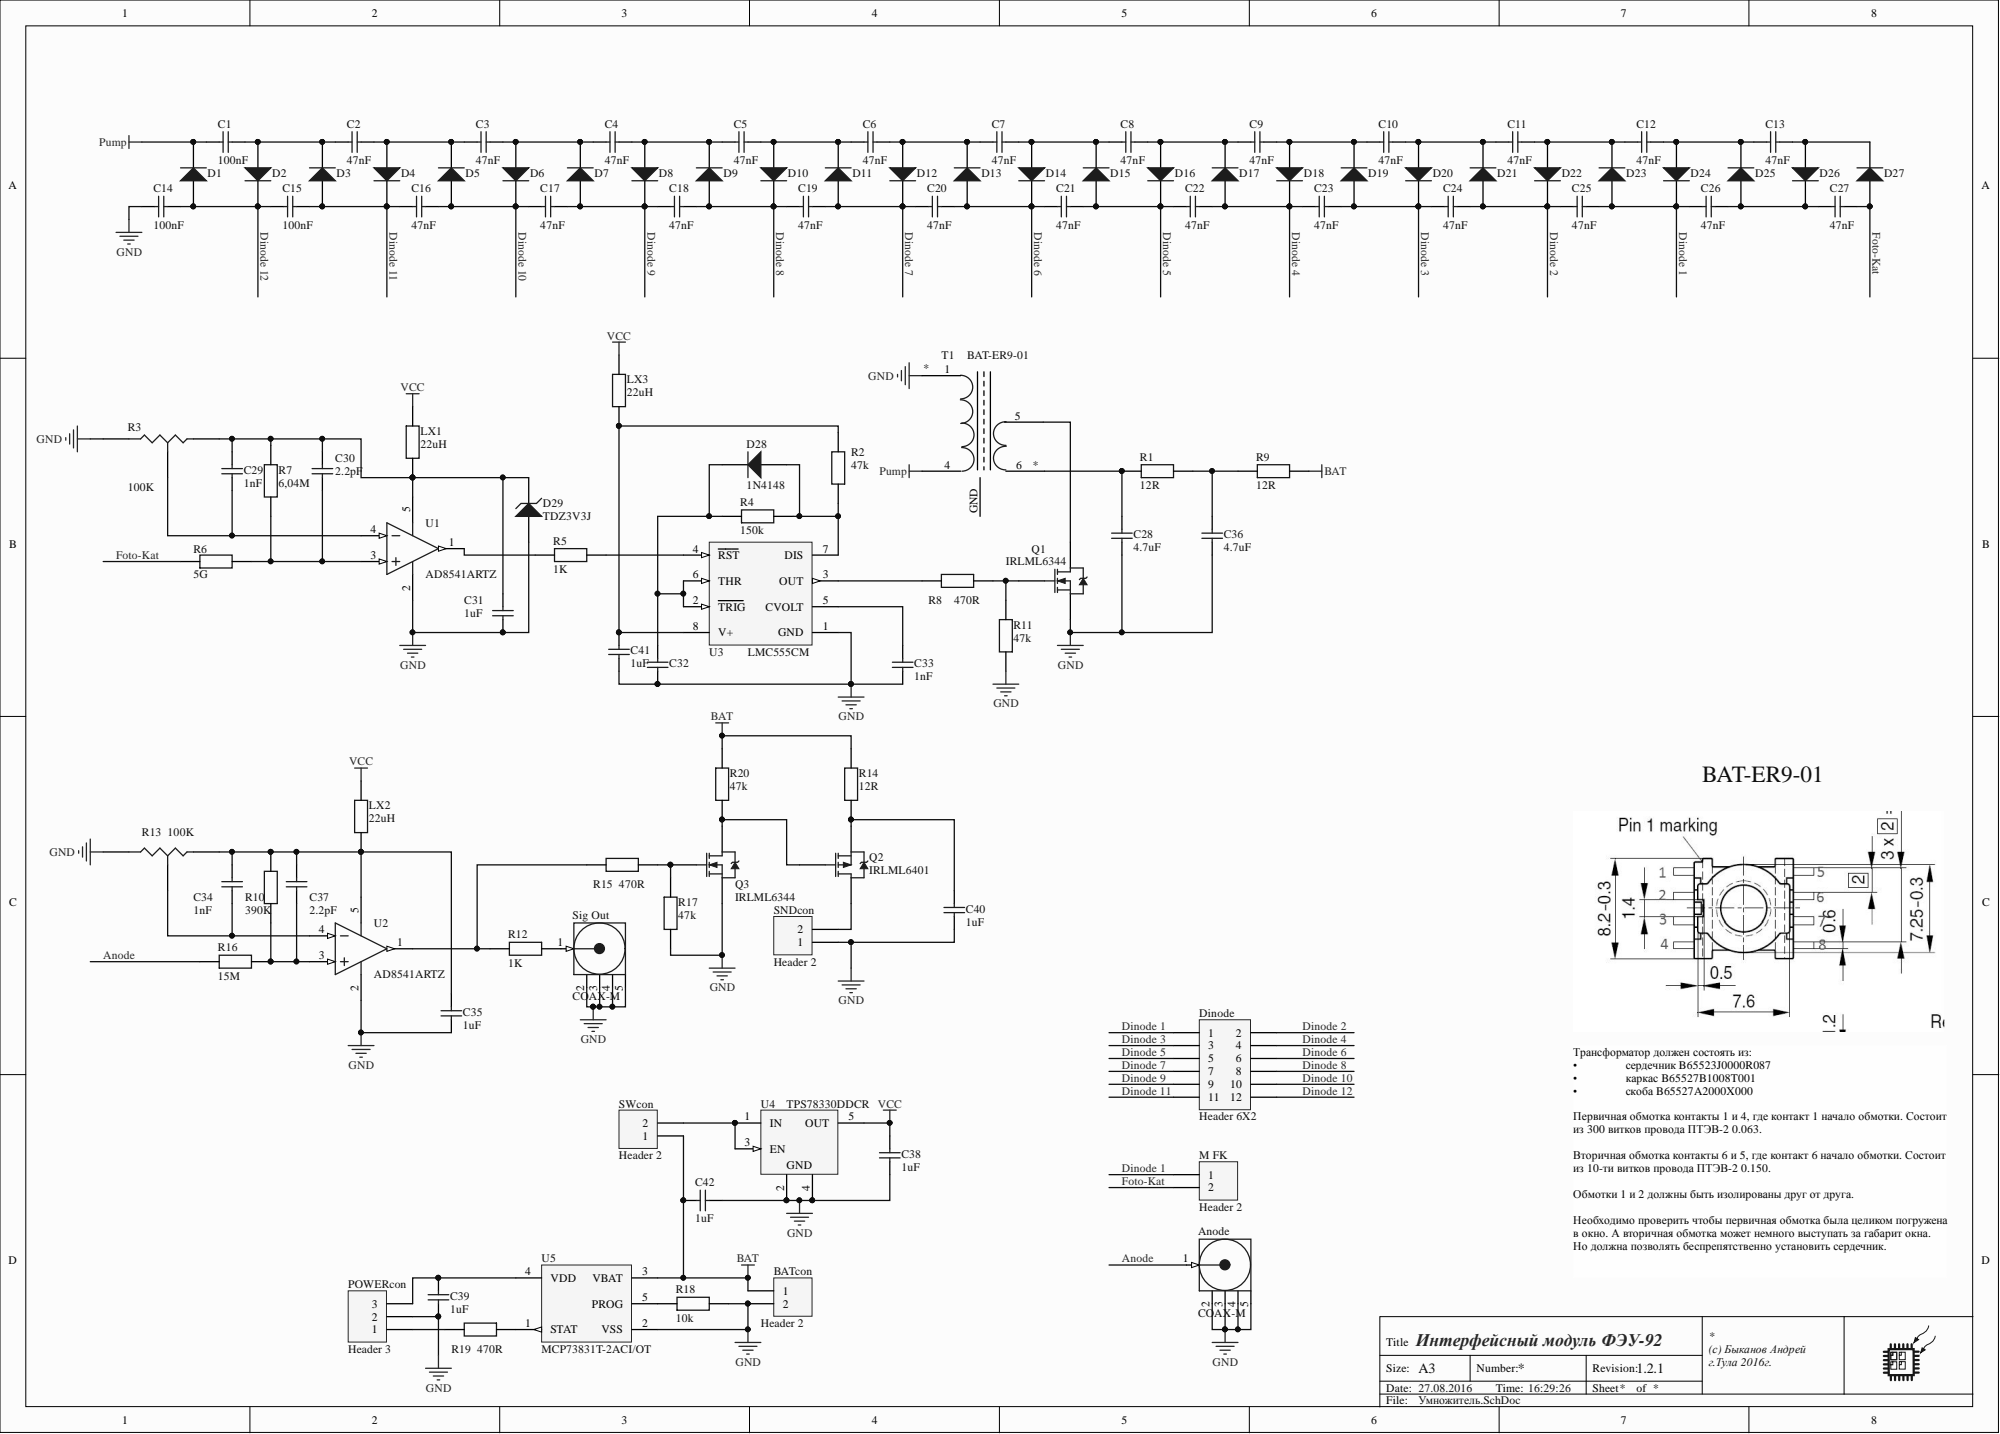
[picture p82: page 1]

Первичная обмотка контакты 1 и 4, где контакт 1 начало обмотки. Состоит
из 300 витков провода ПТЭВ-2 0.063.

Вторичная обмотка контакты 6 и 5, где контакт 6 начало обмотки. Состоит
из 10-ти витков провода ПТЭВ-2 0.150.

Обмотки 1 и 2 должны быть изолированы друг от друга.

Необходимо проверить чтобы первичная обмотка была целиком погружена
в окно. А вторичная обмотка может немного выступать за габарит окна.
Но должна позволять беспрепятственно установить сердечник.

Интерфейсный модуль ФЭУ-92 Title | * (с) Быканов Андрей г.Тула 2016г.

Size: A3 | Number: * | Revision: 1.2.1
Date: 27.08.2016 Time: 16:29:26 | | Sheet * of *

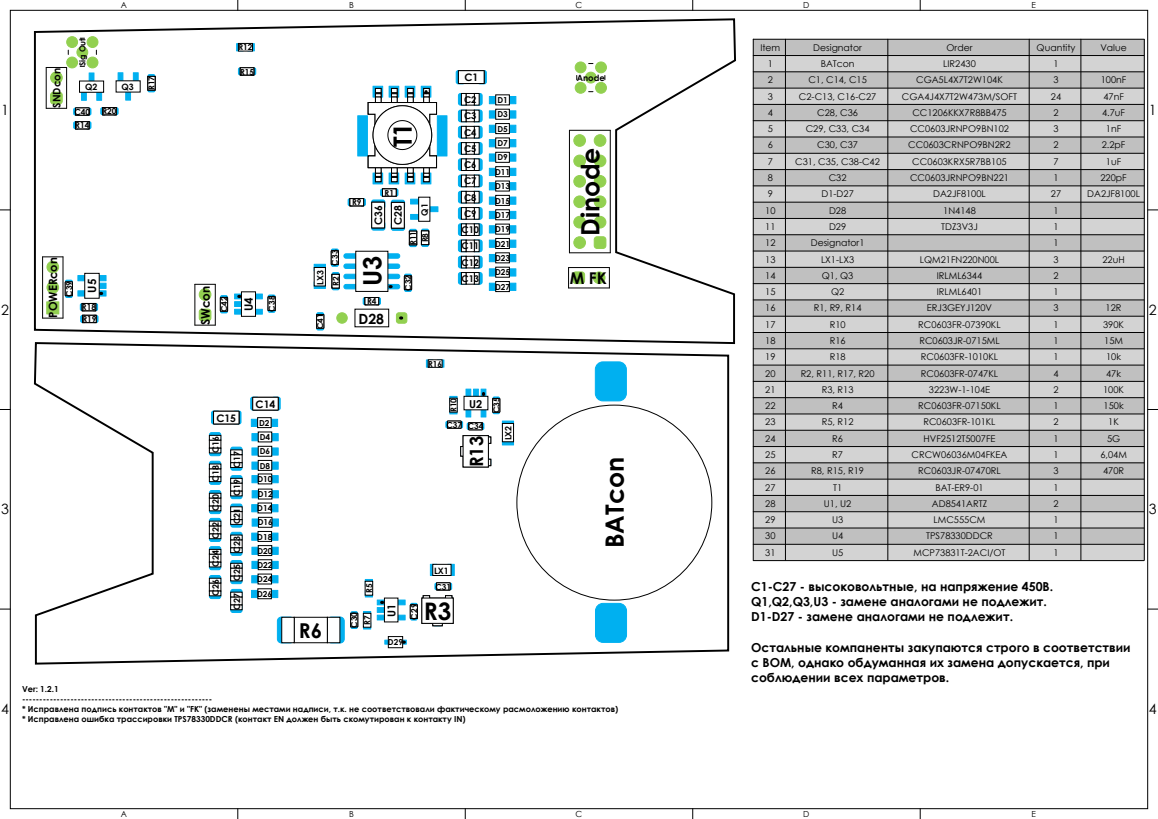
[picture p83: page 2]

Item | Designator | Order | Quantity | Value
1 | BATcon | LIR2430 | 1

10 | D28 | 1N4148 | 1
11 | D29 | TDZ3V3J | 1

18 | R16 | RC0603JR-0715ML | 1 | 15M
19 | R18 | RC0603FR-1010KL | 1 | 10k
20 | R2, R11, R17, R20 | RC0603FR-0747KL | 4 | 47k
21 | R3, R13 | 3223W-1-104E | 2 | 100K

27 | T1 | BAT-ER9-01 | 1
28 | U1, U2 | AD8541ARTZ | 2
29 | U3 | LMC555CM | 1

C1-C27 - высоковольтные, на напряжение 450В.
Q1,Q2,Q3,U3 - замене аналогами не подлежит.
D1-D27 - замене аналогами не подлежит.

Остальные компаненты закупаются строго в соответствии
с BOM, однако обдуманная их замена допускается, при
соблюдении всех параметров.

Ver: 1.2.1
* Исправлена подпись контактов "M" и "FK" (заменены местами надписи, т.к. не соответствовали фактическому расмоложению контактов)
* Исправлена ошибка трассировки TPS78330DDCR (контакт EN должен быть скомутирован к контакту IN)
