shodanx/Dosimeter-Ultra-Micron/Платы/Модуль-AБ/Draft1.asc

C1: cap; 1n
C2: cap; 220p
D1: diode; 1N4148
R1: res; 47k
R2: res; 150k
U1: NE555
V1: battery; 10
Named nets: 0, OUT, CAP
.tran 1
