shodanx/Dosimeter-Ultra-Micron/(list of files, drawings)

Other design files:
simulation.pdsprj
Платы/PCB/Micron-6.PrjPcb
Платы/PCB/Micron-6.SchDoc
Платы/PCB/Micron-6_00_small border.PcbDoc
Платы/PCB/Rezonit_pannels.PcbDoc
Платы/Модуль-AБ/HV.PcbDoc
Платы/Модуль-AБ/Modul-A.PrjPcb
Платы/Модуль-AБ/sim.SchDoc
Платы/Модуль-AБ/simulation.pdsprj
Платы/Модуль-AБ/Умножитель.SchDoc
Платы/Модуль-А1/HV.PcbDoc
Платы/Модуль-А1/Modul-A.PrjPcb
Платы/Модуль-А1/sim.SchDoc
Платы/Модуль-А1/simulation.pdsprj
Платы/Модуль-А1/Умножитель.SchDoc
Платы/Модуль-А2/ФЭУ-102-1-плата-управления/HV.PcbDoc
Платы/Модуль-А2/ФЭУ-102-1-плата-управления/Modul-A.PrjPcb
Платы/Модуль-А2/ФЭУ-102-1-плата-управления/sim.SchDoc
Платы/Модуль-А2/ФЭУ-102-1-плата-управления/simulation.pdsprj
Платы/Модуль-А2/ФЭУ-102-1-плата-управления/Умножитель.SchDoc
Платы/Модуль-А2/ФЭУ-102-1_part0.5/FEU-102-1_part0.PcbDoc
Платы/Модуль-А2/ФЭУ-102-1_part0.5/FEU-102-1_part0.PrjPcb
Платы/Модуль-А2/ФЭУ-102-1_part0.5/FEU-102-1_part0.SchDoc
Платы/Модуль-А2/ФЭУ-102-1_part0/FEU-102-1_part0.PcbDoc
Платы/Модуль-А2/ФЭУ-102-1_part0/FEU-102-1_part0.PrjPcb
Платы/Модуль-А2/ФЭУ-102-1_part0/FEU-102-1_part0.SchDoc
Платы/Модуль-А2/ФЭУ-102-1_part1/FEU-102-1_part1.PcbDoc
Платы/Модуль-А2/ФЭУ-102-1_part1/FEU-102-1_part1.PrjPcb
Платы/Модуль-А2/ФЭУ-102-1_part1/FEU-102-1_part1.SchDoc
Платы/Модуль-А2/ФЭУ-102-1_part2.5/FEU-102-1_part2.PcbDoc
Платы/Модуль-А2/ФЭУ-102-1_part2.5/FEU-102-1_part2.PrjPcb
Платы/Модуль-А2/ФЭУ-102-1_part2.5/FEU-102-1_part2.SchDoc
Платы/Модуль-А2/ФЭУ-102-1_part2/FEU-102-1_part2.PcbDoc
Платы/Модуль-А2/ФЭУ-102-1_part2/FEU-102-1_part2.PrjPcb
Платы/Модуль-А2/ФЭУ-102-1_part2/FEU-102-1_part2.SchDoc
Платы/Модуль-А2/ФЭУ-102-1_part3.5/FEU-102-1_part3.PcbDoc
Платы/Модуль-А2/ФЭУ-102-1_part3.5/FEU-102-1_part3.PrjPcb
Платы/Модуль-А2/ФЭУ-102-1_part3.5/FEU-102-1_part3.SchDoc
Платы/Модуль-А2/ФЭУ-102-1_part3/FEU-102-1_part3.PcbDoc
Платы/Модуль-А2/ФЭУ-102-1_part3/FEU-102-1_part3.PrjPcb
Платы/Модуль-А2/ФЭУ-102-1_part3/FEU-102-1_part3.SchDoc
Платы/Модуль-А2/ФЭУ-102-1_part4.5/FEU-102-1_part4.PcbDoc
Платы/Модуль-А2/ФЭУ-102-1_part4.5/FEU-102-1_part4.PrjPcb
Платы/Модуль-А2/ФЭУ-102-1_part4.5/FEU-102-1_part4.SchDoc
Платы/Модуль-А2/ФЭУ-102-1_part4/FEU-102-1_part4.PcbDoc
Платы/Модуль-А2/ФЭУ-102-1_part4/FEU-102-1_part4.PrjPcb
Платы/Модуль-А2/ФЭУ-102-1_part4/FEU-102-1_part4.SchDoc
Платы/Модуль-А2/ФЭУ-102-1_part5/FEU-102-1_part5.PcbDoc
Платы/Модуль-А2/ФЭУ-102-1_part5/FEU-102-1_part5.PrjPcb
Платы/Модуль-А2/ФЭУ-102-1_part5/FEU-102-1_part5.SchDoc
Платы/Модуль-А3/R1306/FEU31_Part2.PcbDoc
Платы/Модуль-А3/R1306/FEU31_Part2.PrjPcb
Платы/Модуль-А3/R1306/FEU31_Part2.SchDoc
Платы/Модуль-А3/Групповушка/FEU31_Part1.PcbDoc
Платы/Модуль-А3/Групповушка/FEU31_Part1.PrjPcb
Платы/Модуль-А3/Групповушка/FEU31_Part1.SchDoc
Платы/Модуль-А3/ФЭУ-31-вычислительная/FEU31_Part3.PcbDoc
Платы/Модуль-А3/ФЭУ-31-вычислительная/FEU31_Part3.PrjPcb
Платы/Модуль-А3/ФЭУ-31-вычислительная/FEU31_Part3.SchDoc
Платы/Модуль-А3/ФЭУ-31-вычислительная/FEU31_Part3_old.PcbDoc
Платы/Модуль-А3/ФЭУ-31-держатель/FEU31_Part1.PcbDoc
Платы/Модуль-А3/ФЭУ-31-держатель/FEU31_Part1.PrjPcb
Платы/Модуль-А3/ФЭУ-31-держатель/FEU31_Part1.SchDoc
Платы/Модуль-А3/ФЭУ-31-заглушка/Труба.PcbDoc
Платы/Модуль-А3/ФЭУ-31-заглушка/Труба_сенсор.PcbDoc
Платы/Модуль-А3/ФЭУ-31-конденсаторная/FEU31_Part2.PcbDoc
Платы/Модуль-А3/ФЭУ-31-конденсаторная/FEU31_Part2.PrjPcb
Платы/Модуль-А3/ФЭУ-31-конденсаторная/FEU31_Part2.SchDoc
Платы/Модуль-А3/ФЭУ-31-прокладка/FEU31_Part2.PcbDoc
Платы/Модуль-А3/ФЭУ-31-прокладка/FEU31_Part2.PrjPcb
Платы/Модуль-А3/ФЭУ-31-прокладка/FEU31_Part2.SchDoc
Платы/Модуль-А3/ФЭУ-31-трансформаторная/FEU31_Part2.PcbDoc
Платы/Модуль-А3/ФЭУ-31-трансформаторная/FEU31_Part2.PrjPcb
Платы/Модуль-А3/ФЭУ-31-трансформаторная/FEU31_Part2.SchDoc
Платы/Модуль-А3/ФЭУ-31-умножитель/FEU31_Part1.PcbDoc
Платы/Модуль-А3/ФЭУ-31-умножитель/FEU31_Part1.PrjPcb
Платы/Модуль-А3/ФЭУ-31-умножитель/FEU31_Part1.SchDoc
Платы/Модуль-А/HV.PcbDoc
Платы/Модуль-А/Modul-A.PrjPcb
Платы/Модуль-А/sim.SchDoc
Платы/Модуль-А/simulation.pdsprj
Платы/Модуль-А/Умножитель.SchDoc
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
