shodanx/Dosimeter-Ultra-Micron/(commit log)

2022-06-08 Игнор
2022-06-08 Жир!
    [2_Lay_PCB.PcbDoc, 4_Lay_PCB.PcbDoc, BOM Micron-6.XLS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]
